fedosgad/TD4/README.md

# TD4
Schematics, PCBs and SystemVerilog simulation for extended version of TD4 CPU.

All circuit-related work done in KiCad.

Verilog file are (will be) under verilog/ folder
