fedosgad/TD4/front_panel/front_panel.kicad_pcb

## KiCad design front_panel/front_panel.kicad_pcb (2019-03-29)

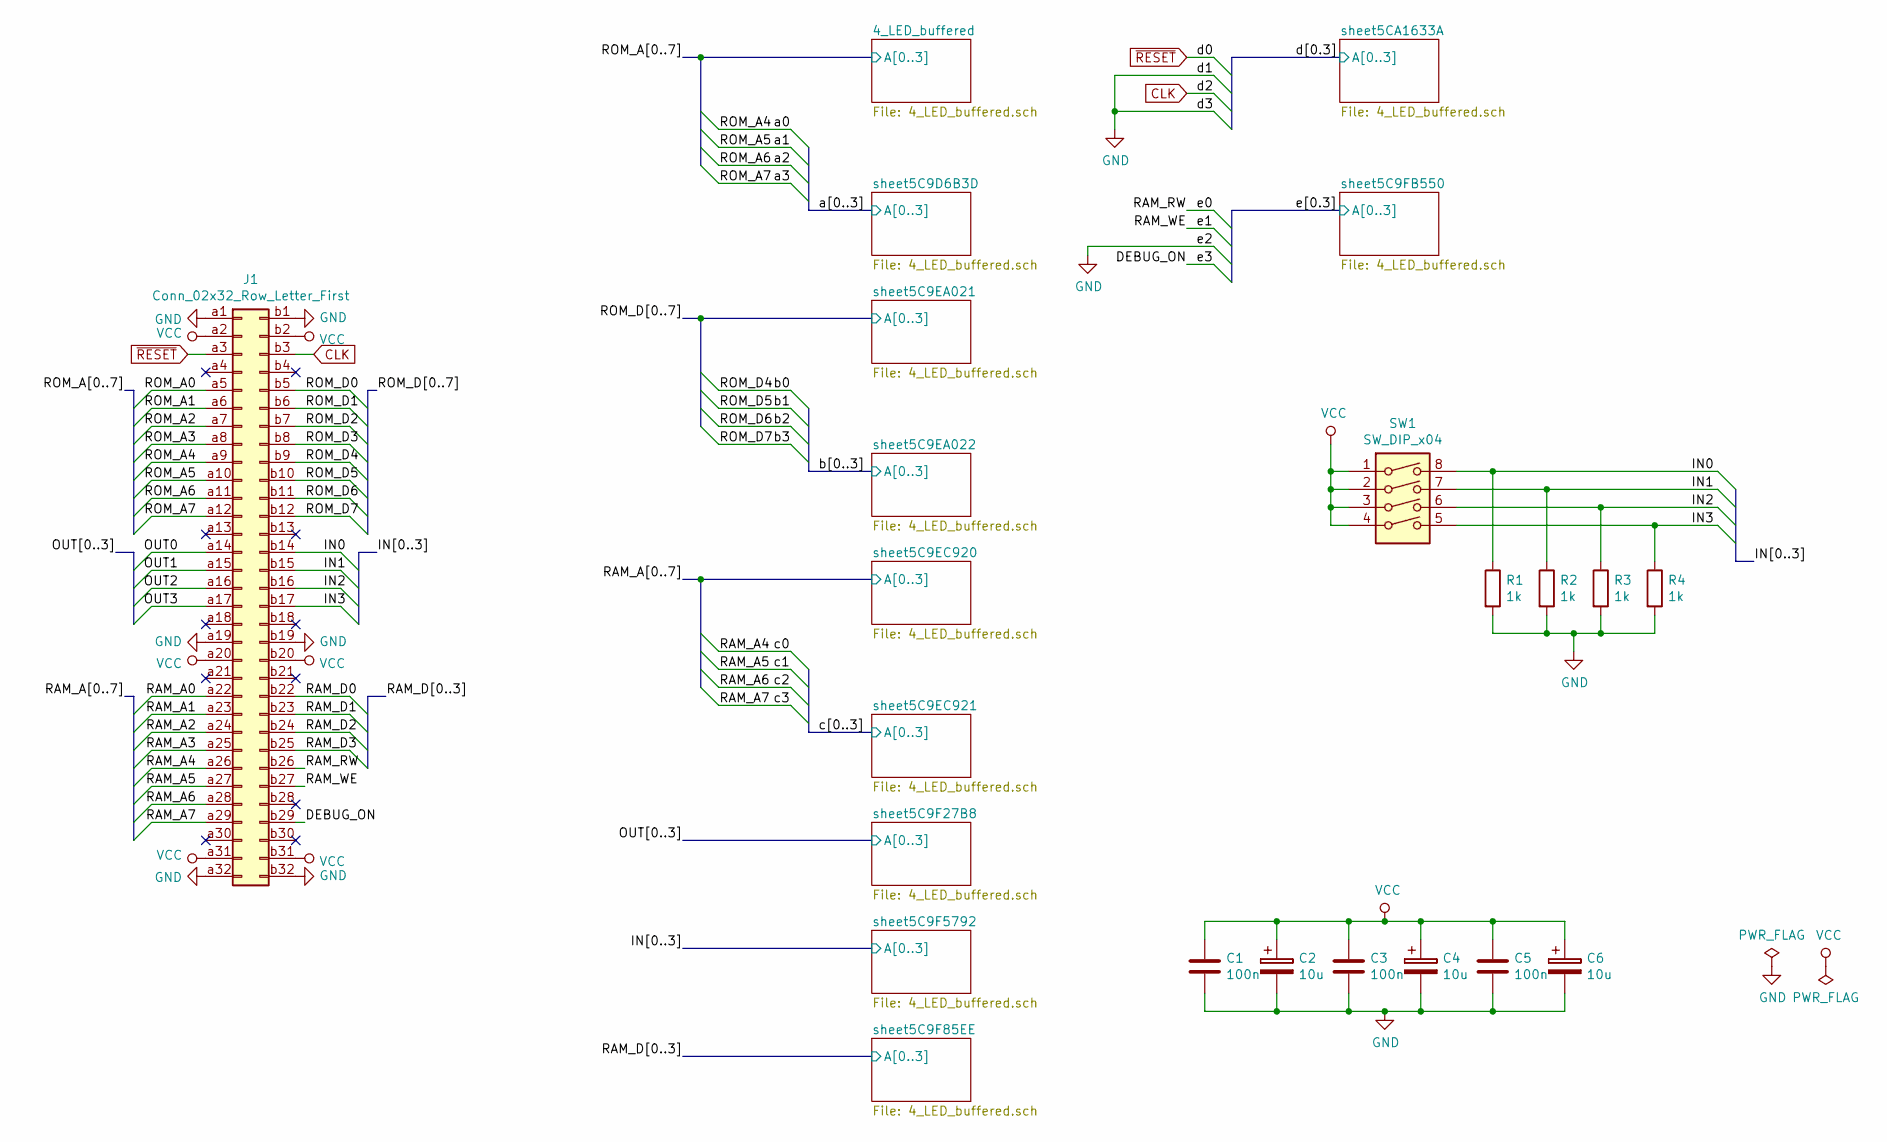
[picture p1: schematic front_panel.sch]

Parts:
C1, C3, C5: 100n; C_0805_2012Metric
C2, C4, C6: 10u; CP_EIA-3216-18_Kemet-A
J1: Conn_02x32_Row_Letter_First; DIN41612_B_2x32_Horizontal
R1, R2, R3, R4: 1k; R_0805_2012Metric
SW1: SW_DIP_x04; SW_DIP_SPSTx04_Slide_9.78x12.34mm_W7.62mm_P2.54mm

Connections:
/DEBUG_ON: J1.b29; also elsewhere on the board
/IN0: J1.b14, R1.1, SW1.8; also elsewhere on the board
/IN1: J1.b15, R2.1, SW1.7; also elsewhere on the board
/IN2: J1.b16, R3.1, SW1.6; also elsewhere on the board
/IN3: J1.b17, R4.1, SW1.5; also elsewhere on the board
/OUT0: J1.a14; also elsewhere on the board
/OUT1: J1.a15; also elsewhere on the board
/OUT2: J1.a16; also elsewhere on the board
/OUT3: J1.a17; also elsewhere on the board
/RAM_A0: J1.a22; also elsewhere on the board
/RAM_A1: J1.a23; also elsewhere on the board
/RAM_A2: J1.a24; also elsewhere on the board
/RAM_A3: J1.a25; also elsewhere on the board
/RAM_A4: J1.a26; also elsewhere on the board
/RAM_A5: J1.a27; also elsewhere on the board
/RAM_A6: J1.a28; also elsewhere on the board
/RAM_A7: J1.a29; also elsewhere on the board
/RAM_D0: J1.b22; also elsewhere on the board
/RAM_D1: J1.b23; also elsewhere on the board
/RAM_D2: J1.b24; also elsewhere on the board
/RAM_D3: J1.b25; also elsewhere on the board
/RAM_RW: J1.b26; also elsewhere on the board
/RAM_WE: J1.b27; also elsewhere on the board
/ROM_A0: J1.a5; also elsewhere on the board
/ROM_A1: J1.a6; also elsewhere on the board
/ROM_A2: J1.a7; also elsewhere on the board
/ROM_A3: J1.a8; also elsewhere on the board
/ROM_A4: J1.a9; also elsewhere on the board
/ROM_A5: J1.a10; also elsewhere on the board
/ROM_A6: J1.a11; also elsewhere on the board
/ROM_A7: J1.a12; also elsewhere on the board
/ROM_D0: J1.b5; also elsewhere on the board
/ROM_D1: J1.b6; also elsewhere on the board
/ROM_D2: J1.b7; also elsewhere on the board
/ROM_D3: J1.b8; also elsewhere on the board
/ROM_D4: J1.b9; also elsewhere on the board
/ROM_D5: J1.b10; also elsewhere on the board
/ROM_D6: J1.b11; also elsewhere on the board
/ROM_D7: J1.b12; also elsewhere on the board
CLK: J1.b3; also elsewhere on the board
GND: C1.2, C2.2, C3.2, C4.2, C5.2, C6.2, J1.a1, J1.a19, J1.a32, J1.b1, J1.b19, J1.b32, R1.2, R2.2, R3.2, R4.2; also elsewhere on the board
VCC: C1.1, C2.1, C3.1, C4.1, C5.1, C6.1, J1.a2, J1.a20, J1.a31, J1.b2, J1.b20, J1.b31, SW1.1, SW1.2, SW1.3, SW1.4; also elsewhere on the board
~RESET: J1.a3; also elsewhere on the board

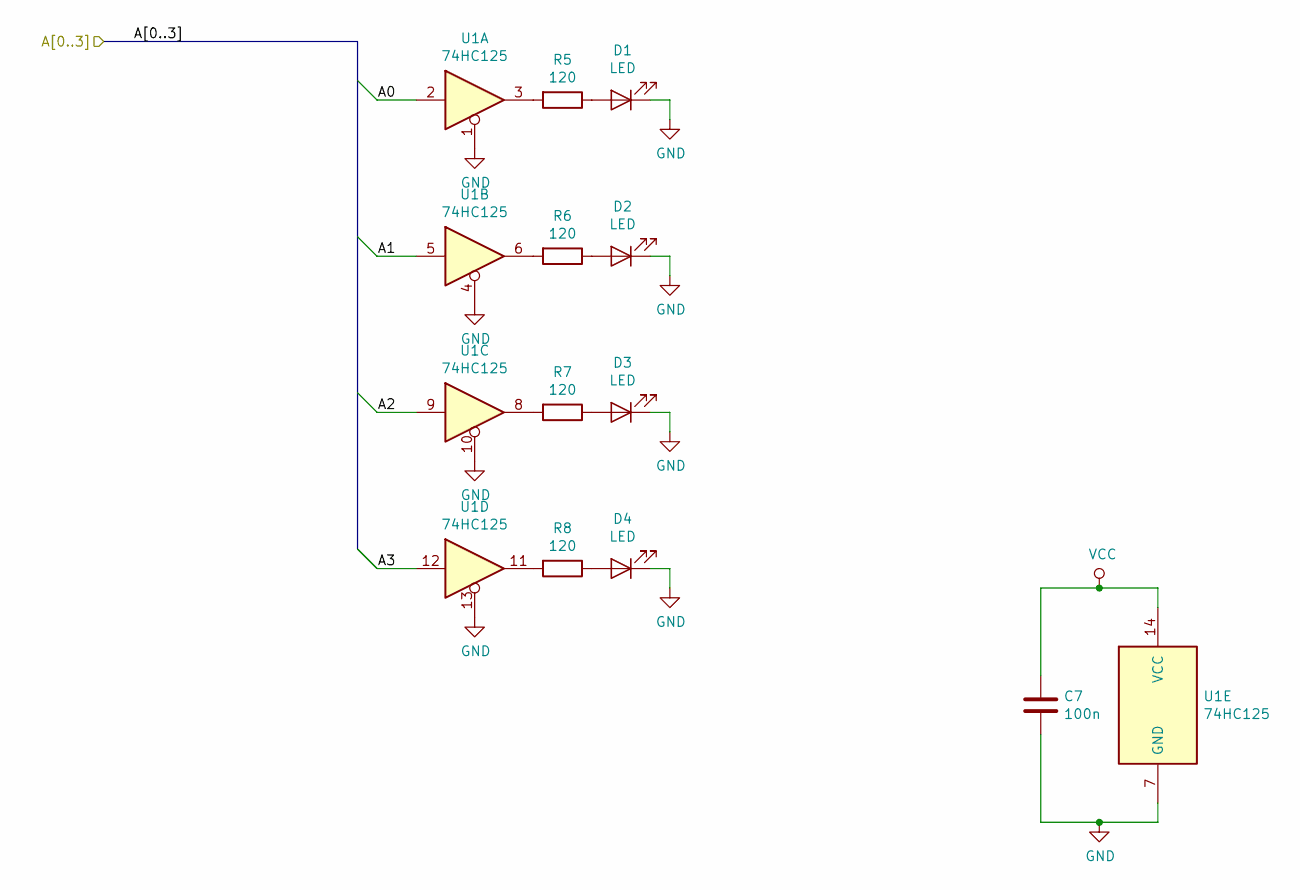
[picture p2: schematic 4_LED_buffered.sch]

Parts:
C7: 100n; C_0805_2012Metric
D1, D2, D3, D4: LED; LED_D5.0mm
R5, R6, R7, R8: 120; R_0805_2012Metric
U1: 74HC125; SOIC-14_3.9x8.7mm_P1.27mm

Connections:
/ROM_A0: U1.2; also elsewhere on the board
/ROM_A1: U1.5; also elsewhere on the board
/ROM_A2: U1.9; also elsewhere on the board
/ROM_A3: U1.12; also elsewhere on the board
GND: C7.2, D1.1 (K), D2.1 (K), D3.1 (K), D4.1 (K), U1.1, U1.4, U1.7 (GND), U1.10, U1.13; also elsewhere on the board
unnamed: D1.2 (A), R5.1
unnamed: D2.2 (A), R6.1
unnamed: D3.2 (A), R7.1
unnamed: D4.2 (A), R8.1
unnamed: R5.2, U1.3
unnamed: R6.2, U1.6
unnamed: R7.2, U1.8
unnamed: R8.2, U1.11
VCC: C7.1, U1.14 (VCC); also elsewhere on the board

Parts of its further copies:
C8, C9, C10, C11, C12, C13, C14, C15, C16, C17: 100n; C_0805_2012Metric
D5, D6, D7, D8, D9, D10, D11, D12, D13, D14, D15, D16, D17, D18, D19, D20, D21, D22, D23, D24, D25, D26, D27, D28, D29, D30, D31, D32, D33, D34, D35, D36, D37, D38, D39, D40, D41, D42, D43, D44: LED; LED_D5.0mm
R9, R10, R11, R12, R13, R14, R15, R16, R17, R18, R19, R20, R21, R22, R23, R24, R25, R26, R27, R28, R29, R30, R31, R32, R33, R34, R35, R36, R37, R38, R39, R40, R41, R42, R43, R44, R45, R46, R47, R48: 120; R_0805_2012Metric
U2, U3, U4, U5, U6, U7, U8, U9, U10, U11: 74HC125; SOIC-14_3.9x8.7mm_P1.27mm

Connections of its further copies:
/DEBUG_ON: U10.12; also elsewhere on the board
/IN0: U8.2; also elsewhere on the board
/IN1: U8.5; also elsewhere on the board
/IN2: U8.9; also elsewhere on the board
/IN3: U8.12; also elsewhere on the board
/OUT0: U7.2; also elsewhere on the board
/OUT1: U7.5; also elsewhere on the board
/OUT2: U7.9; also elsewhere on the board
/OUT3: U7.12; also elsewhere on the board
/RAM_A0: U5.2; also elsewhere on the board
/RAM_A1: U5.5; also elsewhere on the board
/RAM_A2: U5.9; also elsewhere on the board
/RAM_A3: U5.12; also elsewhere on the board
/RAM_A4: U6.2; also elsewhere on the board
/RAM_A5: U6.5; also elsewhere on the board
/RAM_A6: U6.9; also elsewhere on the board
/RAM_A7: U6.12; also elsewhere on the board
/RAM_D0: U9.2; also elsewhere on the board
/RAM_D1: U9.5; also elsewhere on the board
/RAM_D2: U9.9; also elsewhere on the board
/RAM_D3: U9.12; also elsewhere on the board
/RAM_RW: U10.2; also elsewhere on the board
/RAM_WE: U10.5; also elsewhere on the board
/ROM_A4: U2.2; also elsewhere on the board
/ROM_A5: U2.5; also elsewhere on the board
/ROM_A6: U2.9; also elsewhere on the board
/ROM_A7: U2.12; also elsewhere on the board
/ROM_D0: U3.2; also elsewhere on the board
/ROM_D1: U3.5; also elsewhere on the board
/ROM_D2: U3.9; also elsewhere on the board
/ROM_D3: U3.12; also elsewhere on the board
/ROM_D4: U4.2; also elsewhere on the board
/ROM_D5: U4.5; also elsewhere on the board
/ROM_D6: U4.9; also elsewhere on the board
/ROM_D7: U4.12; also elsewhere on the board
CLK: U11.9; also elsewhere on the board
GND: C8.2, C9.2, C10.2, C11.2, C12.2, C13.2, C14.2, C15.2, C16.2, C17.2, D5.1 (K), D6.1 (K), D7.1 (K), D8.1 (K), D9.1 (K), D10.1 (K), D11.1 (K), D12.1 (K), D13.1 (K), D14.1 (K), D15.1 (K), D16.1 (K), D17.1 (K), D18.1 (K), D19.1 (K), D20.1 (K), D21.1 (K), D22.1 (K), D23.1 (K), D24.1 (K), D25.1 (K), D26.1 (K), D27.1 (K), D28.1 (K), D29.1 (K), D30.1 (K), D31.1 (K), D32.1 (K), D33.1 (K), D34.1 (K), D35.1 (K), D36.1 (K), D37.1 (K), D38.1 (K), D39.1 (K), D40.1 (K), D41.1 (K), D42.1 (K), D43.1 (K), D44.1 (K), U2.1, U2.4, U2.7 (GND), U2.10, U2.13, U3.1, U3.4, U3.7 (GND), U3.10, U3.13, U4.1, U4.4, U4.7 (GND), U4.10, U4.13, U5.1, U5.4, U5.7 (GND), U5.10, U5.13, U6.1, U6.4, U6.7 (GND), U6.10, U6.13, U7.1, U7.4, U7.7 (GND), U7.10, U7.13, U8.1, U8.4, U8.7 (GND), U8.10, U8.13, U9.1, U9.4, U9.7 (GND), U9.10, U9.13, U10.1, U10.4, U10.7 (GND), U10.9, U10.10, U10.13, U11.1, U11.4, U11.5, U11.7 (GND), U11.10, U11.12, U11.13; also elsewhere on the board
unnamed: D5.2 (A), R9.1
unnamed: D6.2 (A), R10.1
unnamed: D7.2 (A), R11.1
unnamed: D8.2 (A), R12.1
unnamed: D9.2 (A), R13.1
unnamed: D10.2 (A), R14.1
unnamed: D11.2 (A), R15.1
unnamed: D12.2 (A), R16.1
unnamed: D13.2 (A), R17.1
unnamed: D14.2 (A), R18.1
unnamed: D15.2 (A), R19.1
unnamed: D16.2 (A), R20.1
unnamed: D17.2 (A), R21.1
unnamed: D18.2 (A), R22.1
unnamed: D19.2 (A), R23.1
unnamed: D20.2 (A), R24.1
unnamed: D21.2 (A), R25.1
unnamed: D22.2 (A), R26.1
unnamed: D23.2 (A), R27.1
unnamed: D24.2 (A), R28.1
unnamed: D25.2 (A), R29.1
unnamed: D26.2 (A), R30.1
unnamed: D27.2 (A), R31.1
unnamed: D28.2 (A), R32.1
unnamed: D29.2 (A), R33.1
unnamed: D30.2 (A), R34.1
unnamed: D31.2 (A), R35.1
unnamed: D32.2 (A), R36.1
unnamed: D33.2 (A), R37.1
unnamed: D34.2 (A), R38.1
unnamed: D35.2 (A), R39.1
unnamed: D36.2 (A), R40.1
unnamed: D37.2 (A), R41.1
unnamed: D38.2 (A), R42.1
unnamed: D39.2 (A), R43.1
unnamed: D40.2 (A), R44.1
unnamed: D41.2 (A), R45.1
unnamed: D42.2 (A), R46.1
unnamed: D43.2 (A), R47.1
unnamed: D44.2 (A), R48.1
unnamed: R9.2, U2.3
unnamed: R10.2, U2.6
unnamed: R11.2, U2.8
unnamed: R12.2, U2.11
unnamed: R13.2, U3.3
unnamed: R14.2, U3.6
unnamed: R15.2, U3.8
unnamed: R16.2, U3.11
unnamed: R17.2, U4.3
unnamed: R18.2, U4.6
unnamed: R19.2, U4.8
unnamed: R20.2, U4.11
unnamed: R21.2, U5.3
unnamed: R22.2, U5.6
unnamed: R23.2, U5.8
unnamed: R24.2, U5.11
unnamed: R25.2, U6.3
unnamed: R26.2, U6.6
unnamed: R27.2, U6.8
unnamed: R28.2, U6.11
unnamed: R29.2, U7.3
unnamed: R30.2, U7.6
unnamed: R31.2, U7.8
unnamed: R32.2, U7.11
unnamed: R33.2, U8.3
unnamed: R34.2, U8.6
unnamed: R35.2, U8.8
unnamed: R36.2, U8.11
unnamed: R37.2, U9.3
unnamed: R38.2, U9.6
unnamed: R39.2, U9.8
unnamed: R40.2, U9.11
unnamed: R41.2, U10.3
unnamed: R42.2, U10.6
unnamed: R43.2, U10.8
unnamed: R44.2, U10.11
unnamed: R45.2, U11.3
unnamed: R46.2, U11.6
unnamed: R47.2, U11.8
unnamed: R48.2, U11.11
VCC: C8.1, C9.1, C10.1, C11.1, C12.1, C13.1, C14.1, C15.1, C16.1, C17.1, U2.14 (VCC), U3.14 (VCC), U4.14 (VCC), U5.14 (VCC), U6.14 (VCC), U7.14 (VCC), U8.14 (VCC), U9.14 (VCC), U10.14 (VCC), U11.14 (VCC); also elsewhere on the board
~RESET: U11.2; also elsewhere on the board

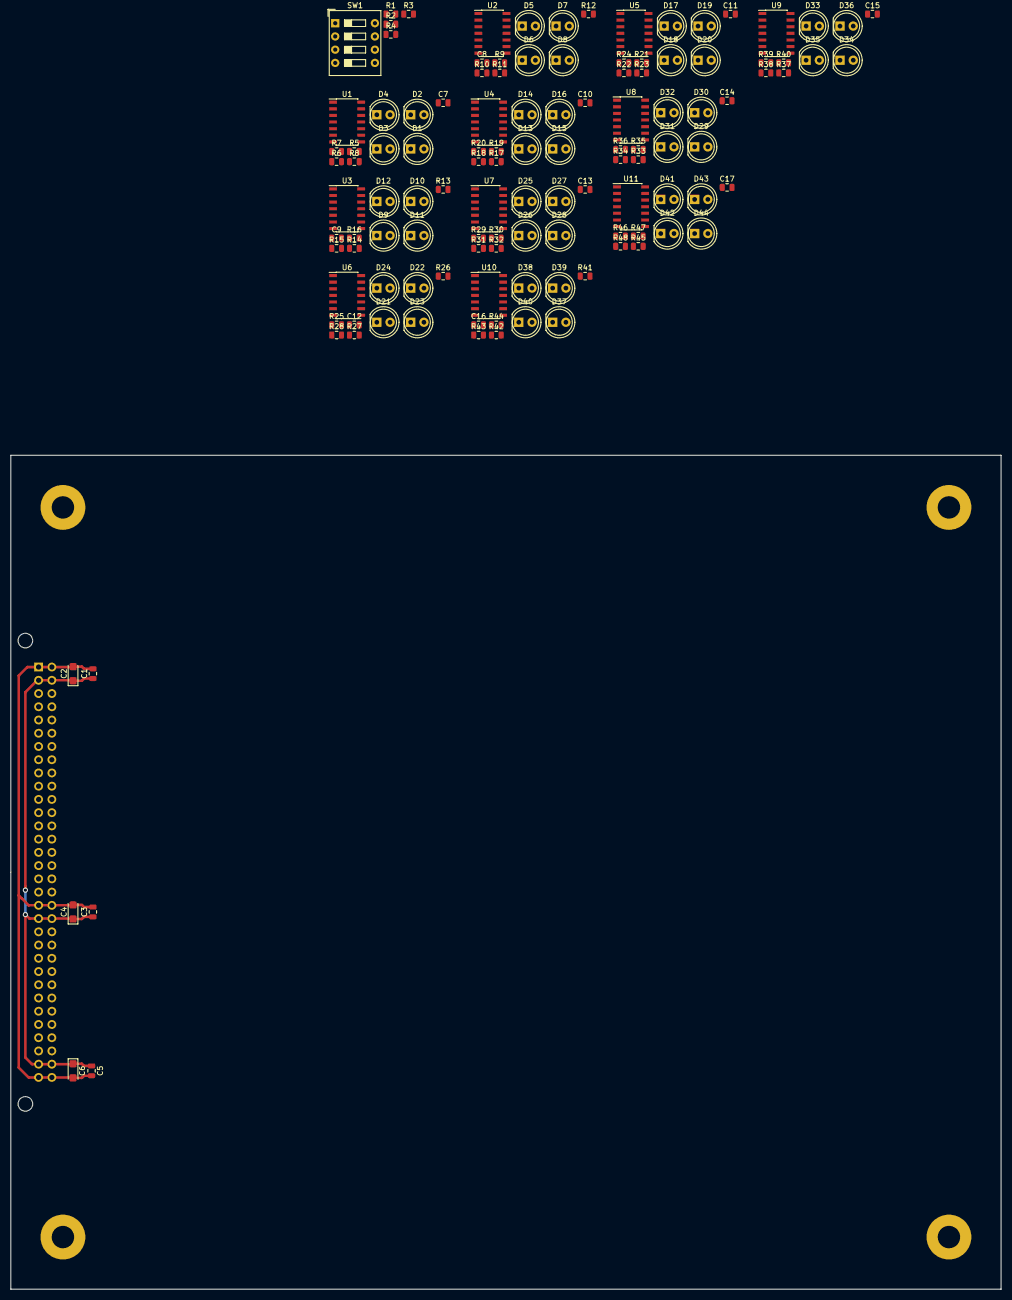
[picture p3: board front_panel.kicad_pcb from above]

Board: 2 copper layers, 190.0 x 160.0 mm, 122 parts (1 on the bottom side), 131 nets.
