fedosgad/TD4/backplane/TD4_backplane/TD4_backplane.kicad_pcb

## KiCad design backplane/TD4_backplane/TD4_backplane.kicad_pcb (2019-03-26)

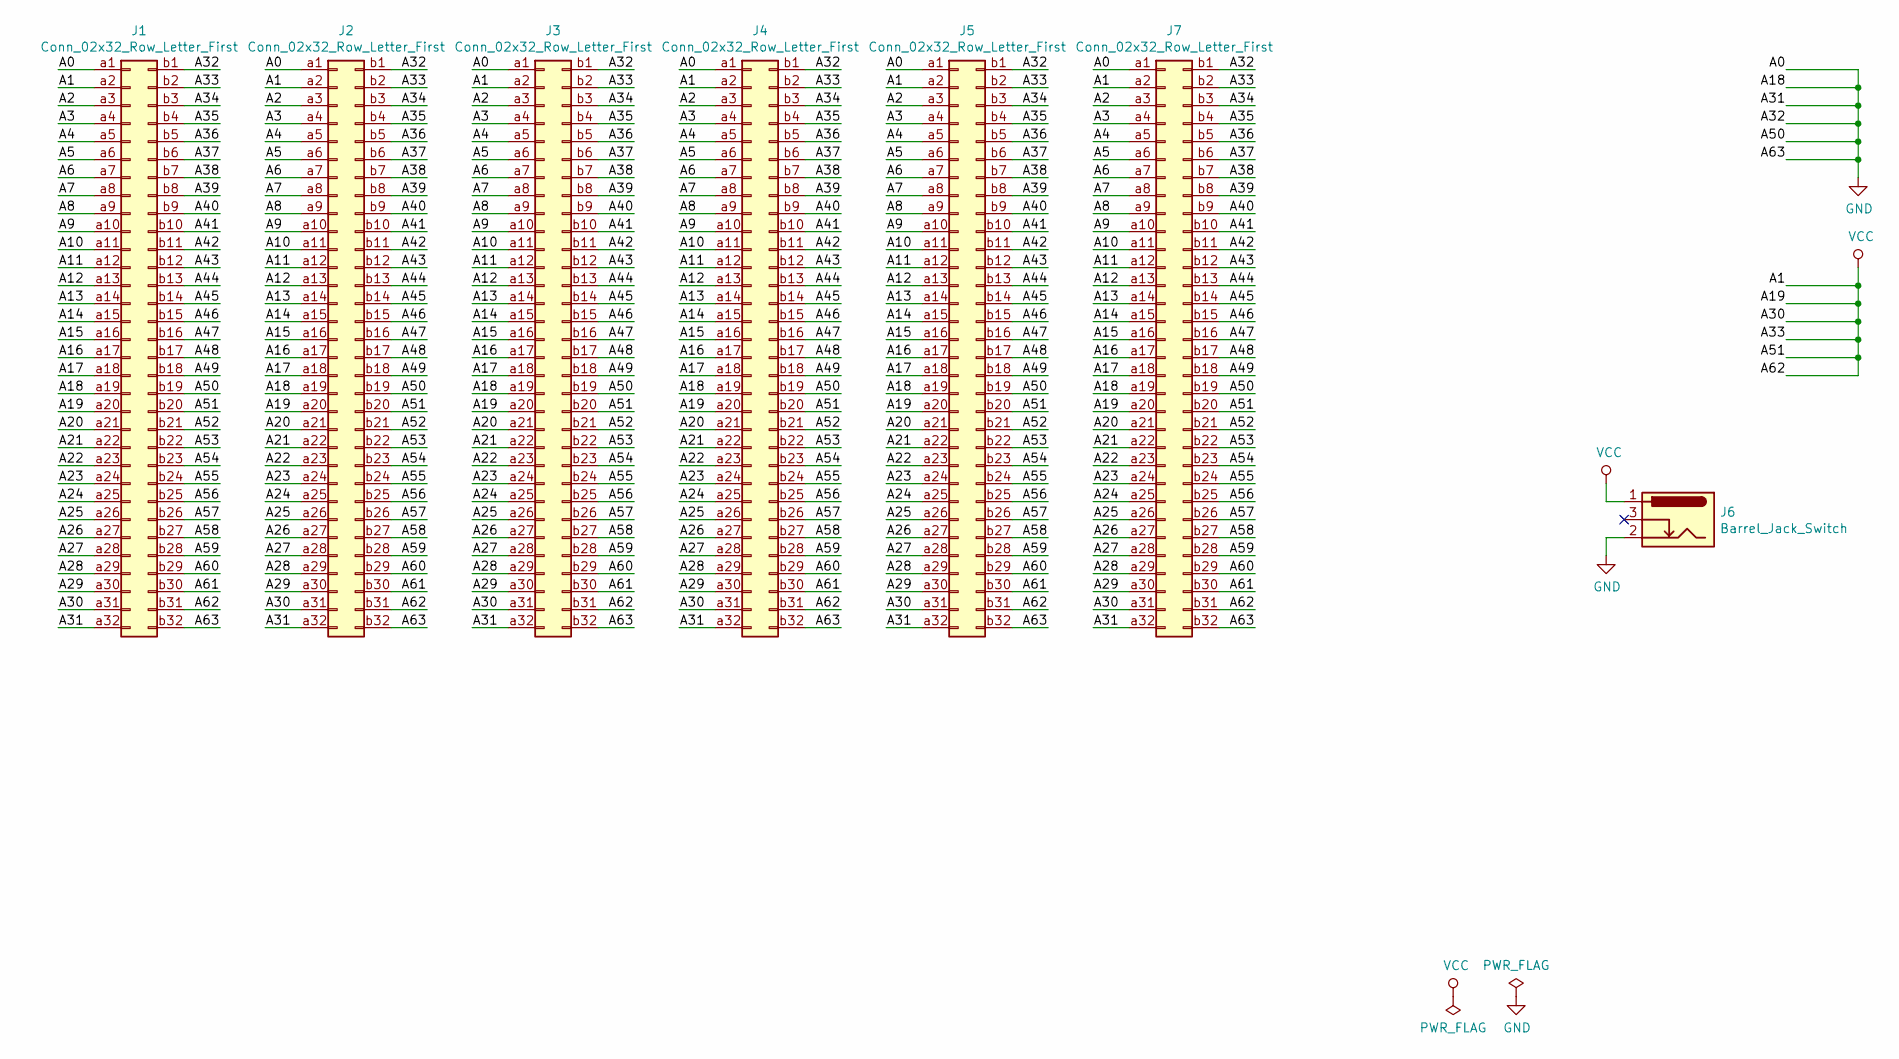
[picture p4: schematic TD4_backplane.sch]

Parts:
J1, J2, J3, J4, J5, J7: Conn_02x32_Row_Letter_First; DIN41612_B_2x32_Vertical
J6: Barrel_Jack_Switch; BarrelJack_Horizontal

Connections:
/A2: J1.a3, J2.a3, J3.a3, J4.a3, J5.a3, J7.a3
/A3: J1.a4, J2.a4, J3.a4, J4.a4, J5.a4, J7.a4
/A4: J1.a5, J2.a5, J3.a5, J4.a5, J5.a5, J7.a5
/A5: J1.a6, J2.a6, J3.a6, J4.a6, J5.a6, J7.a6
/A6: J1.a7, J2.a7, J3.a7, J4.a7, J5.a7, J7.a7
/A7: J1.a8, J2.a8, J3.a8, J4.a8, J5.a8, J7.a8
/A8: J1.a9, J2.a9, J3.a9, J4.a9, J5.a9, J7.a9
/A9: J1.a10, J2.a10, J3.a10, J4.a10, J5.a10, J7.a10
/A10: J1.a11, J2.a11, J3.a11, J4.a11, J5.a11, J7.a11
/A11: J1.a12, J2.a12, J3.a12, J4.a12, J5.a12, J7.a12
/A12: J1.a13, J2.a13, J3.a13, J4.a13, J5.a13, J7.a13
/A13: J1.a14, J2.a14, J3.a14, J4.a14, J5.a14, J7.a14
/A14: J1.a15, J2.a15, J3.a15, J4.a15, J5.a15, J7.a15
/A15: J1.a16, J2.a16, J3.a16, J4.a16, J5.a16, J7.a16
/A16: J1.a17, J2.a17, J3.a17, J4.a17, J5.a17, J7.a17
/A17: J1.a18, J2.a18, J3.a18, J4.a18, J5.a18, J7.a18
/A20: J1.a21, J2.a21, J3.a21, J4.a21, J5.a21, J7.a21
/A21: J1.a22, J2.a22, J3.a22, J4.a22, J5.a22, J7.a22
/A22: J1.a23, J2.a23, J3.a23, J4.a23, J5.a23, J7.a23
/A23: J1.a24, J2.a24, J3.a24, J4.a24, J5.a24, J7.a24
/A24: J1.a25, J2.a25, J3.a25, J4.a25, J5.a25, J7.a25
/A25: J1.a26, J2.a26, J3.a26, J4.a26, J5.a26, J7.a26
/A26: J1.a27, J2.a27, J3.a27, J4.a27, J5.a27, J7.a27
/A27: J1.a28, J2.a28, J3.a28, J4.a28, J5.a28, J7.a28
/A28: J1.a29, J2.a29, J3.a29, J4.a29, J5.a29, J7.a29
/A29: J1.a30, J2.a30, J3.a30, J4.a30, J5.a30, J7.a30
/A34: J1.b3, J2.b3, J3.b3, J4.b3, J5.b3, J7.b3
/A35: J1.b4, J2.b4, J3.b4, J4.b4, J5.b4, J7.b4
/A36: J1.b5, J2.b5, J3.b5, J4.b5, J5.b5, J7.b5
/A37: J1.b6, J2.b6, J3.b6, J4.b6, J5.b6, J7.b6
/A38: J1.b7, J2.b7, J3.b7, J4.b7, J5.b7, J7.b7
/A39: J1.b8, J2.b8, J3.b8, J4.b8, J5.b8, J7.b8
/A40: J1.b9, J2.b9, J3.b9, J4.b9, J5.b9, J7.b9
/A41: J1.b10, J2.b10, J3.b10, J4.b10, J5.b10, J7.b10
/A42: J1.b11, J2.b11, J3.b11, J4.b11, J5.b11, J7.b11
/A43: J1.b12, J2.b12, J3.b12, J4.b12, J5.b12, J7.b12
/A44: J1.b13, J2.b13, J3.b13, J4.b13, J5.b13, J7.b13
/A45: J1.b14, J2.b14, J3.b14, J4.b14, J5.b14, J7.b14
/A46: J1.b15, J2.b15, J3.b15, J4.b15, J5.b15, J7.b15
/A47: J1.b16, J2.b16, J3.b16, J4.b16, J5.b16, J7.b16
/A48: J1.b17, J2.b17, J3.b17, J4.b17, J5.b17, J7.b17
/A49: J1.b18, J2.b18, J3.b18, J4.b18, J5.b18, J7.b18
/A52: J1.b21, J2.b21, J3.b21, J4.b21, J5.b21, J7.b21
/A53: J1.b22, J2.b22, J3.b22, J4.b22, J5.b22, J7.b22
/A54: J1.b23, J2.b23, J3.b23, J4.b23, J5.b23, J7.b23
/A55: J1.b24, J2.b24, J3.b24, J4.b24, J5.b24, J7.b24
/A56: J1.b25, J2.b25, J3.b25, J4.b25, J5.b25, J7.b25
/A57: J1.b26, J2.b26, J3.b26, J4.b26, J5.b26, J7.b26
/A58: J1.b27, J2.b27, J3.b27, J4.b27, J5.b27, J7.b27
/A59: J1.b28, J2.b28, J3.b28, J4.b28, J5.b28, J7.b28
/A60: J1.b29, J2.b29, J3.b29, J4.b29, J5.b29, J7.b29
/A61: J1.b30, J2.b30, J3.b30, J4.b30, J5.b30, J7.b30
GND: J1.a1, J1.a19, J1.a32, J1.b1, J1.b19, J1.b32, J2.a1, J2.a19, J2.a32, J2.b1, J2.b19, J2.b32, J3.a1, J3.a19, J3.a32, J3.b1, J3.b19, J3.b32, J4.a1, J4.a19, J4.a32, J4.b1, J4.b19, J4.b32, J5.a1, J5.a19, J5.a32, J5.b1, J5.b19, J5.b32, J6.2, J7.a1, J7.a19, J7.a32, J7.b1, J7.b19, J7.b32
VCC: J1.a2, J1.a20, J1.a31, J1.b2, J1.b20, J1.b31, J2.a2, J2.a20, J2.a31, J2.b2, J2.b20, J2.b31, J3.a2, J3.a20, J3.a31, J3.b2, J3.b20, J3.b31, J4.a2, J4.a20, J4.a31, J4.b2, J4.b20, J4.b31, J5.a2, J5.a20, J5.a31, J5.b2, J5.b20, J5.b31, J6.1, J7.a2, J7.a20, J7.a31, J7.b2, J7.b20, J7.b31

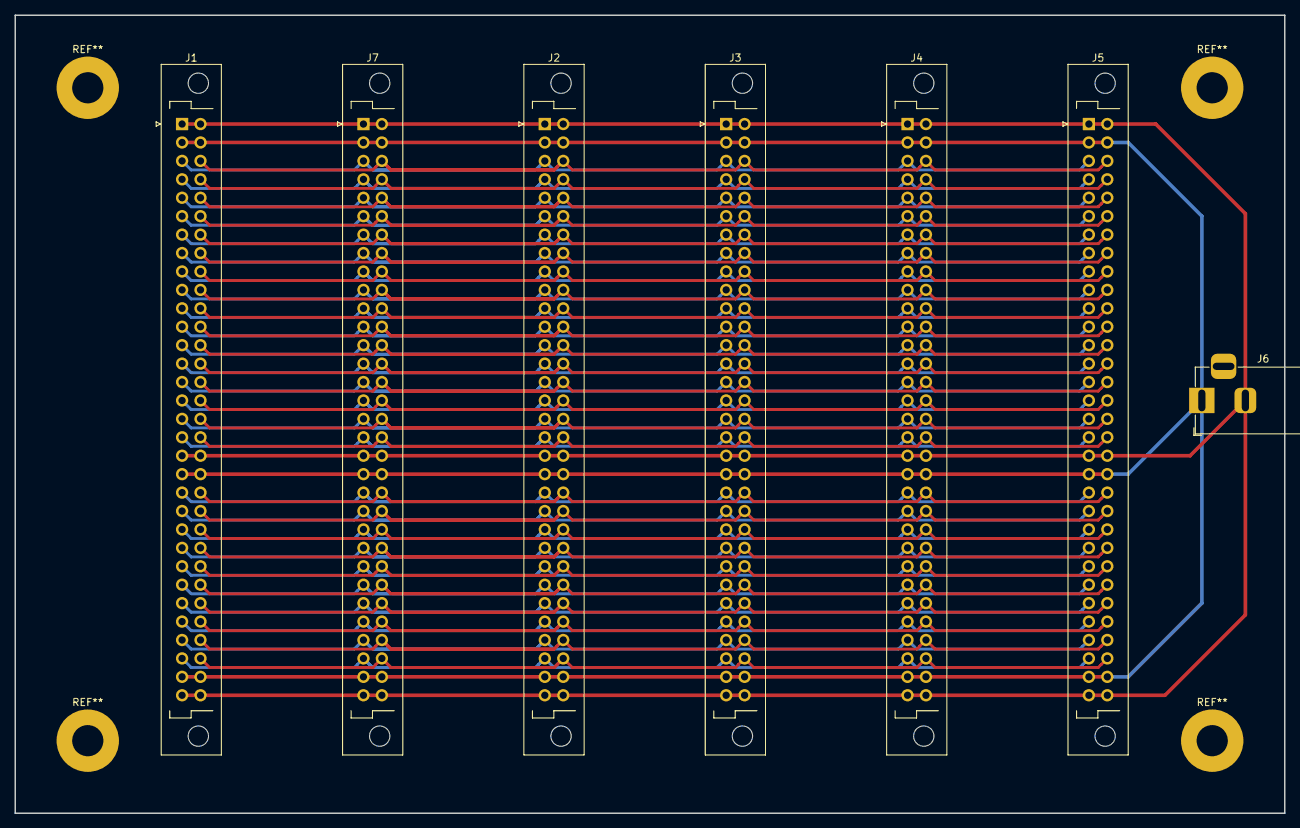
[picture p5: board TD4_backplane.kicad_pcb from above]

Board: 2 copper layers, 175.0 x 110.0 mm, 7 parts (0 on the bottom side), 54 nets.
