fedosgad/TD4/clock_reset/clock_reset.kicad_pcb

## KiCad design clock_reset/clock_reset.kicad_pcb (2019-03-23)

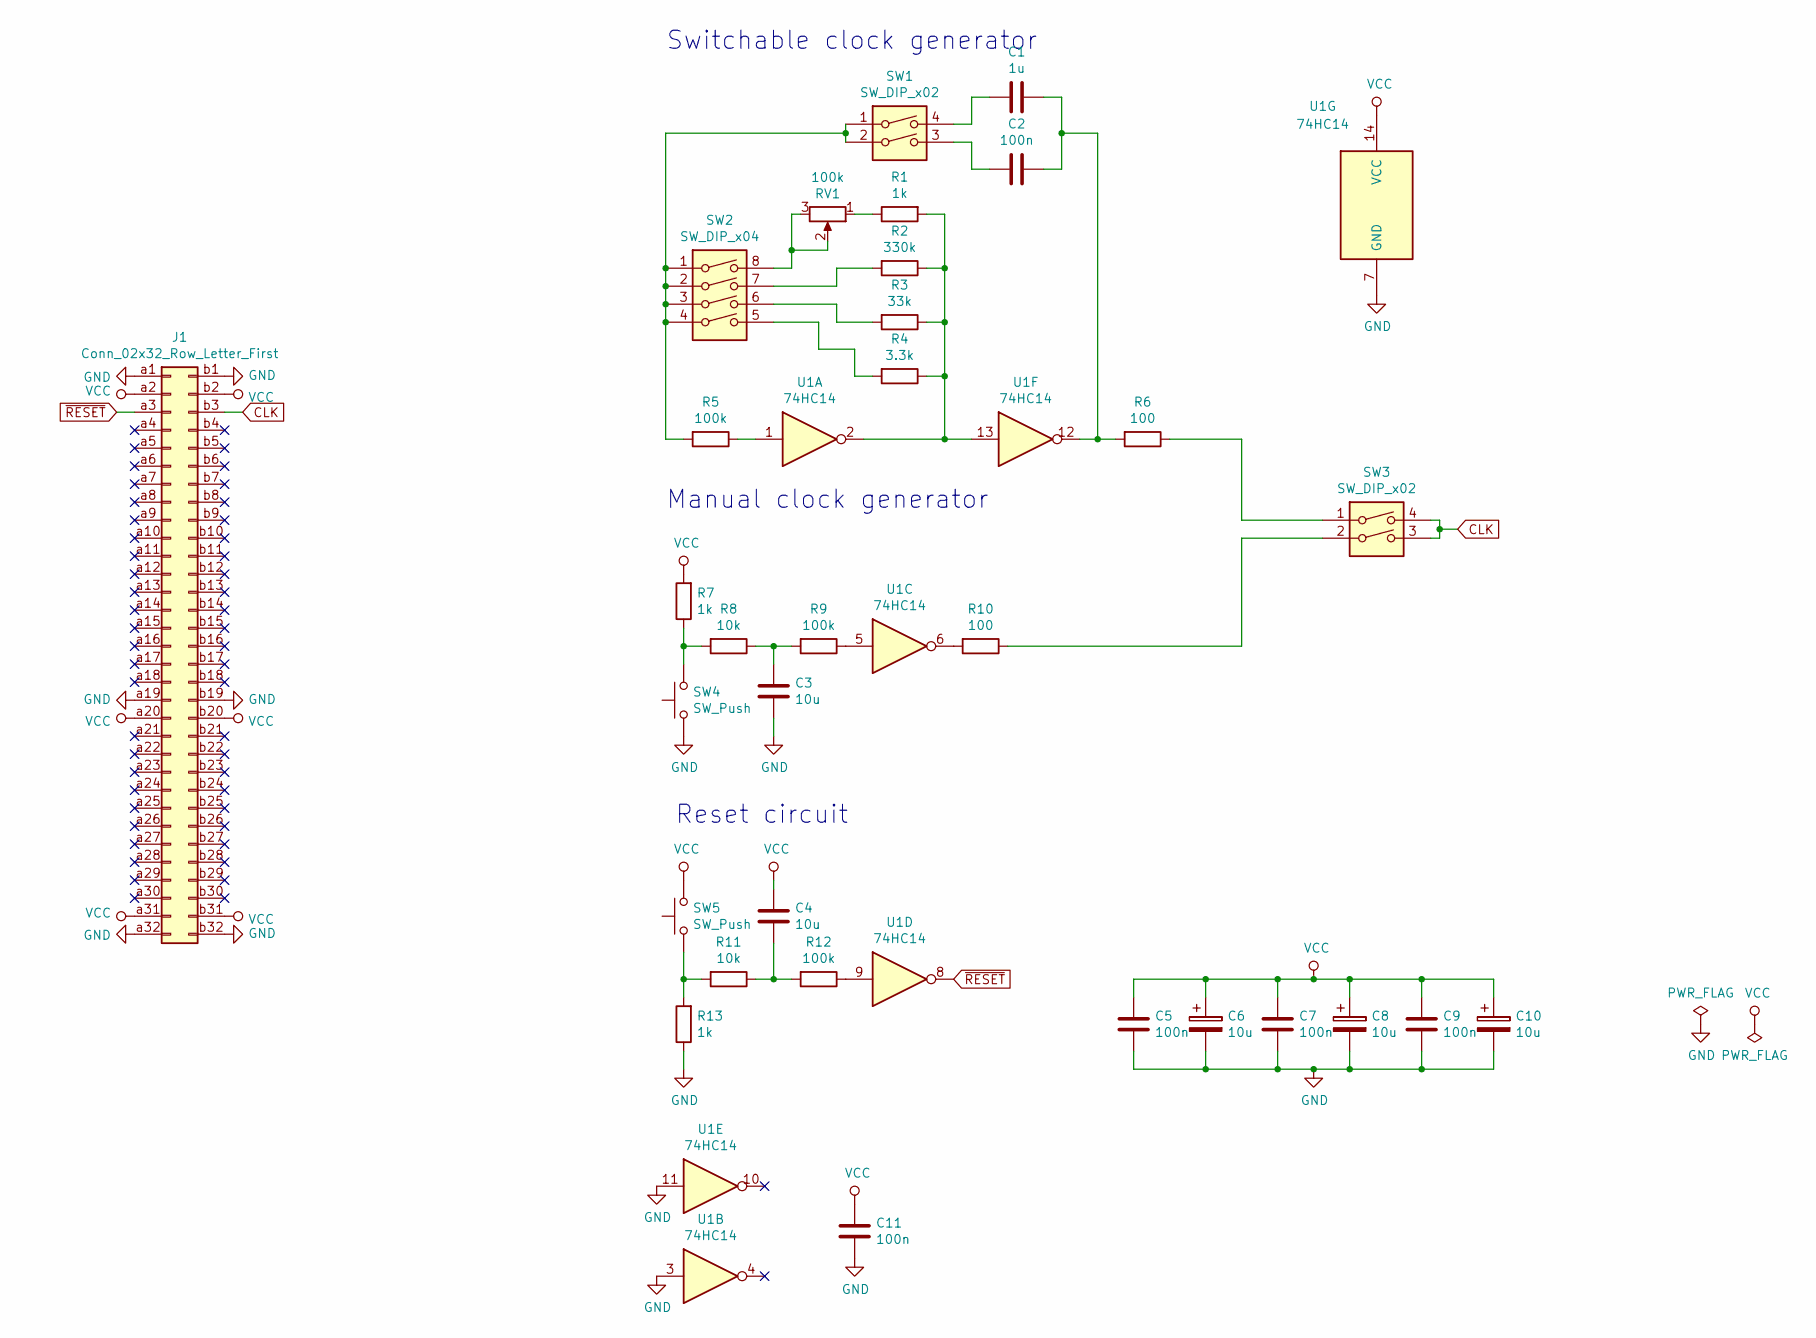
[picture p6: schematic clock_reset.sch]

Parts:
C1: 1u; C_0805_2012Metric
C2, C5, C7, C9, C11: 100n; C_0805_2012Metric
C3, C4, C6, C8, C10: 10u; CP_EIA-3216-18_Kemet-A
J1: Conn_02x32_Row_Letter_First; DIN41612_B_2x32_Horizontal
R1, R7, R13: 1k; R_0805_2012Metric
R2: 330k; R_0805_2012Metric
R3: 33k; R_0805_2012Metric
R4: 3.3k; R_0805_2012Metric
R5, R9, R12: 100k; R_0805_2012Metric
R6, R10: 100; R_0805_2012Metric
R8, R11: 10k; R_0805_2012Metric
RV1: 100k; Potentiometer_Piher_T-16H_Single_Horizontal
SW1, SW3: SW_DIP_x02; SW_DIP_SPSTx02_Slide_9.78x7.26mm_W7.62mm_P2.54mm
SW2: SW_DIP_x04; SW_DIP_SPSTx04_Slide_9.78x12.34mm_W7.62mm_P2.54mm
SW4, SW5: SW_Push; SW_PUSH_6mm
U1: 74HC14; SOIC-14_3.9x8.7mm_P1.27mm

Connections:
CLK: J1.b3, SW3.3, SW3.4
GND: C3.2, C5.2, C6.2, C7.2, C8.2, C9.2, C10.2, C11.2, J1.a1, J1.a19, J1.a32, J1.b1, J1.b19, J1.b32, R13.1, SW4.1, U1.3, U1.7 (GND), U1.11
unnamed: C1.1, C2.1, R6.2, U1.12
unnamed: C1.2, SW1.4
unnamed: C2.2, SW1.3
unnamed: C3.1, R8.1, R9.2
unnamed: C4.2, R11.1, R12.2
unnamed: R1.1, RV1.1
unnamed: R1.2, R2.1, R3.1, R4.1, U1.2, U1.13
unnamed: R2.2, SW2.7
unnamed: R3.2, SW2.6
unnamed: R4.2, SW2.5
unnamed: R5.1, U1.1
unnamed: R5.2, SW1.1, SW1.2, SW2.1, SW2.2, SW2.3, SW2.4
unnamed: R6.1, SW3.1
unnamed: R7.1, R8.2, SW4.2
unnamed: R9.1, U1.5
unnamed: R10.1, SW3.2
unnamed: R10.2, U1.6
unnamed: R11.2, R13.2, SW5.1
unnamed: R12.1, U1.9
unnamed: RV1.2, RV1.3, SW2.8
VCC: C4.1, C5.1, C6.1, C7.1, C8.1, C9.1, C10.1, C11.1, J1.a2, J1.a20, J1.a31, J1.b2, J1.b20, J1.b31, R7.2, SW5.2, U1.14 (VCC)
~RESET: J1.a3, U1.8

Notes on the sheet:
Switchable clock generator
Manual clock generator
Reset circuit

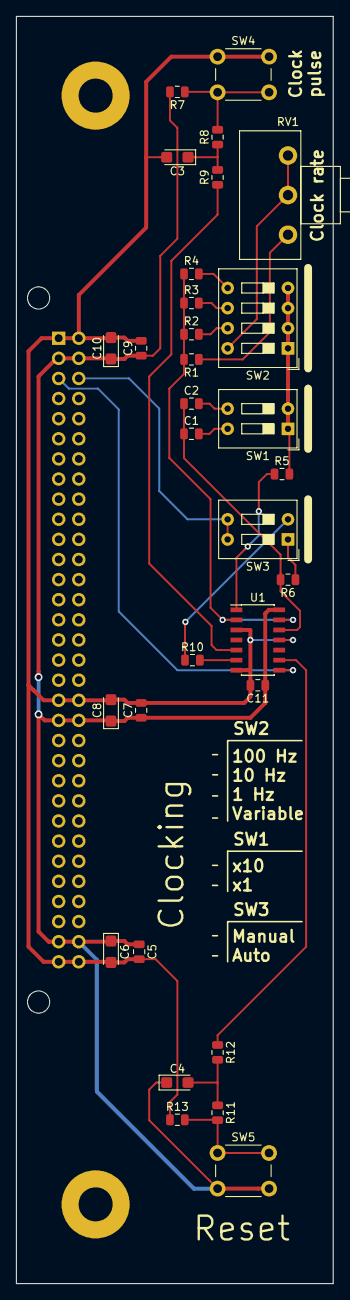
[picture p7: board clock_reset.kicad_pcb from above]

Board: 2 copper layers, 40.0 x 160.0 mm, 32 parts (1 on the bottom side), 24 nets.
