fedosgad/TD4/RAM/TD4_RAM/TD4_RAM.kicad_pcb

## KiCad design RAM/TD4_RAM/TD4_RAM.kicad_pcb (2019-02-27)

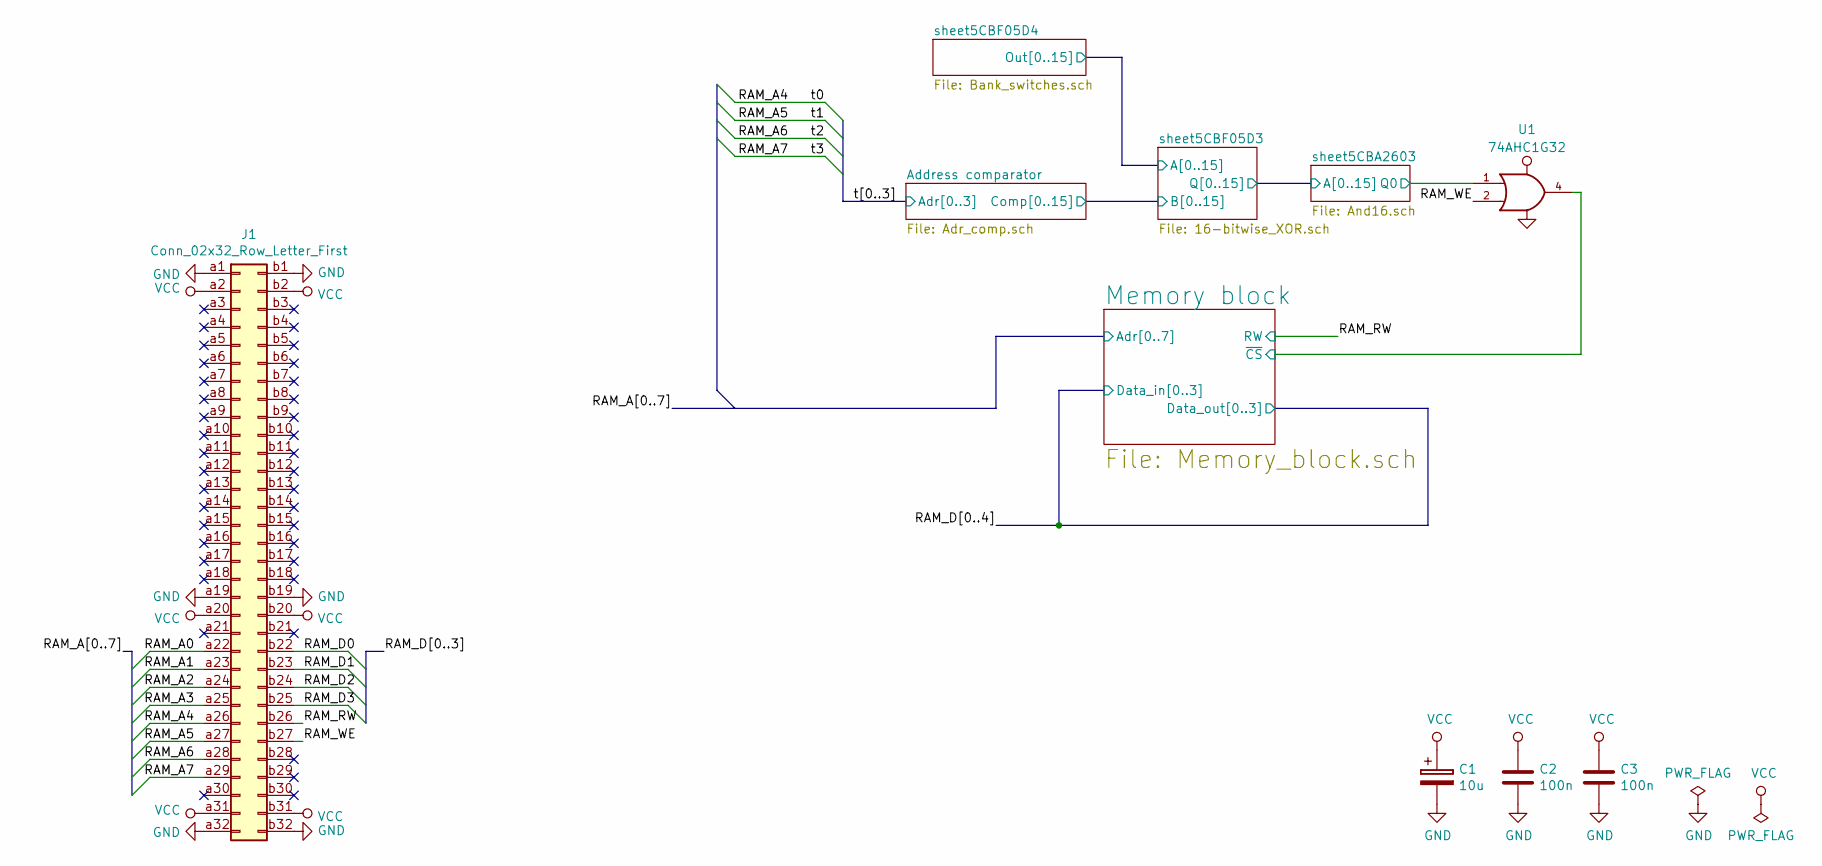
[picture p8: schematic TD4_RAM.sch, TD4 RAM module]

Parts:
C1: 10u; CP_EIA-3216-18_Kemet-A
C2, C3: 100n; C_0805_2012Metric
J1: Conn_02x32_Row_Letter_First; DIN41612_B_2x32_Horizontal
U1: 74AHC1G32; SOT-23-5

Connections:
/Memory block/~CS: U1.4; also elsewhere on the board
/RAM_A0: J1.a22; also elsewhere on the board
/RAM_A1: J1.a23; also elsewhere on the board
/RAM_A2: J1.a24; also elsewhere on the board
/RAM_A3: J1.a25; also elsewhere on the board
/RAM_A4: J1.a26; also elsewhere on the board
/RAM_A5: J1.a27; also elsewhere on the board
/RAM_A6: J1.a28; also elsewhere on the board
/RAM_A7: J1.a29; also elsewhere on the board
/RAM_RW: J1.b26; also elsewhere on the board
/RAM_WE: J1.b27, U1.2
/sheet5CBA2603/Q0: U1.1; also elsewhere on the board
VCC: C1.1, C2.1, C3.1, J1.a2, J1.a20, J1.a31, J1.b2, J1.b20, J1.b31, U1.5 (VCC); also elsewhere on the board
