fedosgad/TD4/RAM/TD4_RAM/TD4_RAM.kicad_pcb

## KiCad design RAM/TD4_RAM/TD4_RAM.kicad_pcb (continued)

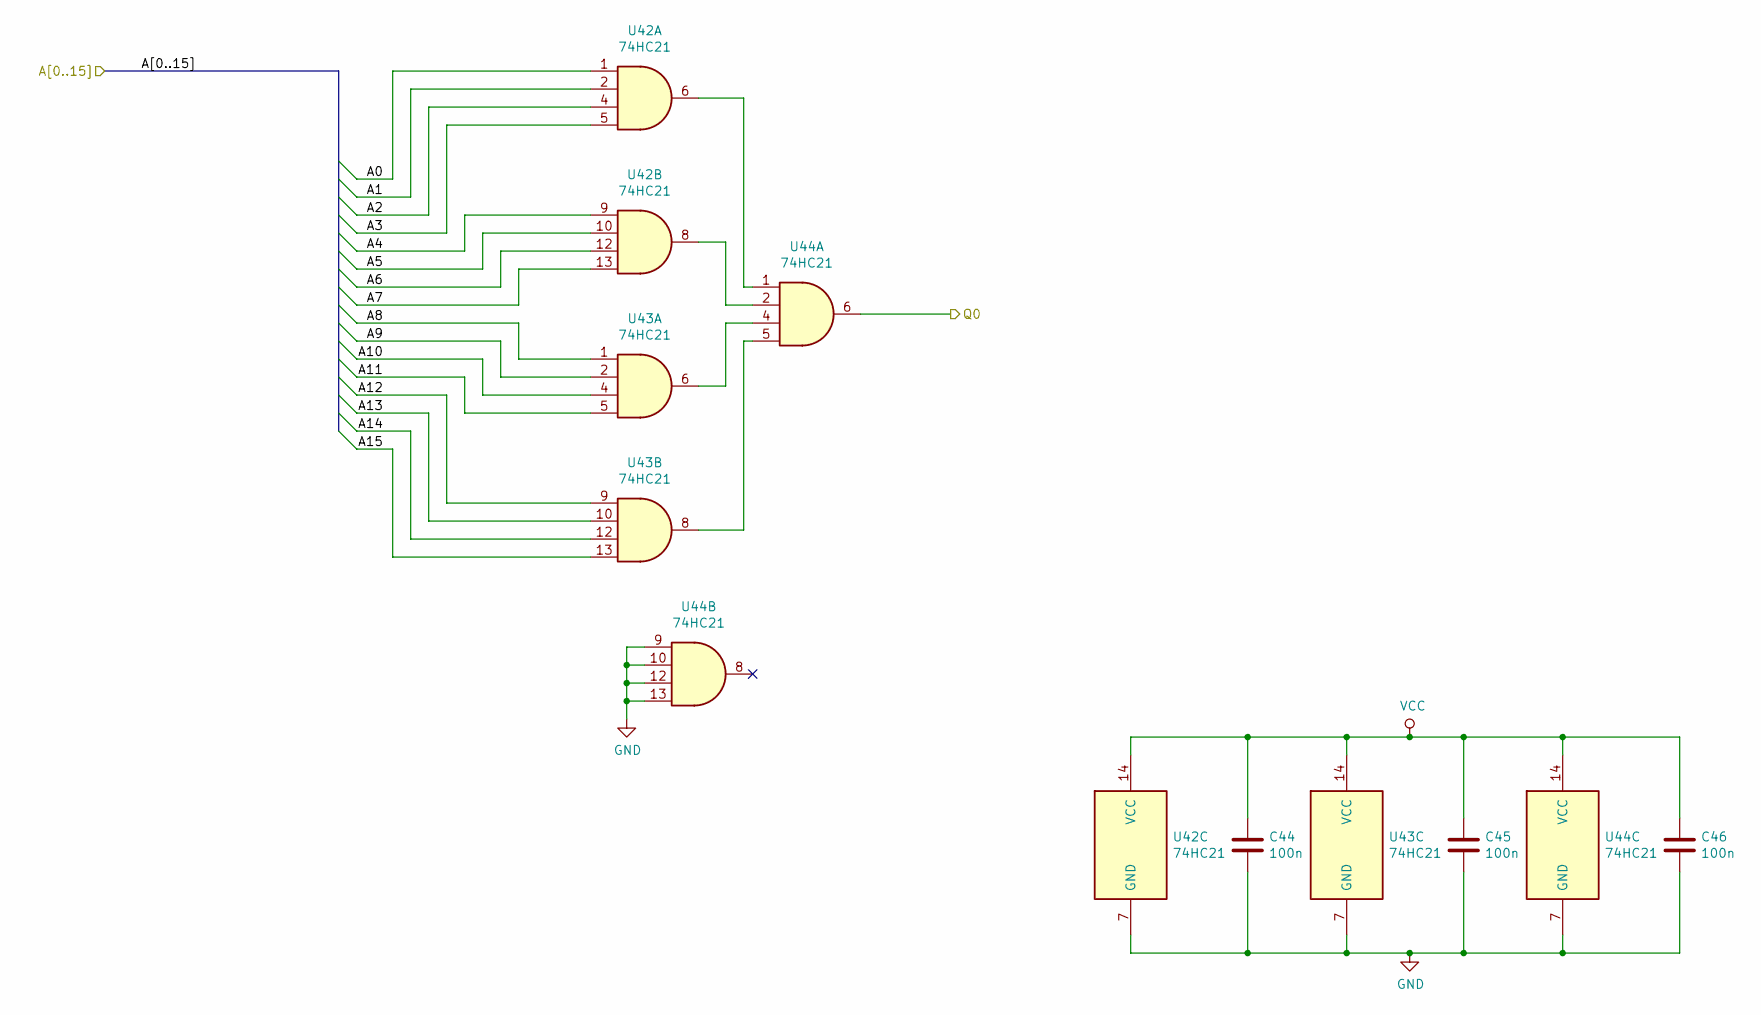
[picture p9: schematic And16.sch]

Parts:
C44, C45, C46: 100n; C_0805_2012Metric
U42, U43, U44: 74HC21; SOIC-14_3.9x8.7mm_P1.27mm

Connections:
/sheet5CBA2603/A0: U42.1; also elsewhere on the board
/sheet5CBA2603/A1: U42.2; also elsewhere on the board
/sheet5CBA2603/A2: U42.4; also elsewhere on the board
/sheet5CBA2603/A3: U42.5; also elsewhere on the board
/sheet5CBA2603/A4: U42.9; also elsewhere on the board
/sheet5CBA2603/A5: U42.10; also elsewhere on the board
/sheet5CBA2603/A6: U42.12; also elsewhere on the board
/sheet5CBA2603/A7: U42.13; also elsewhere on the board
/sheet5CBA2603/A8: U43.1; also elsewhere on the board
/sheet5CBA2603/A9: U43.2; also elsewhere on the board
/sheet5CBA2603/A10: U43.4; also elsewhere on the board
/sheet5CBA2603/A11: U43.5; also elsewhere on the board
/sheet5CBA2603/A12: U43.9; also elsewhere on the board
/sheet5CBA2603/A13: U43.10; also elsewhere on the board
/sheet5CBA2603/A14: U43.12; also elsewhere on the board
/sheet5CBA2603/A15: U43.13; also elsewhere on the board
/sheet5CBA2603/Q0: U44.6; also elsewhere on the board
unnamed: U42.6, U44.1
unnamed: U42.8, U44.2
unnamed: U43.6, U44.4
unnamed: U43.8, U44.5
VCC: C44.1, C45.1, C46.1, U42.14 (VCC), U43.14 (VCC), U44.14 (VCC); also elsewhere on the board

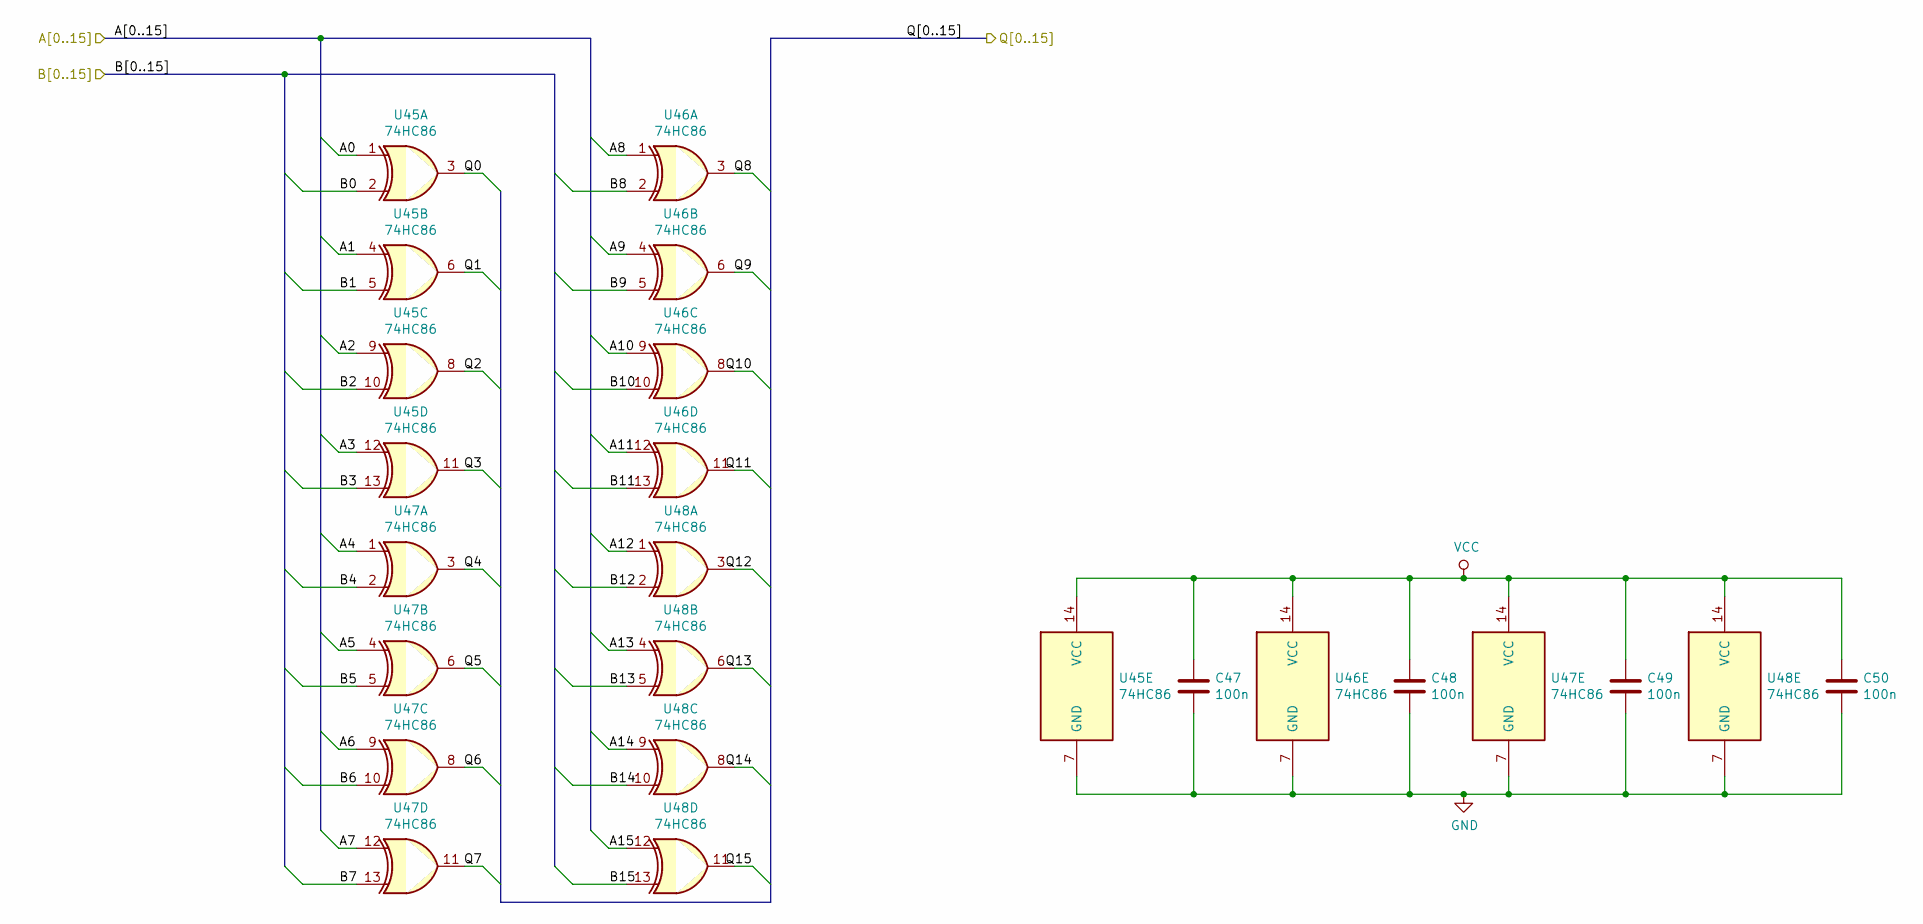
[picture p10: schematic 16-bitwise_XOR.sch]

Parts:
C47, C48, C49, C50: 100n; C_0805_2012Metric
U45, U46, U47, U48: 74HC86; SOIC-14_3.9x8.7mm_P1.27mm

Connections:
/sheet5CBA2603/A0: U45.3; also elsewhere on the board
/sheet5CBA2603/A1: U45.6; also elsewhere on the board
/sheet5CBA2603/A2: U45.8; also elsewhere on the board
/sheet5CBA2603/A3: U45.11; also elsewhere on the board
/sheet5CBA2603/A4: U47.3; also elsewhere on the board
/sheet5CBA2603/A5: U47.6; also elsewhere on the board
/sheet5CBA2603/A6: U47.8; also elsewhere on the board
/sheet5CBA2603/A7: U47.11; also elsewhere on the board
/sheet5CBA2603/A8: U46.3; also elsewhere on the board
/sheet5CBA2603/A9: U46.6; also elsewhere on the board
/sheet5CBA2603/A10: U46.8; also elsewhere on the board
/sheet5CBA2603/A11: U46.11; also elsewhere on the board
/sheet5CBA2603/A12: U48.3; also elsewhere on the board
/sheet5CBA2603/A13: U48.6; also elsewhere on the board
/sheet5CBA2603/A14: U48.8; also elsewhere on the board
/sheet5CBA2603/A15: U48.11; also elsewhere on the board
/sheet5CBF05D3/A0: U45.1; also elsewhere on the board
/sheet5CBF05D3/A1: U45.4; also elsewhere on the board
/sheet5CBF05D3/A2: U45.9; also elsewhere on the board
/sheet5CBF05D3/A3: U45.12; also elsewhere on the board
/sheet5CBF05D3/A4: U47.1; also elsewhere on the board
/sheet5CBF05D3/A5: U47.4; also elsewhere on the board
/sheet5CBF05D3/A6: U47.9; also elsewhere on the board
/sheet5CBF05D3/A7: U47.12; also elsewhere on the board
/sheet5CBF05D3/A8: U46.1; also elsewhere on the board
/sheet5CBF05D3/A9: U46.4; also elsewhere on the board
/sheet5CBF05D3/A10: U46.9; also elsewhere on the board
/sheet5CBF05D3/A11: U46.12; also elsewhere on the board
/sheet5CBF05D3/A12: U48.1; also elsewhere on the board
/sheet5CBF05D3/A13: U48.4; also elsewhere on the board
/sheet5CBF05D3/A14: U48.9; also elsewhere on the board
/sheet5CBF05D3/A15: U48.12; also elsewhere on the board
/sheet5CBF05D3/B0: U45.2; also elsewhere on the board
/sheet5CBF05D3/B1: U45.5; also elsewhere on the board
/sheet5CBF05D3/B2: U45.10; also elsewhere on the board
/sheet5CBF05D3/B3: U45.13; also elsewhere on the board
/sheet5CBF05D3/B4: U47.2; also elsewhere on the board
/sheet5CBF05D3/B5: U47.5; also elsewhere on the board
/sheet5CBF05D3/B6: U47.10; also elsewhere on the board
/sheet5CBF05D3/B7: U47.13; also elsewhere on the board
/sheet5CBF05D3/B8: U46.2; also elsewhere on the board
/sheet5CBF05D3/B9: U46.5; also elsewhere on the board
/sheet5CBF05D3/B10: U46.10; also elsewhere on the board
/sheet5CBF05D3/B11: U46.13; also elsewhere on the board
/sheet5CBF05D3/B12: U48.2; also elsewhere on the board
/sheet5CBF05D3/B13: U48.5; also elsewhere on the board
/sheet5CBF05D3/B14: U48.10; also elsewhere on the board
/sheet5CBF05D3/B15: U48.13; also elsewhere on the board
VCC: C47.1, C48.1, C49.1, C50.1, U45.14 (VCC), U46.14 (VCC), U47.14 (VCC), U48.14 (VCC); also elsewhere on the board

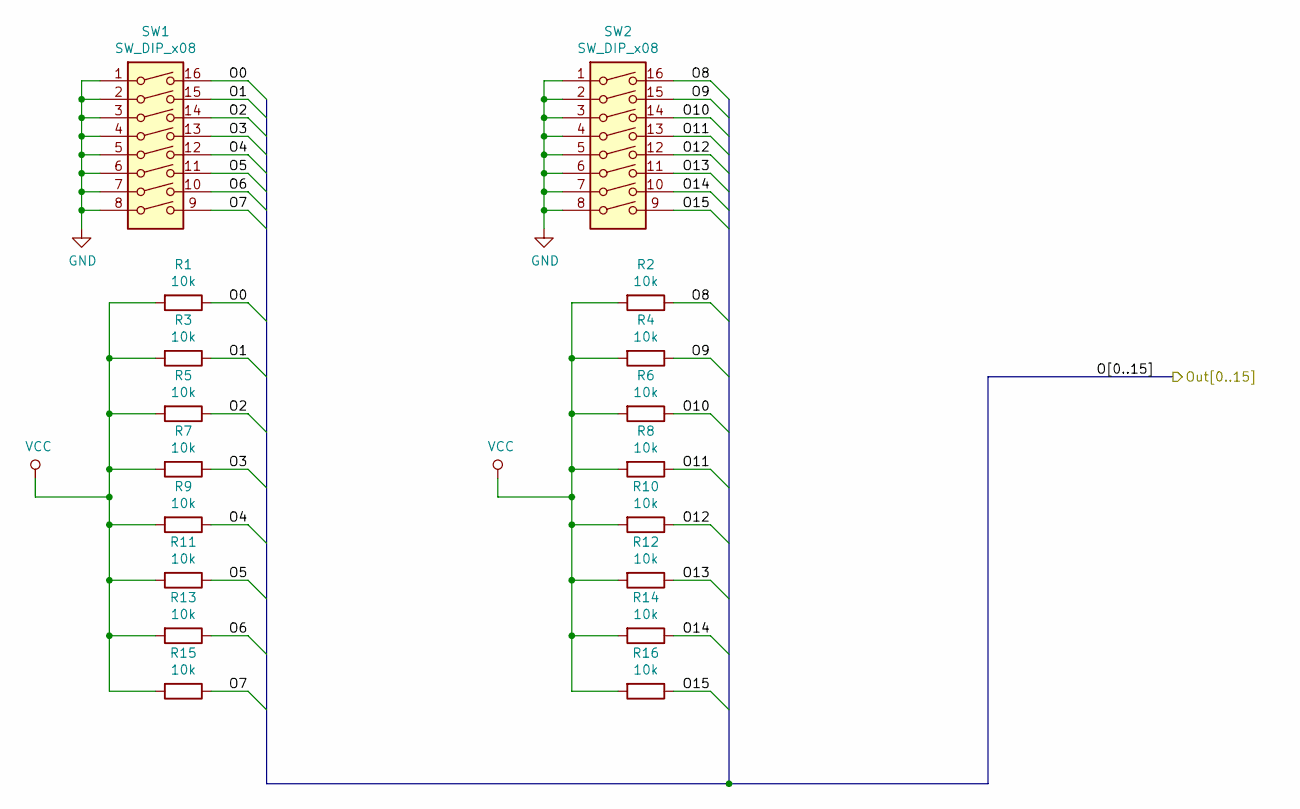
[picture p11: schematic Bank_switches.sch]

Parts:
R1, R2, R3, R4, R5, R6, R7, R8, R9, R10, R11, R12, R13, R14, R15, R16: 10k; C_0805_2012Metric
SW1, SW2: SW_DIP_x08; SW_DIP_SPSTx08_Slide_9.78x22.5mm_W7.62mm_P2.54mm

Connections:
/sheet5CBF05D3/A0: R1.1, SW1.16; also elsewhere on the board
/sheet5CBF05D3/A1: R3.1, SW1.15; also elsewhere on the board
/sheet5CBF05D3/A2: R5.1, SW1.14; also elsewhere on the board
/sheet5CBF05D3/A3: R7.1, SW1.13; also elsewhere on the board
/sheet5CBF05D3/A4: R9.1, SW1.12; also elsewhere on the board
/sheet5CBF05D3/A5: R11.1, SW1.11; also elsewhere on the board
/sheet5CBF05D3/A6: R13.1, SW1.10; also elsewhere on the board
/sheet5CBF05D3/A7: R15.1, SW1.9; also elsewhere on the board
/sheet5CBF05D3/A8: R2.1, SW2.16; also elsewhere on the board
/sheet5CBF05D3/A9: R4.1, SW2.15; also elsewhere on the board
/sheet5CBF05D3/A10: R6.1, SW2.14; also elsewhere on the board
/sheet5CBF05D3/A11: R8.1, SW2.13; also elsewhere on the board
/sheet5CBF05D3/A12: R10.1, SW2.12; also elsewhere on the board
/sheet5CBF05D3/A13: R12.1, SW2.11; also elsewhere on the board
/sheet5CBF05D3/A14: R14.1, SW2.10; also elsewhere on the board
/sheet5CBF05D3/A15: R16.1, SW2.9; also elsewhere on the board
VCC: R1.2, R2.2, R3.2, R4.2, R5.2, R6.2, R7.2, R8.2, R9.2, R10.2, R11.2, R12.2, R13.2, R14.2, R15.2, R16.2; also elsewhere on the board

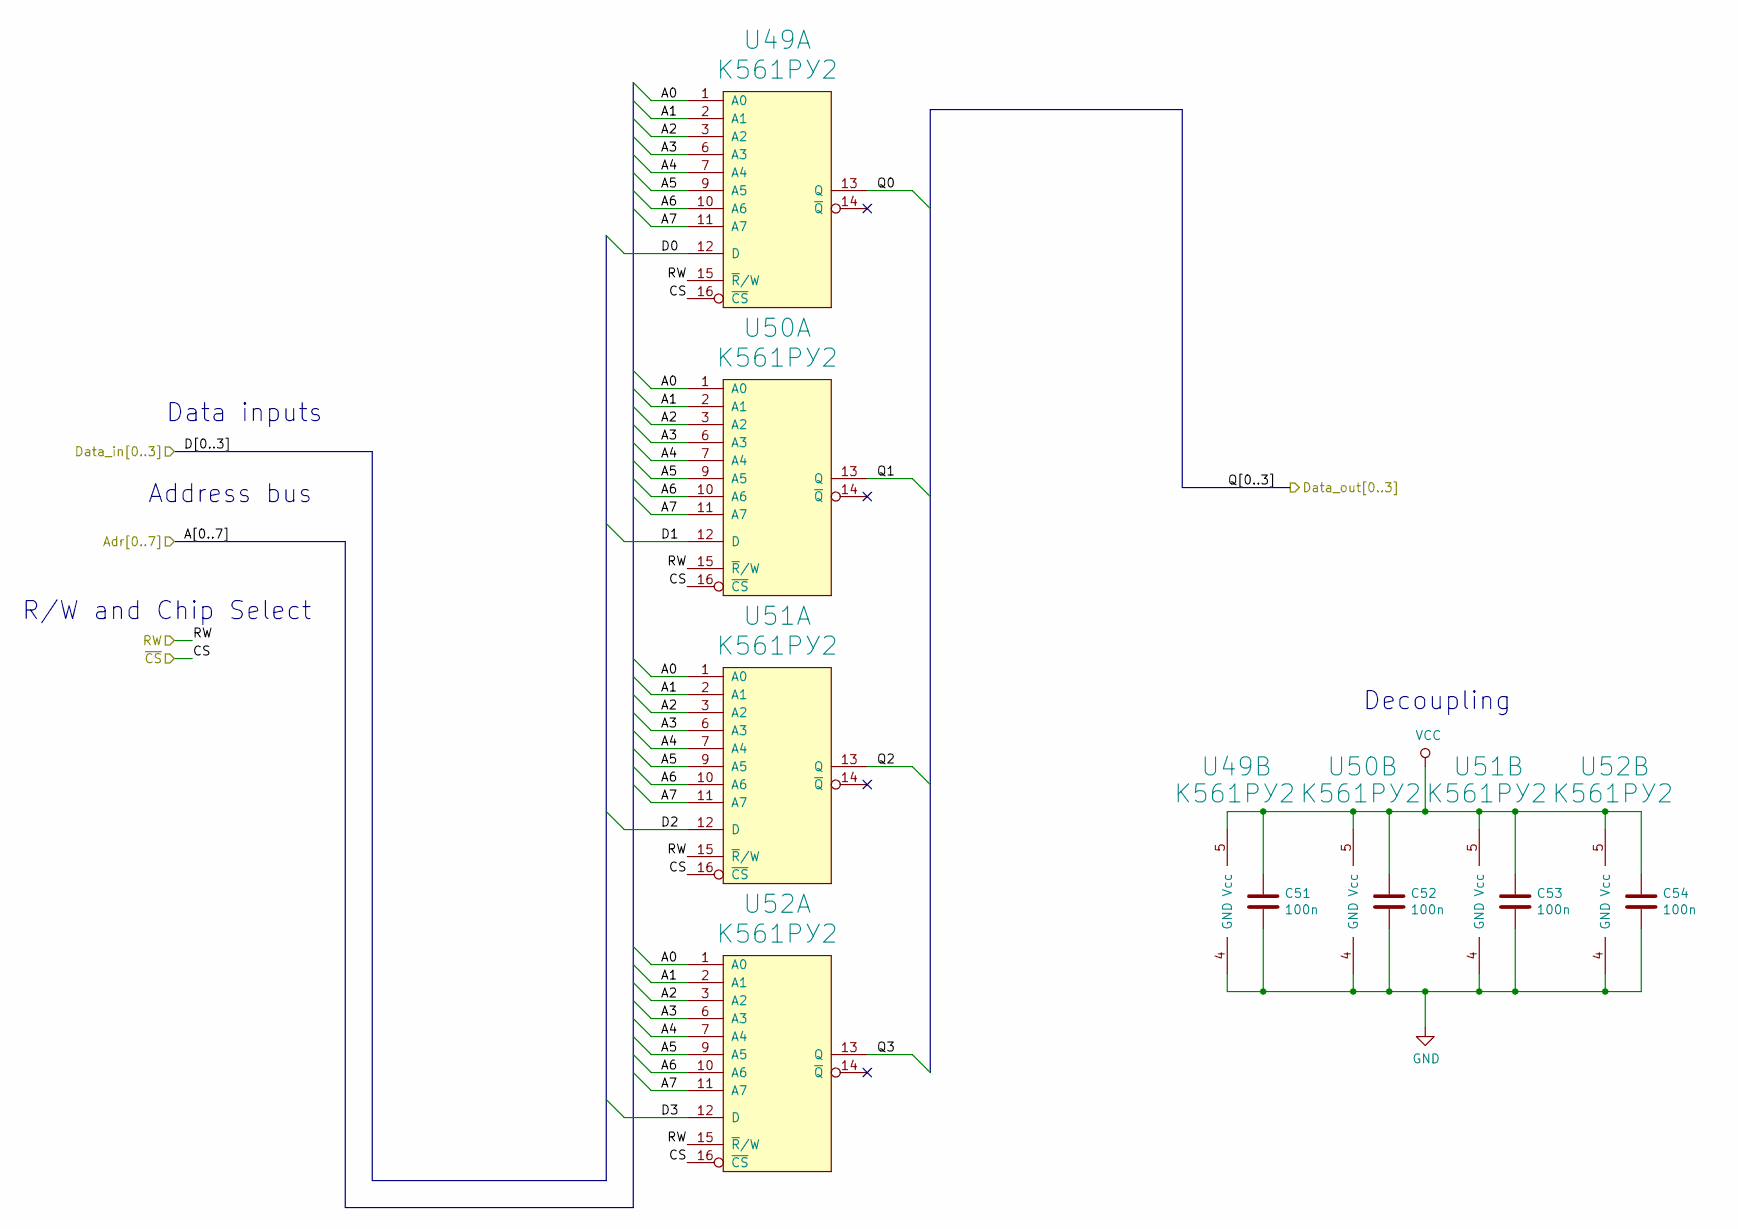
[picture p12: schematic Memory_block.sch, TD4 RAM module]

Parts:
C51, C52, C53, C54: 100n; C_0805_2012Metric
U49, U50, U51, U52: К561РУ2; DIP-16_W7.62mm_Socket_LongPads

Connections:
/Memory block/~CS: U49.16 (~CS), U50.16 (~CS), U51.16 (~CS), U52.16 (~CS); also elsewhere on the board
/RAM_A0: U49.1 (A0), U50.1 (A0), U51.1 (A0), U52.1 (A0); also elsewhere on the board
/RAM_A1: U49.2 (A1), U50.2 (A1), U51.2 (A1), U52.2 (A1); also elsewhere on the board
/RAM_A2: U49.3 (A2), U50.3 (A2), U51.3 (A2), U52.3 (A2); also elsewhere on the board
/RAM_A3: U49.6 (A3), U50.6 (A3), U51.6 (A3), U52.6 (A3); also elsewhere on the board
/RAM_A4: U49.7 (A4), U50.7 (A4), U51.7 (A4), U52.7 (A4); also elsewhere on the board
/RAM_A5: U49.9 (A5), U50.9 (A5), U51.9 (A5), U52.9 (A5); also elsewhere on the board
/RAM_A6: U49.10 (A6), U50.10 (A6), U51.10 (A6), U52.10 (A6); also elsewhere on the board
/RAM_A7: U49.11 (A7), U50.11 (A7), U51.11 (A7), U52.11 (A7); also elsewhere on the board
/RAM_RW: U49.15 (~R~/W), U50.15 (~R~/W), U51.15 (~R~/W), U52.15 (~R~/W); also elsewhere on the board
VCC: C51.1, C52.1, C53.1, C54.1, U49.5 (Vcc), U50.5 (Vcc), U51.5 (Vcc), U52.5 (Vcc); also elsewhere on the board

Notes on the sheet:
Address bus
Data inputs
R/W and Chip Select
Decoupling

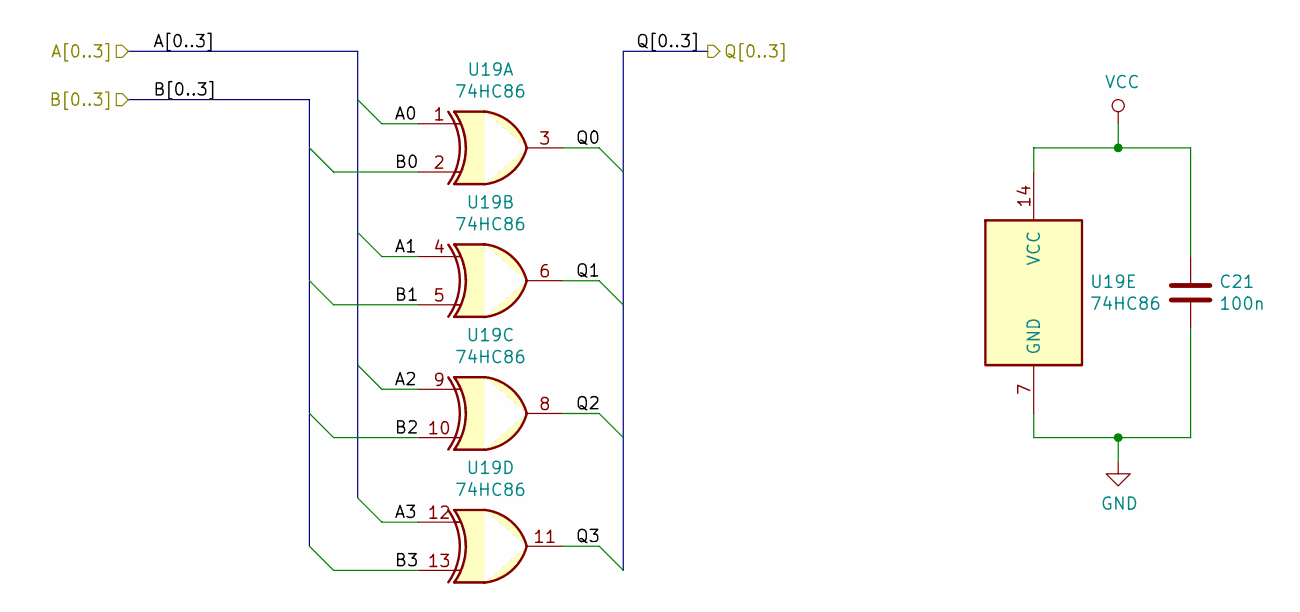
[picture p13: schematic Quad_XOR.sch, TD4 RAM module]

Parts:
C4: 100n; C_0805_2012Metric
U2: 74HC86; SOIC-14_3.9x8.7mm_P1.27mm

Connections:
/Address comparator/4-bitwise NOT/A0: U2.3; also elsewhere on the board
/Address comparator/4-bitwise NOT/A1: U2.6; also elsewhere on the board
/Address comparator/4-bitwise NOT/A2: U2.8; also elsewhere on the board
/Address comparator/4-bitwise NOT/A3: U2.11; also elsewhere on the board
/RAM_A4: U2.2; also elsewhere on the board
/RAM_A5: U2.5; also elsewhere on the board
/RAM_A6: U2.10; also elsewhere on the board
/RAM_A7: U2.13; also elsewhere on the board
VCC: C4.1, U2.14 (VCC); also elsewhere on the board

Parts of its further copies:
C7, C8, C9, C10, C11, C12, C13, C14, C15, C16, C17, C18, C19, C20, C21: 100n; C_0805_2012Metric
U5, U6, U7, U8, U9, U10, U11, U12, U13, U14, U15, U16, U17, U18, U19: 74HC86; SOIC-14_3.9x8.7mm_P1.27mm

Connections of its further copies:
/Address comparator/sheet5CCFCFC3/A0: U6.3; also elsewhere on the board
/Address comparator/sheet5CCFCFC3/A1: U6.6; also elsewhere on the board
/Address comparator/sheet5CCFCFC3/A2: U6.8; also elsewhere on the board
/Address comparator/sheet5CCFCFC3/A3: U6.11; also elsewhere on the board
/Address comparator/sheet5CD0A991/A0: U7.3; also elsewhere on the board
/Address comparator/sheet5CD0A991/A1: U7.6; also elsewhere on the board
/Address comparator/sheet5CD0A991/A2: U7.8; also elsewhere on the board
/Address comparator/sheet5CD0A991/A3: U7.11; also elsewhere on the board
/Address comparator/sheet5CD1F070/A0: U16.3; also elsewhere on the board
/Address comparator/sheet5CD1F070/A1: U16.6; also elsewhere on the board
/Address comparator/sheet5CD1F070/A2: U16.8; also elsewhere on the board
/Address comparator/sheet5CD1F070/A3: U16.11; also elsewhere on the board
/Address comparator/sheet5CD1F071/A0: U17.3; also elsewhere on the board
/Address comparator/sheet5CD1F071/A1: U17.6; also elsewhere on the board
/Address comparator/sheet5CD1F071/A2: U17.8; also elsewhere on the board
/Address comparator/sheet5CD1F071/A3: U17.11; also elsewhere on the board
/Address comparator/sheet5CD1F072/A0: U19.3; also elsewhere on the board
/Address comparator/sheet5CD1F072/A1: U19.6; also elsewhere on the board
/Address comparator/sheet5CD1F072/A2: U19.8; also elsewhere on the board
/Address comparator/sheet5CD1F072/A3: U19.11; also elsewhere on the board
/Address comparator/sheet5CD1F073/A0: U18.3; also elsewhere on the board
/Address comparator/sheet5CD1F073/A1: U18.6; also elsewhere on the board
/Address comparator/sheet5CD1F073/A2: U18.8; also elsewhere on the board
/Address comparator/sheet5CD1F073/A3: U18.11; also elsewhere on the board
/Address comparator/sheet5CD03CAA/A0: U5.3; also elsewhere on the board
/Address comparator/sheet5CD03CAA/A1: U5.6; also elsewhere on the board
/Address comparator/sheet5CD03CAA/A2: U5.8; also elsewhere on the board
/Address comparator/sheet5CD03CAA/A3: U5.11; also elsewhere on the board
/Address comparator/sheet5CD1837A/A0: U11.3; also elsewhere on the board
/Address comparator/sheet5CD1837A/A1: U11.6; also elsewhere on the board
/Address comparator/sheet5CD1837A/A2: U11.8; also elsewhere on the board
/Address comparator/sheet5CD1837A/A3: U11.11; also elsewhere on the board
/Address comparator/sheet5CD1837B/A0: U13.3; also elsewhere on the board
/Address comparator/sheet5CD1837B/A1: U13.6; also elsewhere on the board
/Address comparator/sheet5CD1837B/A2: U13.8; also elsewhere on the board
/Address comparator/sheet5CD1837B/A3: U13.11; also elsewhere on the board
/Address comparator/sheet5CD1837C/A0: U15.3; also elsewhere on the board
/Address comparator/sheet5CD1837C/A1: U15.6; also elsewhere on the board
/Address comparator/sheet5CD1837C/A2: U15.8; also elsewhere on the board
/Address comparator/sheet5CD1837C/A3: U15.11; also elsewhere on the board
/Address comparator/sheet5CD1837D/A0: U14.3; also elsewhere on the board
/Address comparator/sheet5CD1837D/A1: U14.6; also elsewhere on the board
/Address comparator/sheet5CD1837D/A2: U14.8; also elsewhere on the board
/Address comparator/sheet5CD1837D/A3: U14.11; also elsewhere on the board
/Address comparator/sheet5CD11684/A0: U9.3; also elsewhere on the board
/Address comparator/sheet5CD11684/A1: U9.6; also elsewhere on the board
/Address comparator/sheet5CD11684/A2: U9.8; also elsewhere on the board
/Address comparator/sheet5CD11684/A3: U9.11; also elsewhere on the board
/Address comparator/sheet5CD11685/A0: U8.3; also elsewhere on the board
/Address comparator/sheet5CD11685/A1: U8.6; also elsewhere on the board
/Address comparator/sheet5CD11685/A2: U8.8; also elsewhere on the board
/Address comparator/sheet5CD11685/A3: U8.11; also elsewhere on the board
/Address comparator/sheet5CD11686/A0: U10.3; also elsewhere on the board
/Address comparator/sheet5CD11686/A1: U10.6; also elsewhere on the board
/Address comparator/sheet5CD11686/A2: U10.8; also elsewhere on the board
/Address comparator/sheet5CD11686/A3: U10.11; also elsewhere on the board
/Address comparator/sheet5CD11687/A0: U12.3; also elsewhere on the board
/Address comparator/sheet5CD11687/A1: U12.6; also elsewhere on the board
/Address comparator/sheet5CD11687/A2: U12.8; also elsewhere on the board
/Address comparator/sheet5CD11687/A3: U12.11; also elsewhere on the board
/RAM_A4: U5.2, U6.2, U7.2, U8.2, U9.2, U10.2, U11.2, U12.2, U13.2, U14.2, U15.2, U16.2, U17.2, U18.2, U19.2; also elsewhere on the board
/RAM_A5: U5.5, U6.5, U7.5, U8.5, U9.5, U10.5, U11.5, U12.5, U13.5, U14.5, U15.5, U16.5, U17.5, U18.5, U19.5; also elsewhere on the board
/RAM_A6: U5.10, U6.10, U7.10, U8.10, U9.10, U10.10, U11.10, U12.10, U13.10, U14.10, U15.10, U16.10, U17.10, U18.10, U19.10; also elsewhere on the board
/RAM_A7: U5.13, U6.13, U7.13, U8.13, U9.13, U10.13, U11.13, U12.13, U13.13, U14.13, U15.13, U16.13, U17.13, U18.13, U19.13; also elsewhere on the board
VCC: C7.1, C8.1, C9.1, C10.1, C11.1, C12.1, C13.1, C14.1, C15.1, C16.1, C17.1, C18.1, C19.1, C20.1, C21.1, U5.4, U5.14 (VCC), U6.1, U6.14 (VCC), U7.1, U7.4, U7.14 (VCC), U8.1, U8.9, U8.14 (VCC), U9.9, U9.14 (VCC), U10.4, U10.9, U10.14 (VCC), U11.12, U11.14 (VCC), U12.1, U12.4, U12.9, U12.14 (VCC), U13.1, U13.12, U13.14 (VCC), U14.1, U14.4, U14.12, U14.14 (VCC), U15.4, U15.12, U15.14 (VCC), U16.9, U16.12, U16.14 (VCC), U17.1, U17.9, U17.12, U17.14 (VCC), U18.1, U18.4, U18.9, U18.12, U18.14 (VCC), U19.4, U19.9, U19.12, U19.14 (VCC); also elsewhere on the board
