fedosgad/TD4/RAM/TD4_RAM/TD4_RAM.kicad_pcb

## KiCad design RAM/TD4_RAM/TD4_RAM.kicad_pcb (continued)

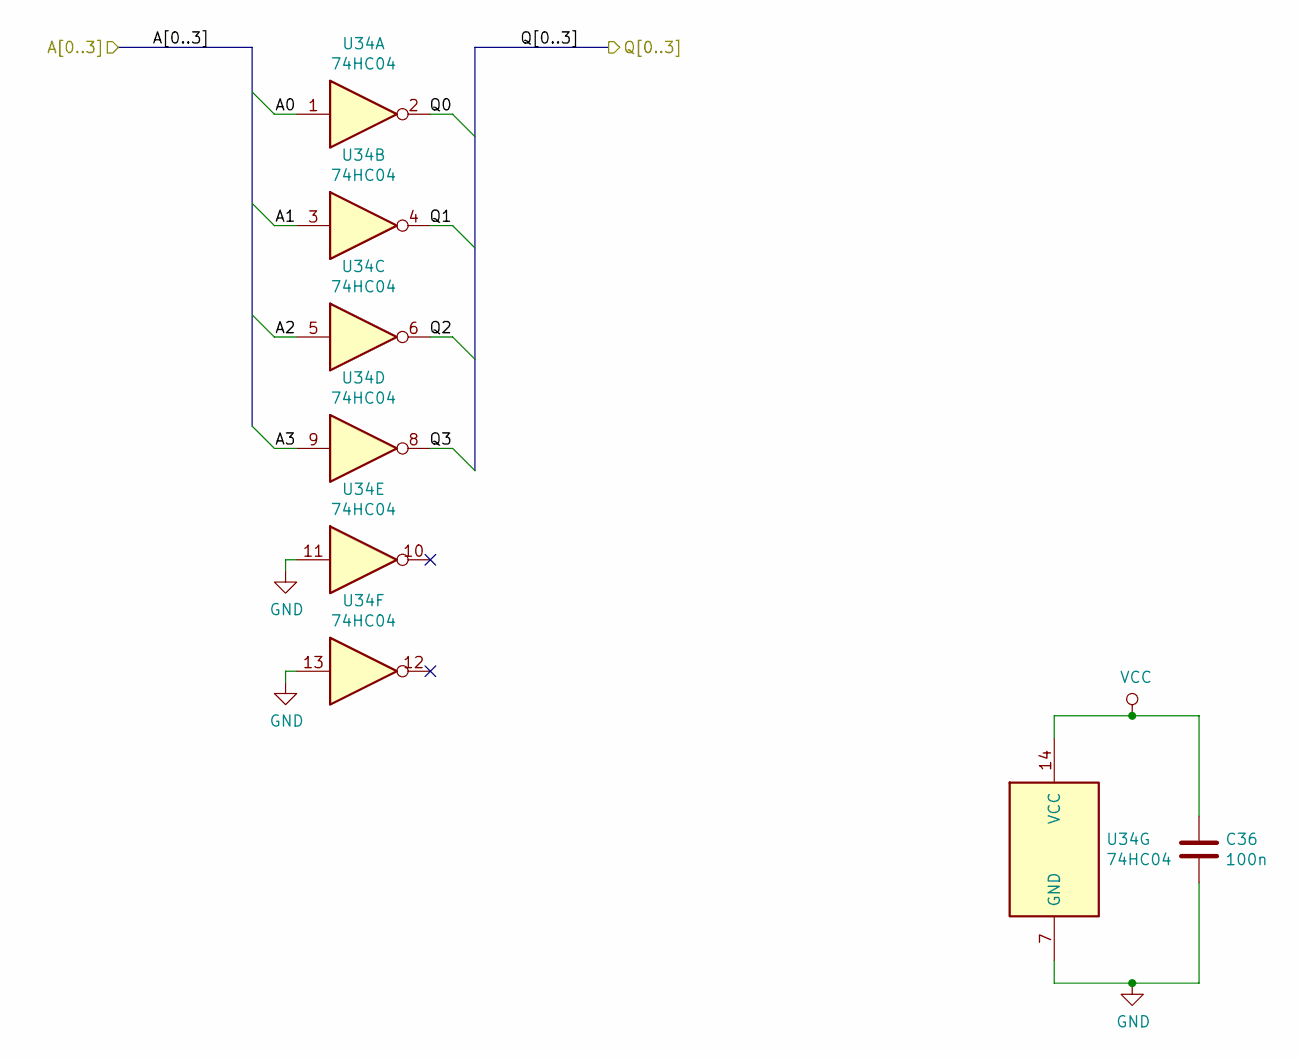
[picture p14: schematic 4-bitwise_NOT.sch]

Parts:
C5: 100n; C_0805_2012Metric
U3: 74HC04; SOIC-14_3.9x8.7mm_P1.27mm

Connections:
/Address comparator/2x Quad AND/A0: U3.2; also elsewhere on the board
/Address comparator/2x Quad AND/A1: U3.4; also elsewhere on the board
/Address comparator/2x Quad AND/A2: U3.6; also elsewhere on the board
/Address comparator/2x Quad AND/A3: U3.8; also elsewhere on the board
/Address comparator/4-bitwise NOT/A0: U3.1; also elsewhere on the board
/Address comparator/4-bitwise NOT/A1: U3.3; also elsewhere on the board
/Address comparator/4-bitwise NOT/A2: U3.5; also elsewhere on the board
/Address comparator/4-bitwise NOT/A3: U3.9; also elsewhere on the board
VCC: C5.1, U3.14 (VCC); also elsewhere on the board

Parts of its further copies:
C22, C23, C24, C25, C26, C27, C28, C29, C30, C31, C32, C33, C34, C35, C36: 100n; C_0805_2012Metric
U20, U21, U22, U23, U24, U25, U26, U27, U28, U29, U30, U31, U32, U33, U34: 74HC04; SOIC-14_3.9x8.7mm_P1.27mm

Connections of its further copies:
/Address comparator/2x Quad AND/B0: U20.2; also elsewhere on the board
/Address comparator/2x Quad AND/B1: U20.4; also elsewhere on the board
/Address comparator/2x Quad AND/B2: U20.6; also elsewhere on the board
/Address comparator/2x Quad AND/B3: U20.8; also elsewhere on the board
/Address comparator/sheet5CCFCFC3/A0: U20.1; also elsewhere on the board
/Address comparator/sheet5CCFCFC3/A1: U20.3; also elsewhere on the board
/Address comparator/sheet5CCFCFC3/A2: U20.5; also elsewhere on the board
/Address comparator/sheet5CCFCFC3/A3: U20.9; also elsewhere on the board
/Address comparator/sheet5CD0A991/A0: U22.1; also elsewhere on the board
/Address comparator/sheet5CD0A991/A1: U22.3; also elsewhere on the board
/Address comparator/sheet5CD0A991/A2: U22.5; also elsewhere on the board
/Address comparator/sheet5CD0A991/A3: U22.9; also elsewhere on the board
/Address comparator/sheet5CD1F070/A0: U31.1; also elsewhere on the board
/Address comparator/sheet5CD1F070/A1: U31.3; also elsewhere on the board
/Address comparator/sheet5CD1F070/A2: U31.5; also elsewhere on the board
/Address comparator/sheet5CD1F070/A3: U31.9; also elsewhere on the board
/Address comparator/sheet5CD1F071/A0: U32.1; also elsewhere on the board
/Address comparator/sheet5CD1F071/A1: U32.3; also elsewhere on the board
/Address comparator/sheet5CD1F071/A2: U32.5; also elsewhere on the board
/Address comparator/sheet5CD1F071/A3: U32.9; also elsewhere on the board
/Address comparator/sheet5CD1F072/A0: U33.1; also elsewhere on the board
/Address comparator/sheet5CD1F072/A1: U33.3; also elsewhere on the board
/Address comparator/sheet5CD1F072/A2: U33.5; also elsewhere on the board
/Address comparator/sheet5CD1F072/A3: U33.9; also elsewhere on the board
/Address comparator/sheet5CD1F073/A0: U34.1; also elsewhere on the board
/Address comparator/sheet5CD1F073/A1: U34.3; also elsewhere on the board
/Address comparator/sheet5CD1F073/A2: U34.5; also elsewhere on the board
/Address comparator/sheet5CD1F073/A3: U34.9; also elsewhere on the board
/Address comparator/sheet5CD2F160/A0: U23.2; also elsewhere on the board
/Address comparator/sheet5CD2F160/A1: U23.4; also elsewhere on the board
/Address comparator/sheet5CD2F160/A2: U23.6; also elsewhere on the board
/Address comparator/sheet5CD2F160/A3: U23.8; also elsewhere on the board
/Address comparator/sheet5CD2F160/B0: U24.2; also elsewhere on the board
/Address comparator/sheet5CD2F160/B1: U24.4; also elsewhere on the board
/Address comparator/sheet5CD2F160/B2: U24.6; also elsewhere on the board
/Address comparator/sheet5CD2F160/B3: U24.8; also elsewhere on the board
/Address comparator/sheet5CD03CAA/A0: U21.1; also elsewhere on the board
/Address comparator/sheet5CD03CAA/A1: U21.3; also elsewhere on the board
/Address comparator/sheet5CD03CAA/A2: U21.5; also elsewhere on the board
/Address comparator/sheet5CD03CAA/A3: U21.9; also elsewhere on the board
/Address comparator/sheet5CD3CB46/A0: U27.2; also elsewhere on the board
/Address comparator/sheet5CD3CB46/A1: U27.4; also elsewhere on the board
/Address comparator/sheet5CD3CB46/A2: U27.6; also elsewhere on the board
/Address comparator/sheet5CD3CB46/A3: U27.8; also elsewhere on the board
/Address comparator/sheet5CD3CB46/B0: U28.2; also elsewhere on the board
/Address comparator/sheet5CD3CB46/B1: U28.4; also elsewhere on the board
/Address comparator/sheet5CD3CB46/B2: U28.6; also elsewhere on the board
/Address comparator/sheet5CD3CB46/B3: U28.8; also elsewhere on the board
/Address comparator/sheet5CD3CB47/A0: U29.2; also elsewhere on the board
/Address comparator/sheet5CD3CB47/A1: U29.4; also elsewhere on the board
/Address comparator/sheet5CD3CB47/A2: U29.6; also elsewhere on the board
/Address comparator/sheet5CD3CB47/A3: U29.8; also elsewhere on the board
/Address comparator/sheet5CD3CB47/B0: U30.2; also elsewhere on the board
/Address comparator/sheet5CD3CB47/B1: U30.4; also elsewhere on the board
/Address comparator/sheet5CD3CB47/B2: U30.6; also elsewhere on the board
/Address comparator/sheet5CD3CB47/B3: U30.8; also elsewhere on the board
/Address comparator/sheet5CD3CB48/A0: U31.2; also elsewhere on the board
/Address comparator/sheet5CD3CB48/A1: U31.4; also elsewhere on the board
/Address comparator/sheet5CD3CB48/A2: U31.6; also elsewhere on the board
/Address comparator/sheet5CD3CB48/A3: U31.8; also elsewhere on the board
/Address comparator/sheet5CD3CB48/B0: U32.2; also elsewhere on the board
/Address comparator/sheet5CD3CB48/B1: U32.4; also elsewhere on the board
/Address comparator/sheet5CD3CB48/B2: U32.6; also elsewhere on the board
/Address comparator/sheet5CD3CB48/B3: U32.8; also elsewhere on the board
/Address comparator/sheet5CD3CB49/A0: U33.2; also elsewhere on the board
/Address comparator/sheet5CD3CB49/A1: U33.4; also elsewhere on the board
/Address comparator/sheet5CD3CB49/A2: U33.6; also elsewhere on the board
/Address comparator/sheet5CD3CB49/A3: U33.8; also elsewhere on the board
/Address comparator/sheet5CD3CB49/B0: U34.2; also elsewhere on the board
/Address comparator/sheet5CD3CB49/B1: U34.4; also elsewhere on the board
/Address comparator/sheet5CD3CB49/B2: U34.6; also elsewhere on the board
/Address comparator/sheet5CD3CB49/B3: U34.8; also elsewhere on the board
/Address comparator/sheet5CD35E49/A0: U25.2; also elsewhere on the board
/Address comparator/sheet5CD35E49/A1: U25.4; also elsewhere on the board
/Address comparator/sheet5CD35E49/A2: U25.6; also elsewhere on the board
/Address comparator/sheet5CD35E49/A3: U25.8; also elsewhere on the board
/Address comparator/sheet5CD35E49/B0: U26.2; also elsewhere on the board
/Address comparator/sheet5CD35E49/B1: U26.4; also elsewhere on the board
/Address comparator/sheet5CD35E49/B2: U26.6; also elsewhere on the board
/Address comparator/sheet5CD35E49/B3: U26.8; also elsewhere on the board
/Address comparator/sheet5CD1837A/A0: U27.1; also elsewhere on the board
/Address comparator/sheet5CD1837A/A1: U27.3; also elsewhere on the board
/Address comparator/sheet5CD1837A/A2: U27.5; also elsewhere on the board
/Address comparator/sheet5CD1837A/A3: U27.9; also elsewhere on the board
/Address comparator/sheet5CD1837B/A0: U28.1; also elsewhere on the board
/Address comparator/sheet5CD1837B/A1: U28.3; also elsewhere on the board
/Address comparator/sheet5CD1837B/A2: U28.5; also elsewhere on the board
/Address comparator/sheet5CD1837B/A3: U28.9; also elsewhere on the board
/Address comparator/sheet5CD1837C/A0: U29.1; also elsewhere on the board
/Address comparator/sheet5CD1837C/A1: U29.3; also elsewhere on the board
/Address comparator/sheet5CD1837C/A2: U29.5; also elsewhere on the board
/Address comparator/sheet5CD1837C/A3: U29.9; also elsewhere on the board
/Address comparator/sheet5CD1837D/A0: U30.1; also elsewhere on the board
/Address comparator/sheet5CD1837D/A1: U30.3; also elsewhere on the board
/Address comparator/sheet5CD1837D/A2: U30.5; also elsewhere on the board
/Address comparator/sheet5CD1837D/A3: U30.9; also elsewhere on the board
/Address comparator/sheet5CD11684/A0: U23.1; also elsewhere on the board
/Address comparator/sheet5CD11684/A1: U23.3; also elsewhere on the board
/Address comparator/sheet5CD11684/A2: U23.5; also elsewhere on the board
/Address comparator/sheet5CD11684/A3: U23.9; also elsewhere on the board
/Address comparator/sheet5CD11685/A0: U24.1; also elsewhere on the board
/Address comparator/sheet5CD11685/A1: U24.3; also elsewhere on the board
/Address comparator/sheet5CD11685/A2: U24.5; also elsewhere on the board
/Address comparator/sheet5CD11685/A3: U24.9; also elsewhere on the board
/Address comparator/sheet5CD11686/A0: U25.1; also elsewhere on the board
/Address comparator/sheet5CD11686/A1: U25.3; also elsewhere on the board
/Address comparator/sheet5CD11686/A2: U25.5; also elsewhere on the board
/Address comparator/sheet5CD11686/A3: U25.9; also elsewhere on the board
/Address comparator/sheet5CD11687/A0: U26.1; also elsewhere on the board
/Address comparator/sheet5CD11687/A1: U26.3; also elsewhere on the board
/Address comparator/sheet5CD11687/A2: U26.5; also elsewhere on the board
/Address comparator/sheet5CD11687/A3: U26.9; also elsewhere on the board
/Address comparator/sheet5CD28477/A0: U21.2; also elsewhere on the board
/Address comparator/sheet5CD28477/A1: U21.4; also elsewhere on the board
/Address comparator/sheet5CD28477/A2: U21.6; also elsewhere on the board
/Address comparator/sheet5CD28477/A3: U21.8; also elsewhere on the board
/Address comparator/sheet5CD28477/B0: U22.2; also elsewhere on the board
/Address comparator/sheet5CD28477/B1: U22.4; also elsewhere on the board
/Address comparator/sheet5CD28477/B2: U22.6; also elsewhere on the board
/Address comparator/sheet5CD28477/B3: U22.8; also elsewhere on the board
VCC: C22.1, C23.1, C24.1, C25.1, C26.1, C27.1, C28.1, C29.1, C30.1, C31.1, C32.1, C33.1, C34.1, C35.1, C36.1, U20.14 (VCC), U21.14 (VCC), U22.14 (VCC), U23.14 (VCC), U24.14 (VCC), U25.14 (VCC), U26.14 (VCC), U27.14 (VCC), U28.14 (VCC), U29.14 (VCC), U30.14 (VCC), U31.14 (VCC), U32.14 (VCC), U33.14 (VCC), U34.14 (VCC); also elsewhere on the board

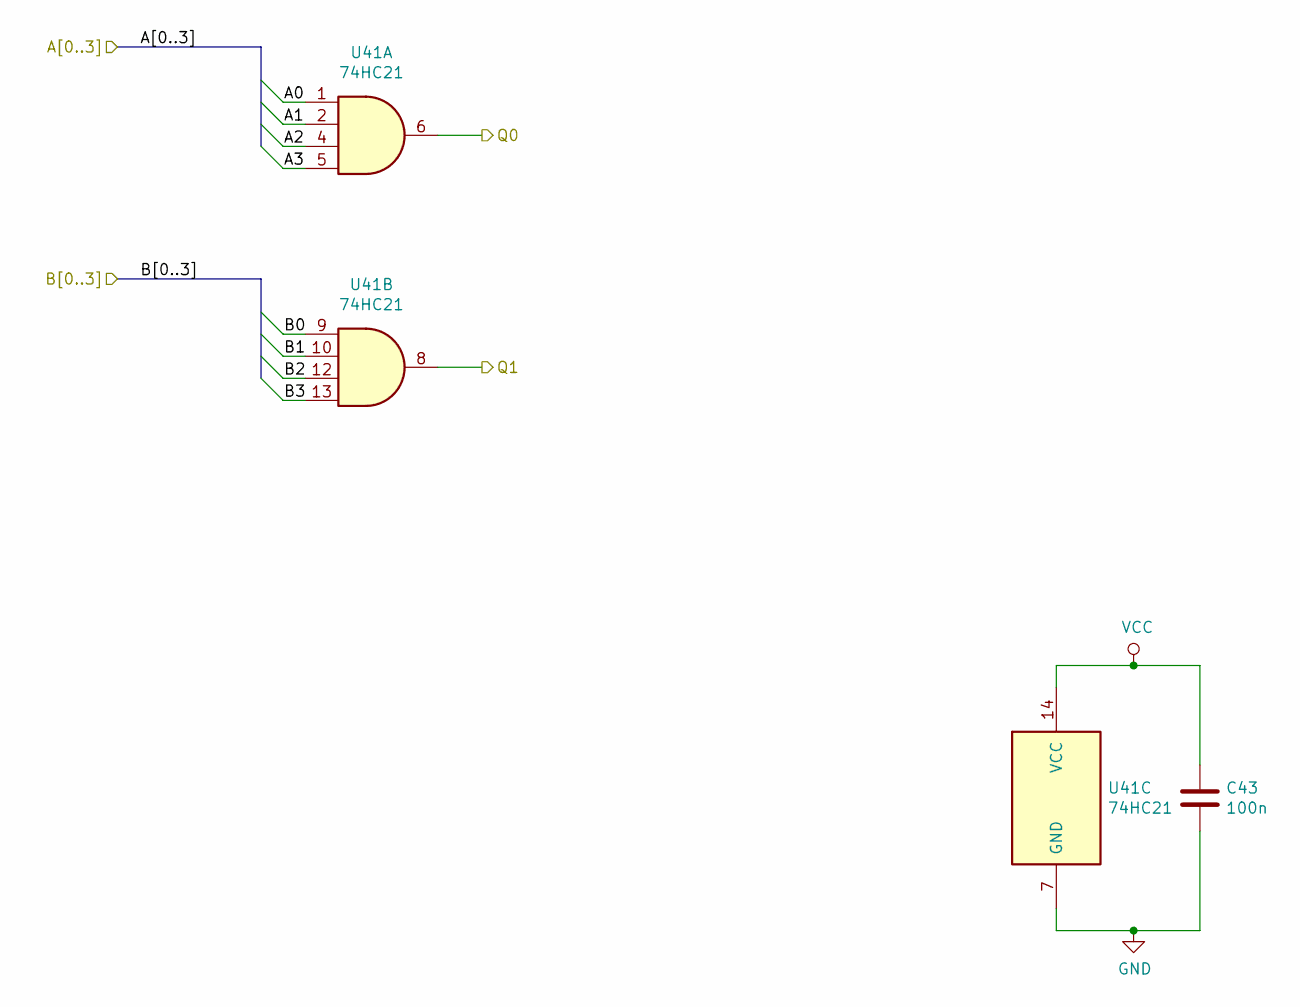
[picture p15: schematic 2xQuad_AND.sch]

Parts:
C6: 100n; C_0805_2012Metric
U4: 74HC21; SOIC-14_3.9x8.7mm_P1.27mm

Connections:
/Address comparator/2x Quad AND/A0: U4.1; also elsewhere on the board
/Address comparator/2x Quad AND/A1: U4.2; also elsewhere on the board
/Address comparator/2x Quad AND/A2: U4.4; also elsewhere on the board
/Address comparator/2x Quad AND/A3: U4.5; also elsewhere on the board
/Address comparator/2x Quad AND/B0: U4.9; also elsewhere on the board
/Address comparator/2x Quad AND/B1: U4.10; also elsewhere on the board
/Address comparator/2x Quad AND/B2: U4.12; also elsewhere on the board
/Address comparator/2x Quad AND/B3: U4.13; also elsewhere on the board
/sheet5CBF05D3/B0: U4.6; also elsewhere on the board
/sheet5CBF05D3/B1: U4.8; also elsewhere on the board
VCC: C6.1, U4.14 (VCC); also elsewhere on the board

Parts of its further copies:
C37, C38, C39, C40, C41, C42, C43: 100n; C_0805_2012Metric
U35, U36, U37, U38, U39, U40, U41: 74HC21; SOIC-14_3.9x8.7mm_P1.27mm

Connections of its further copies:
/Address comparator/sheet5CD2F160/A0: U36.1; also elsewhere on the board
/Address comparator/sheet5CD2F160/A1: U36.2; also elsewhere on the board
/Address comparator/sheet5CD2F160/A2: U36.4; also elsewhere on the board
/Address comparator/sheet5CD2F160/A3: U36.5; also elsewhere on the board
/Address comparator/sheet5CD2F160/B0: U36.9; also elsewhere on the board
/Address comparator/sheet5CD2F160/B1: U36.10; also elsewhere on the board
/Address comparator/sheet5CD2F160/B2: U36.12; also elsewhere on the board
/Address comparator/sheet5CD2F160/B3: U36.13; also elsewhere on the board
/Address comparator/sheet5CD3CB46/A0: U38.1; also elsewhere on the board
/Address comparator/sheet5CD3CB46/A1: U38.2; also elsewhere on the board
/Address comparator/sheet5CD3CB46/A2: U38.4; also elsewhere on the board
/Address comparator/sheet5CD3CB46/A3: U38.5; also elsewhere on the board
/Address comparator/sheet5CD3CB46/B0: U38.9; also elsewhere on the board
/Address comparator/sheet5CD3CB46/B1: U38.10; also elsewhere on the board
/Address comparator/sheet5CD3CB46/B2: U38.12; also elsewhere on the board
/Address comparator/sheet5CD3CB46/B3: U38.13; also elsewhere on the board
/Address comparator/sheet5CD3CB47/A0: U39.1; also elsewhere on the board
/Address comparator/sheet5CD3CB47/A1: U39.2; also elsewhere on the board
/Address comparator/sheet5CD3CB47/A2: U39.4; also elsewhere on the board
/Address comparator/sheet5CD3CB47/A3: U39.5; also elsewhere on the board
/Address comparator/sheet5CD3CB47/B0: U39.9; also elsewhere on the board
/Address comparator/sheet5CD3CB47/B1: U39.10; also elsewhere on the board
/Address comparator/sheet5CD3CB47/B2: U39.12; also elsewhere on the board
/Address comparator/sheet5CD3CB47/B3: U39.13; also elsewhere on the board
/Address comparator/sheet5CD3CB48/A0: U40.1; also elsewhere on the board
/Address comparator/sheet5CD3CB48/A1: U40.2; also elsewhere on the board
/Address comparator/sheet5CD3CB48/A2: U40.4; also elsewhere on the board
/Address comparator/sheet5CD3CB48/A3: U40.5; also elsewhere on the board
/Address comparator/sheet5CD3CB48/B0: U40.9; also elsewhere on the board
/Address comparator/sheet5CD3CB48/B1: U40.10; also elsewhere on the board
/Address comparator/sheet5CD3CB48/B2: U40.12; also elsewhere on the board
/Address comparator/sheet5CD3CB48/B3: U40.13; also elsewhere on the board
/Address comparator/sheet5CD3CB49/A0: U41.1; also elsewhere on the board
/Address comparator/sheet5CD3CB49/A1: U41.2; also elsewhere on the board
/Address comparator/sheet5CD3CB49/A2: U41.4; also elsewhere on the board
/Address comparator/sheet5CD3CB49/A3: U41.5; also elsewhere on the board
/Address comparator/sheet5CD3CB49/B0: U41.9; also elsewhere on the board
/Address comparator/sheet5CD3CB49/B1: U41.10; also elsewhere on the board
/Address comparator/sheet5CD3CB49/B2: U41.12; also elsewhere on the board
/Address comparator/sheet5CD3CB49/B3: U41.13; also elsewhere on the board
/Address comparator/sheet5CD35E49/A0: U37.1; also elsewhere on the board
/Address comparator/sheet5CD35E49/A1: U37.2; also elsewhere on the board
/Address comparator/sheet5CD35E49/A2: U37.4; also elsewhere on the board
/Address comparator/sheet5CD35E49/A3: U37.5; also elsewhere on the board
/Address comparator/sheet5CD35E49/B0: U37.9; also elsewhere on the board
/Address comparator/sheet5CD35E49/B1: U37.10; also elsewhere on the board
/Address comparator/sheet5CD35E49/B2: U37.12; also elsewhere on the board
/Address comparator/sheet5CD35E49/B3: U37.13; also elsewhere on the board
/Address comparator/sheet5CD28477/A0: U35.1; also elsewhere on the board
/Address comparator/sheet5CD28477/A1: U35.2; also elsewhere on the board
/Address comparator/sheet5CD28477/A2: U35.4; also elsewhere on the board
/Address comparator/sheet5CD28477/A3: U35.5; also elsewhere on the board
/Address comparator/sheet5CD28477/B0: U35.9; also elsewhere on the board
/Address comparator/sheet5CD28477/B1: U35.10; also elsewhere on the board
/Address comparator/sheet5CD28477/B2: U35.12; also elsewhere on the board
/Address comparator/sheet5CD28477/B3: U35.13; also elsewhere on the board
/sheet5CBF05D3/B2: U35.6; also elsewhere on the board
/sheet5CBF05D3/B3: U35.8; also elsewhere on the board
/sheet5CBF05D3/B4: U36.6; also elsewhere on the board
/sheet5CBF05D3/B5: U36.8; also elsewhere on the board
/sheet5CBF05D3/B6: U37.6; also elsewhere on the board
/sheet5CBF05D3/B7: U37.8; also elsewhere on the board
/sheet5CBF05D3/B8: U38.6; also elsewhere on the board
/sheet5CBF05D3/B9: U38.8; also elsewhere on the board
/sheet5CBF05D3/B10: U39.6; also elsewhere on the board
/sheet5CBF05D3/B11: U39.8; also elsewhere on the board
/sheet5CBF05D3/B12: U40.6; also elsewhere on the board
/sheet5CBF05D3/B13: U40.8; also elsewhere on the board
/sheet5CBF05D3/B14: U41.6; also elsewhere on the board
/sheet5CBF05D3/B15: U41.8; also elsewhere on the board
VCC: C37.1, C38.1, C39.1, C40.1, C41.1, C42.1, C43.1, U35.14 (VCC), U36.14 (VCC), U37.14 (VCC), U38.14 (VCC), U39.14 (VCC), U40.14 (VCC), U41.14 (VCC); also elsewhere on the board

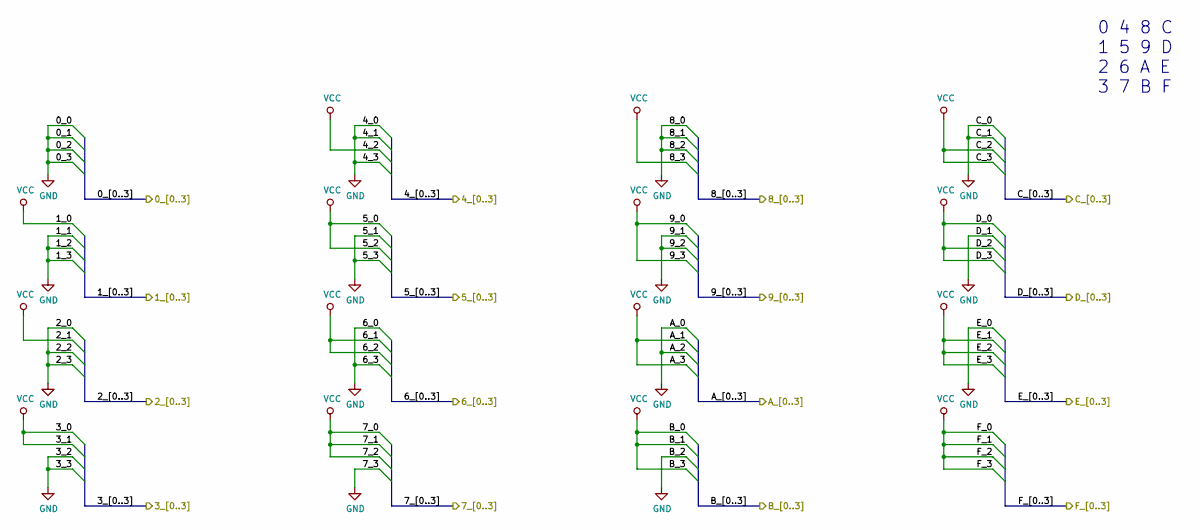
[picture p16: schematic Numbers.sch]

Notes on the sheet:
0 4 8 C 1 5 9 D 2 6 A E 3 7 B F

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
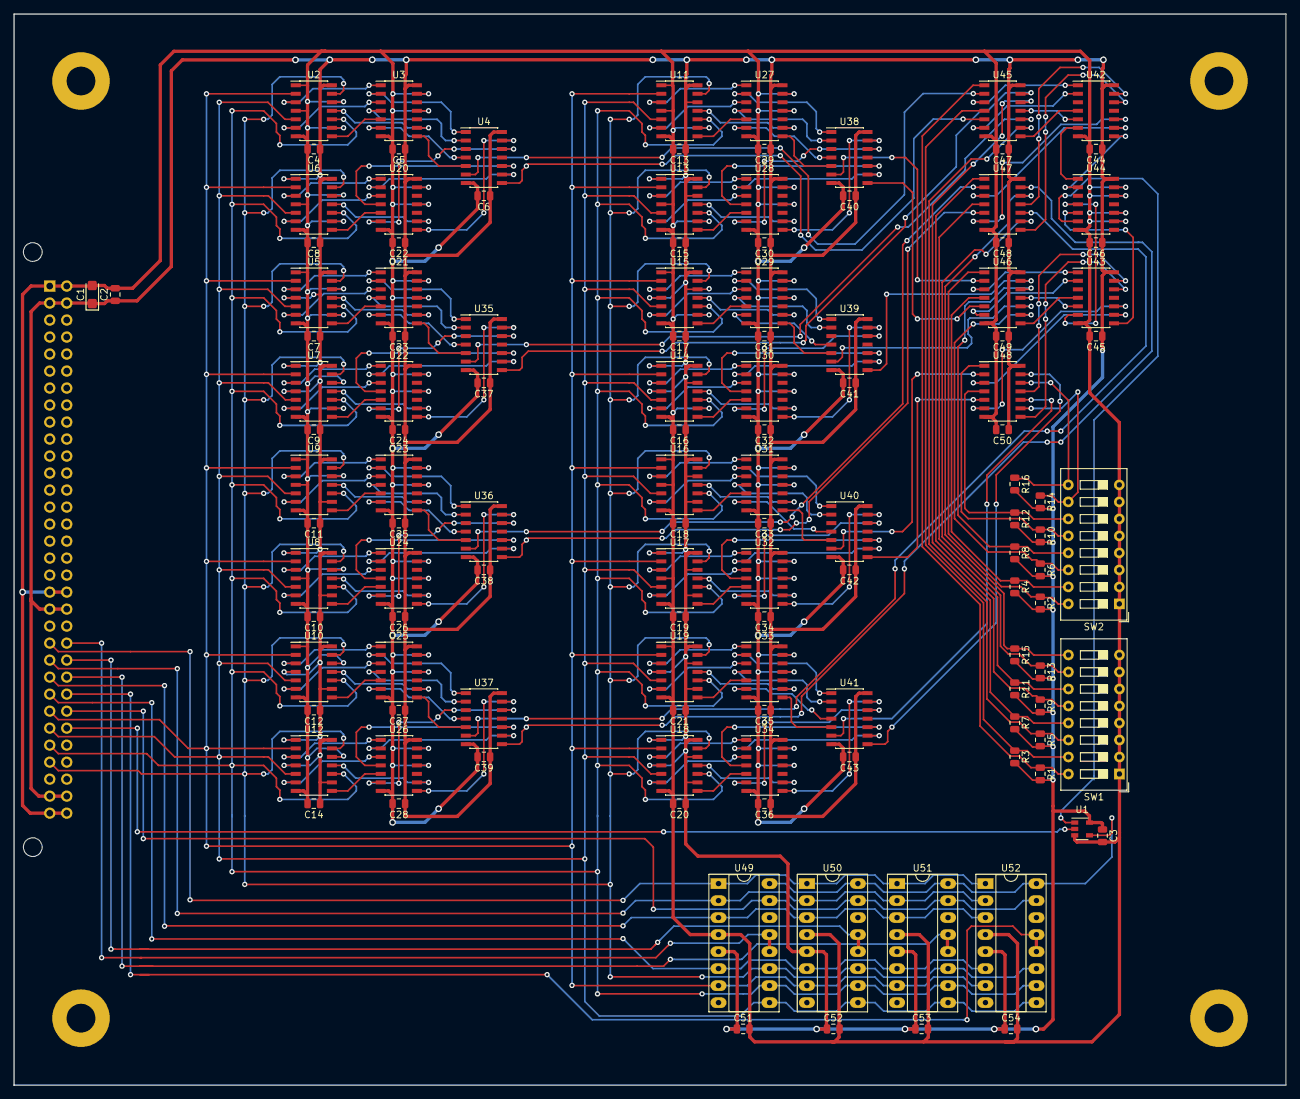
[picture p17: board TD4_RAM.kicad_pcb from above]

Board: 2 copper layers, 190.0 x 160.0 mm, 125 parts (1 on the bottom side), 198 nets.
