fedosgad/TD4/core/TD4_core/TD4_core.kicad_pcb

## KiCad design core/TD4_core/TD4_core.kicad_pcb (2019-02-21)

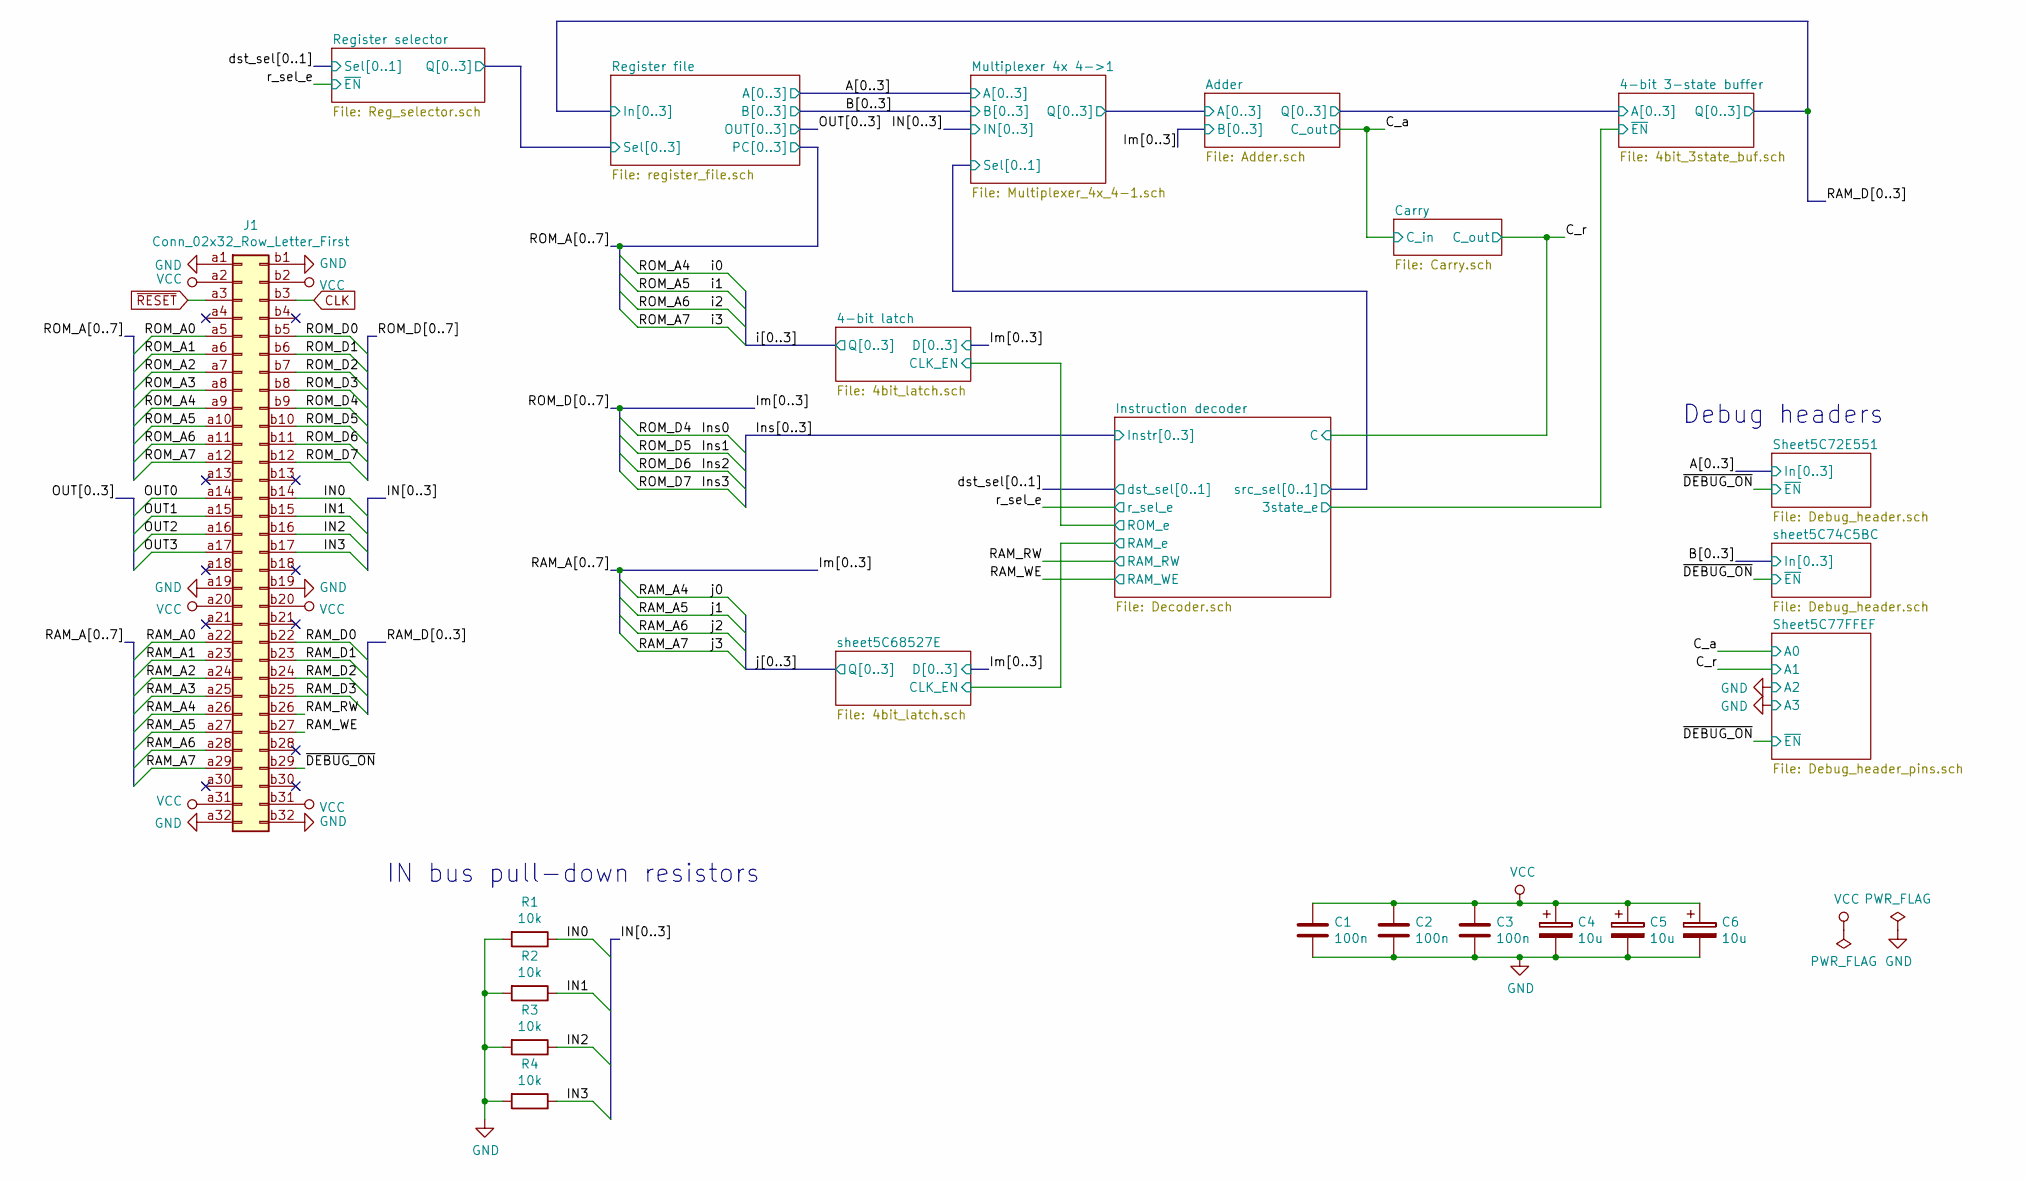
[picture p18: schematic TD4_core.sch, TD4 core module]

Parts:
C1, C2, C3: 100n; C_0805_2012Metric
C4, C5, C6: 10u; CP_EIA-3216-18_Kemet-A
J1: Conn_02x32_Row_Letter_First; DIN41612_B_2x32_Horizontal
R1, R2, R3, R4: 10k; R_0805_2012Metric

Connections:
/IN0: J1.b14, R1.1; also elsewhere on the board
/IN1: J1.b15, R2.1; also elsewhere on the board
/IN2: J1.b16, R3.1; also elsewhere on the board
/IN3: J1.b17, R4.1; also elsewhere on the board
/Ins0: J1.b9; also elsewhere on the board
/Ins1: J1.b10; also elsewhere on the board
/Ins2: J1.b11; also elsewhere on the board
/Ins3: J1.b12; also elsewhere on the board
/OUT0: J1.a14; also elsewhere on the board
/OUT1: J1.a15; also elsewhere on the board
/OUT2: J1.a16; also elsewhere on the board
/OUT3: J1.a17; also elsewhere on the board
/RAM_A4: J1.a26; also elsewhere on the board
/RAM_A5: J1.a27; also elsewhere on the board
/RAM_A6: J1.a28; also elsewhere on the board
/RAM_A7: J1.a29; also elsewhere on the board
/RAM_D0: J1.b22; also elsewhere on the board
/RAM_D1: J1.b23; also elsewhere on the board
/RAM_D2: J1.b24; also elsewhere on the board
/RAM_D3: J1.b25; also elsewhere on the board
/RAM_RW: J1.b26; also elsewhere on the board
/RAM_WE: J1.b27; also elsewhere on the board
/ROM_A0: J1.a5; also elsewhere on the board
/ROM_A1: J1.a6; also elsewhere on the board
/ROM_A2: J1.a7; also elsewhere on the board
/ROM_A3: J1.a8; also elsewhere on the board
/ROM_A4: J1.a9; also elsewhere on the board
/ROM_A5: J1.a10; also elsewhere on the board
/ROM_A6: J1.a11; also elsewhere on the board
/ROM_A7: J1.a12; also elsewhere on the board
/~DEBUG_ON~: J1.b29; also elsewhere on the board
CLK: J1.b3; also elsewhere on the board
~RESET: J1.a3; also elsewhere on the board

Notes on the sheet:
Debug headers
IN bus pull-down resistors

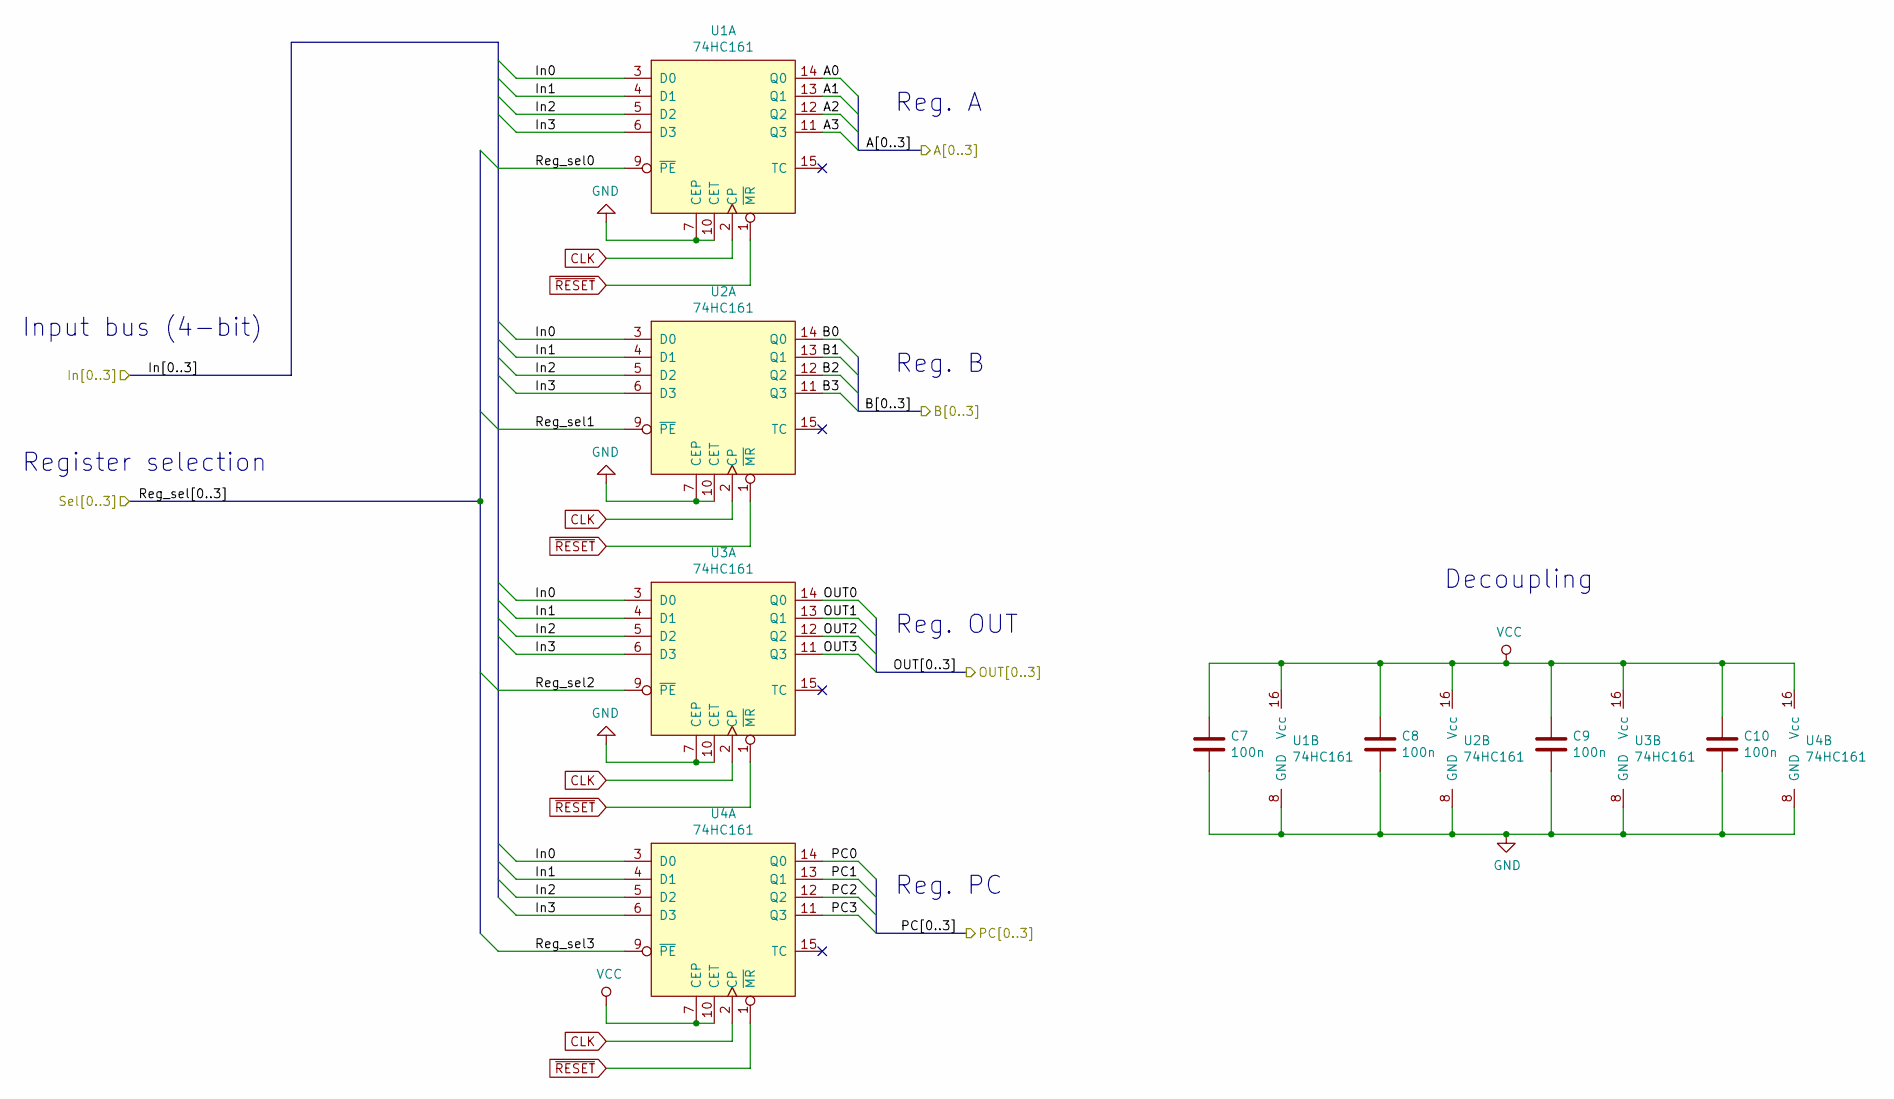
[picture p19: schematic register_file.sch, TD4 core module]

Parts:
C7, C8, C9, C10: 100n; C_0805_2012Metric
U1, U2, U3, U4: 74HC161; SOIC-16_3.9x9.9mm_P1.27mm

Connections:
/Multiplexer 4x 4->1/A0: U1.14 (Q0); also elsewhere on the board
/Multiplexer 4x 4->1/A1: U1.13 (Q1); also elsewhere on the board
/Multiplexer 4x 4->1/A2: U1.12 (Q2); also elsewhere on the board
/Multiplexer 4x 4->1/A3: U1.11 (Q3); also elsewhere on the board
/Multiplexer 4x 4->1/B0: U2.14 (Q0); also elsewhere on the board
/Multiplexer 4x 4->1/B1: U2.13 (Q1); also elsewhere on the board
/Multiplexer 4x 4->1/B2: U2.12 (Q2); also elsewhere on the board
/Multiplexer 4x 4->1/B3: U2.11 (Q3); also elsewhere on the board
/OUT0: U3.14 (Q0); also elsewhere on the board
/OUT1: U3.13 (Q1); also elsewhere on the board
/OUT2: U3.12 (Q2); also elsewhere on the board
/OUT3: U3.11 (Q3); also elsewhere on the board
/RAM_D0: U1.3 (D0), U2.3 (D0), U3.3 (D0), U4.3 (D0); also elsewhere on the board
/RAM_D1: U1.4 (D1), U2.4 (D1), U3.4 (D1), U4.4 (D1); also elsewhere on the board
/RAM_D2: U1.5 (D2), U2.5 (D2), U3.5 (D2), U4.5 (D2); also elsewhere on the board
/RAM_D3: U1.6 (D3), U2.6 (D3), U3.6 (D3), U4.6 (D3); also elsewhere on the board
/ROM_A0: U4.14 (Q0); also elsewhere on the board
/ROM_A1: U4.13 (Q1); also elsewhere on the board
/ROM_A2: U4.12 (Q2); also elsewhere on the board
/ROM_A3: U4.11 (Q3); also elsewhere on the board
/Register selector/Q0: U1.9 (~PE); also elsewhere on the board
/Register selector/Q1: U2.9 (~PE); also elsewhere on the board
/Register selector/Q2: U3.9 (~PE); also elsewhere on the board
/Register selector/Q3: U4.9 (~PE); also elsewhere on the board
CLK: U1.2 (CP), U2.2 (CP), U3.2 (CP), U4.2 (CP); also elsewhere on the board
~RESET: U1.1 (~MR), U2.1 (~MR), U3.1 (~MR), U4.1 (~MR); also elsewhere on the board

Notes on the sheet:
Input bus (4-bit)
Reg. A
Reg. B
Reg. OUT
Reg. PC
Register selection
Decoupling
