fedosgad/TD4/core/TD4_core/TD4_core.kicad_pcb

## KiCad design core/TD4_core/TD4_core.kicad_pcb (continued)

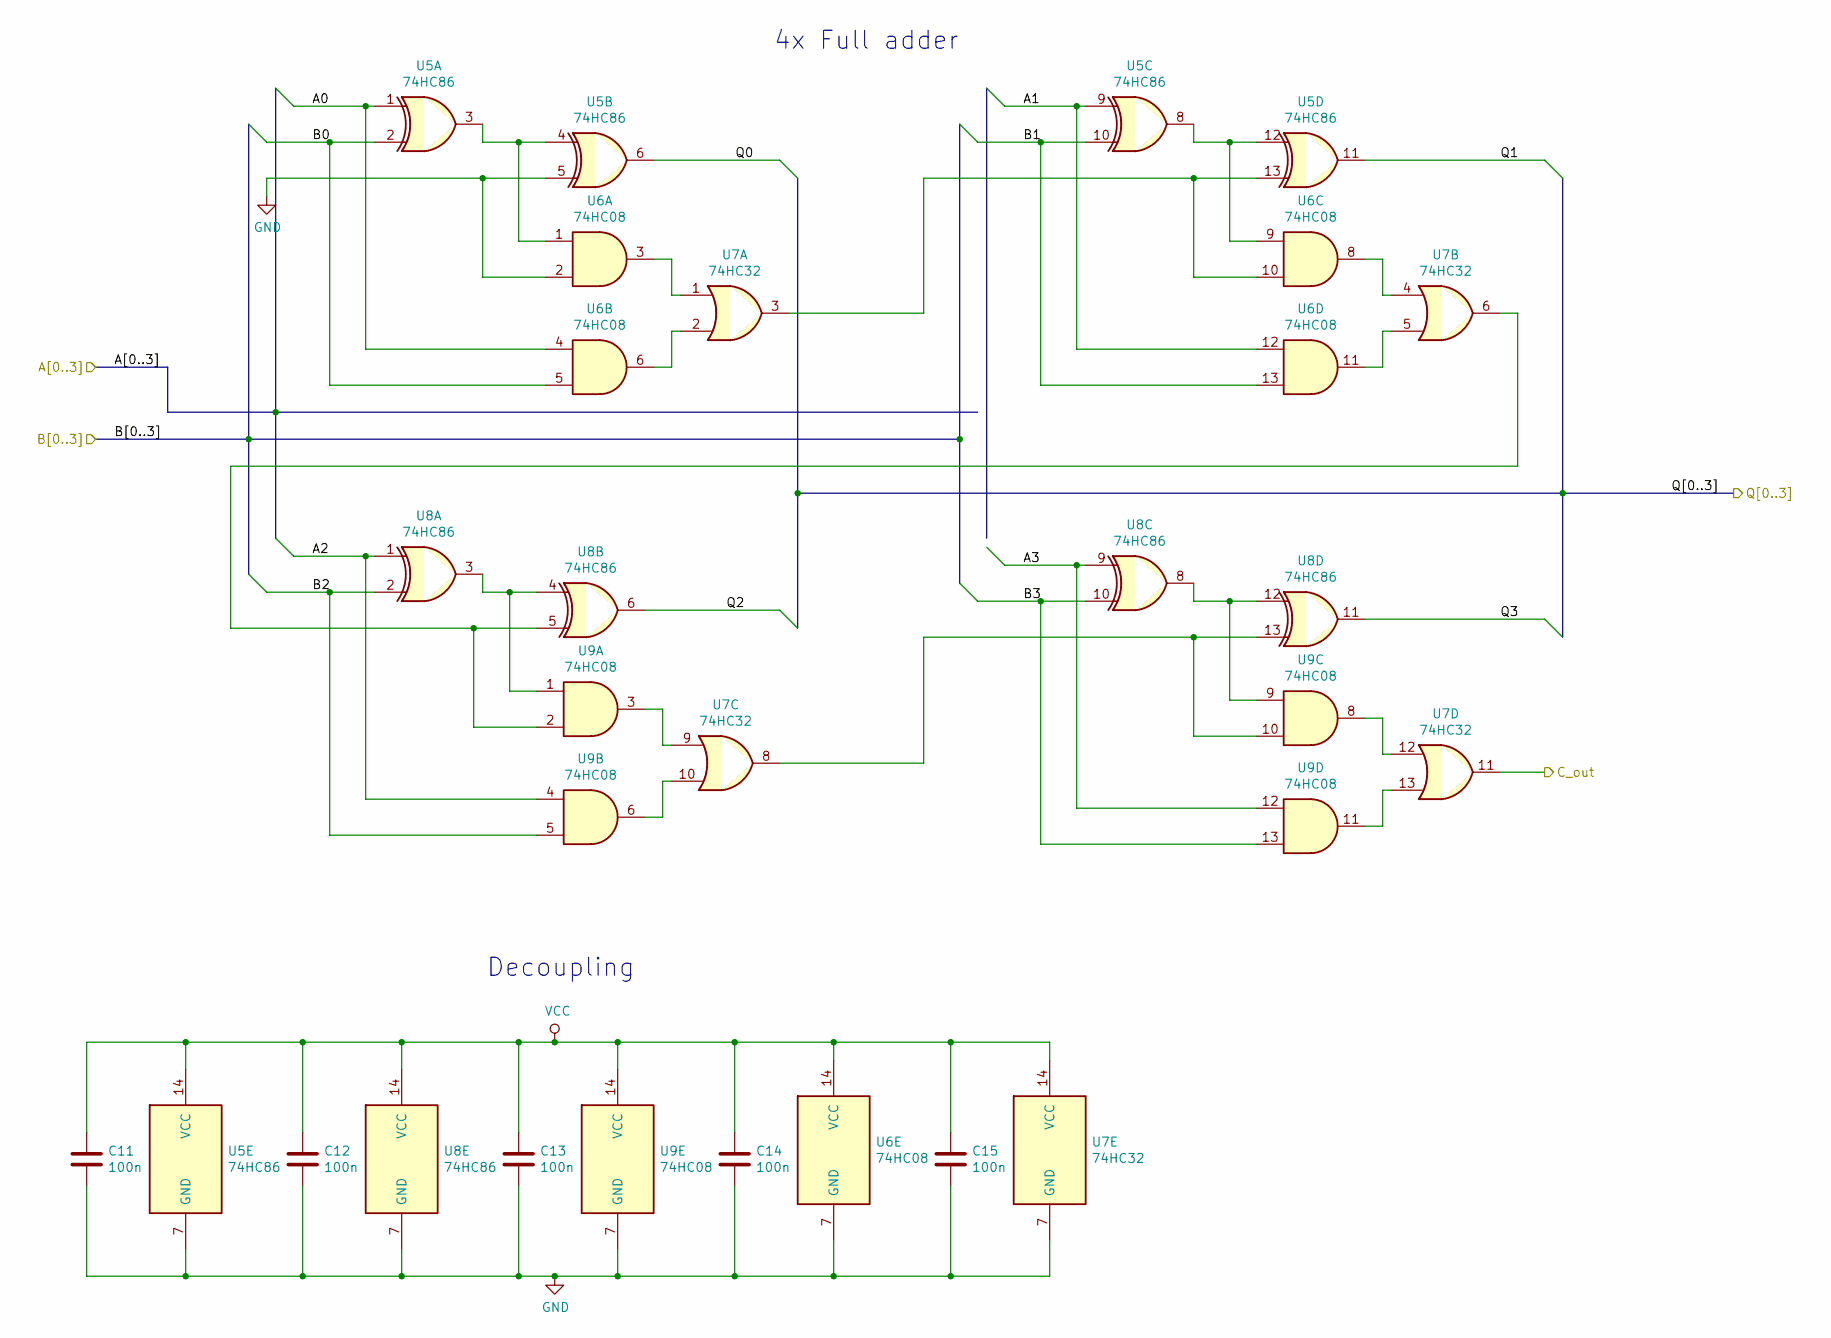
[picture p20: schematic Adder.sch, TD4 core module]

Parts:
C11, C12, C13, C14, C15: 100n; C_0805_2012Metric
U5, U8: 74HC86; SOIC-14_3.9x8.7mm_P1.27mm
U6, U9: 74HC08; SOIC-14_3.9x8.7mm_P1.27mm
U7: 74HC32; SOIC-14_3.9x8.7mm_P1.27mm

Connections:
/4-bit 3-state buffer/A0: U5.6; also elsewhere on the board
/4-bit 3-state buffer/A1: U5.11; also elsewhere on the board
/4-bit 3-state buffer/A2: U8.6; also elsewhere on the board
/4-bit 3-state buffer/A3: U8.11; also elsewhere on the board
/Adder/A0: U5.1, U6.4; also elsewhere on the board
/Adder/A1: U5.9, U6.12; also elsewhere on the board
/Adder/A2: U8.1, U9.4; also elsewhere on the board
/Adder/A3: U8.9, U9.12; also elsewhere on the board
/C_a: U7.11; also elsewhere on the board
unnamed: U5.3, U5.4, U6.1
unnamed: U5.8, U5.12, U6.9
unnamed: U5.13, U6.10, U7.3
unnamed: U6.3, U7.1
unnamed: U6.6, U7.2
unnamed: U6.8, U7.4
unnamed: U6.11, U7.5
unnamed: U7.6, U8.5, U9.2
unnamed: U7.8, U8.13, U9.10
unnamed: U7.9, U9.3
unnamed: U7.10, U9.6
unnamed: U7.12, U9.8
unnamed: U7.13, U9.11
unnamed: U8.3, U8.4, U9.1
unnamed: U8.8, U8.12, U9.9

Notes on the sheet:
Decoupling
4x Full adder

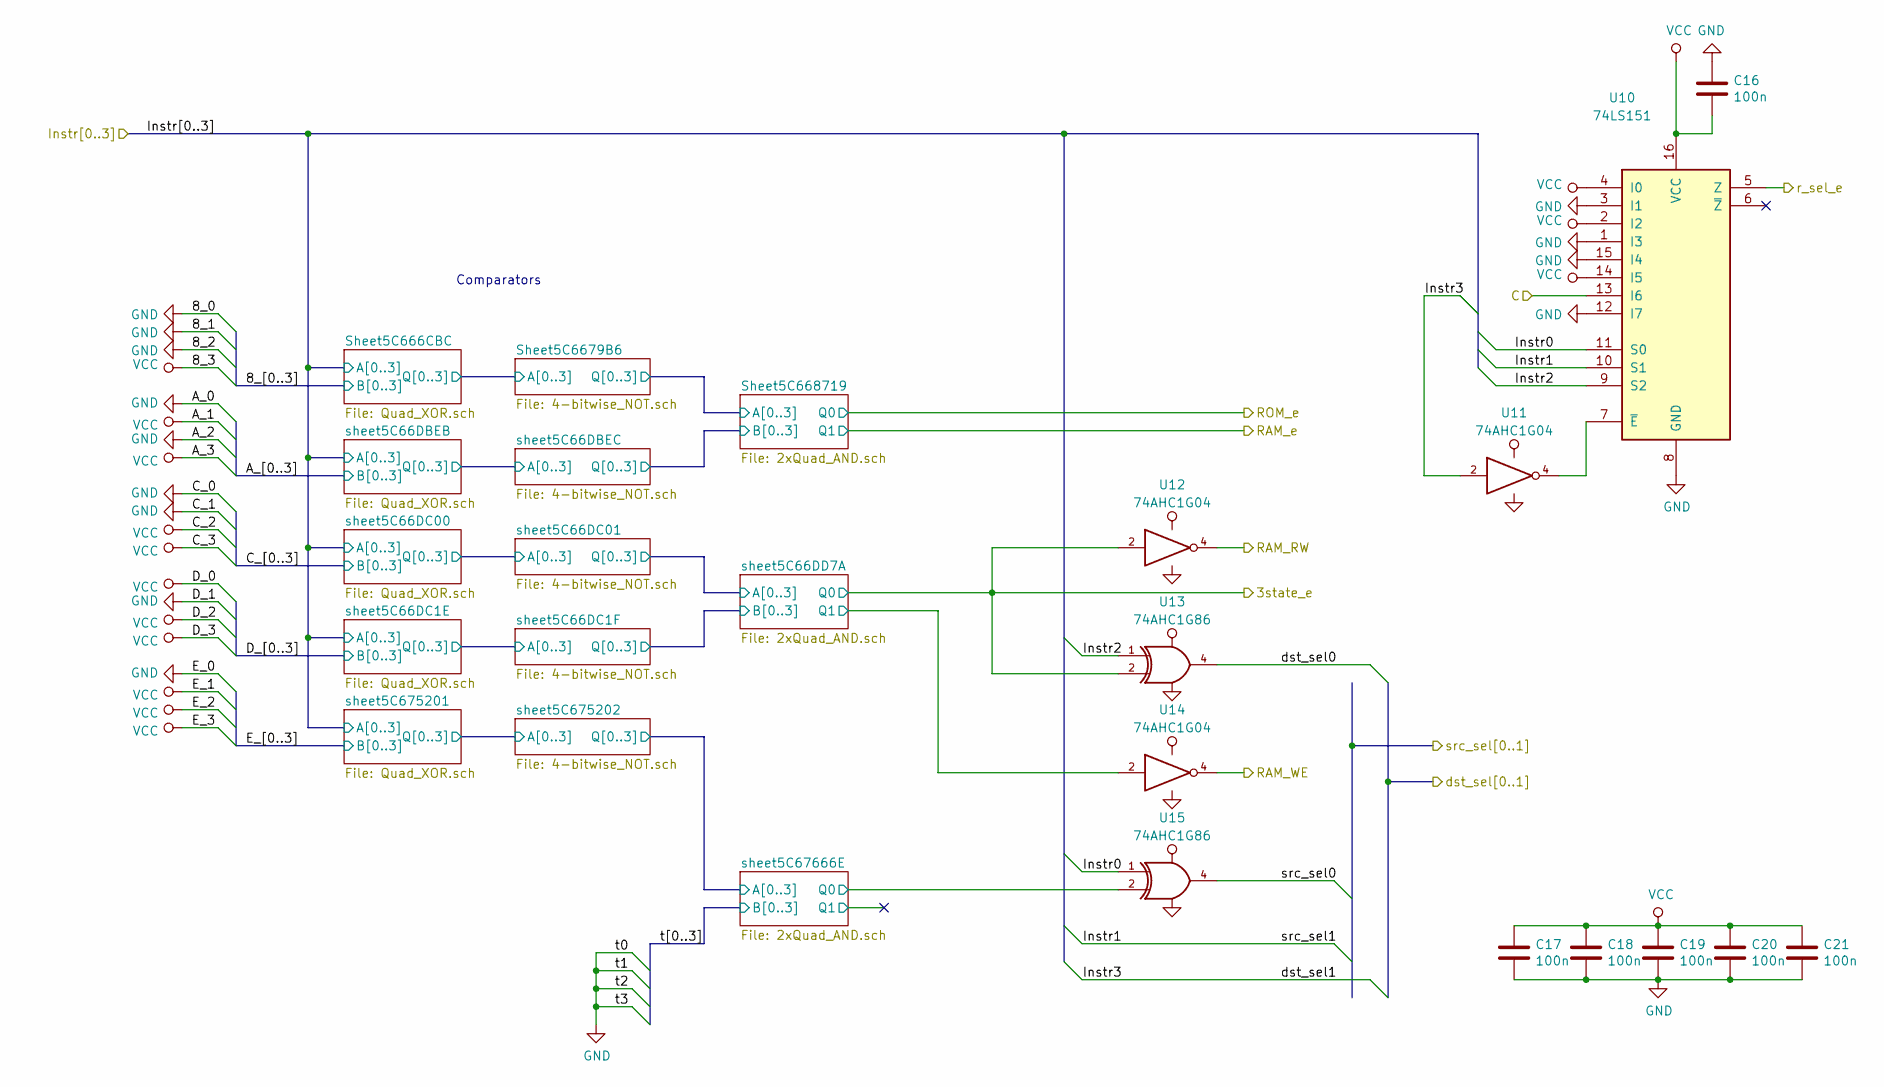
[picture p21: schematic Decoder.sch, TD4 core module]

Parts:
C16, C17, C18, C19, C20, C21: 100n; C_0805_2012Metric
U10: 74LS151; SOIC-16_3.9x9.9mm_P1.27mm
U11, U12, U14: 74AHC1G04; SOT-23-5
U13, U15: 74AHC1G86; SOT-23-5

Connections:
/C_r: U10.13 (I6); also elsewhere on the board
/Ins0: U10.11 (S0), U15.1; also elsewhere on the board
/Ins1: U10.10 (S1); also elsewhere on the board
/Ins2: U10.9 (S2), U13.1; also elsewhere on the board
/Ins3: U11.2; also elsewhere on the board
/Instruction decoder/3state_e: U12.2, U13.2; also elsewhere on the board
/Instruction decoder/sheet5C66DD7A/Q1: U14.2; also elsewhere on the board
/Instruction decoder/sheet5C67666E/Q0: U15.2; also elsewhere on the board
/Multiplexer 4x 4->1/Sel0: U15.4; also elsewhere on the board
/RAM_RW: U12.4; also elsewhere on the board
/RAM_WE: U14.4; also elsewhere on the board
/Register selector/Sel0: U13.4; also elsewhere on the board
/r_sel_e: U10.5 (Z); also elsewhere on the board
unnamed: U10.7 (~E), U11.4

Notes on the sheet:
Comparators

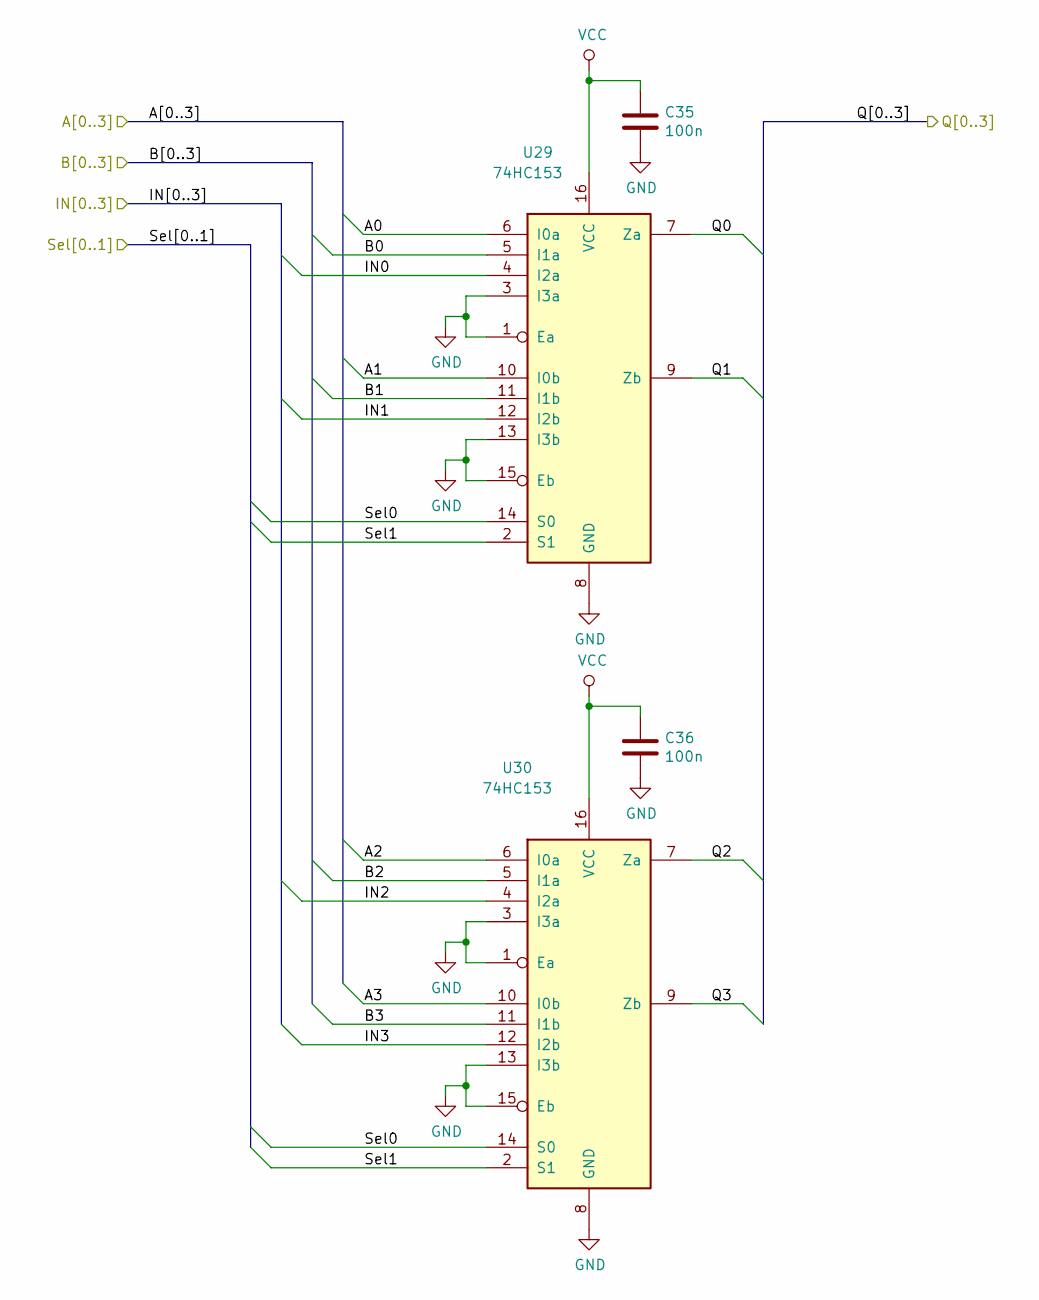
[picture p22: schematic Multiplexer_4x_4-1.sch, TD4 core module]

Parts:
C35, C36: 100n; C_0805_2012Metric
U29, U30: 74HC153; SOIC-16_3.9x9.9mm_P1.27mm

Connections:
/Adder/A0: U29.7 (Za); also elsewhere on the board
/Adder/A1: U29.9 (Zb); also elsewhere on the board
/Adder/A2: U30.7 (Za); also elsewhere on the board
/Adder/A3: U30.9 (Zb); also elsewhere on the board
/IN0: U29.4 (I2a); also elsewhere on the board
/IN1: U29.12 (I2b); also elsewhere on the board
/IN2: U30.4 (I2a); also elsewhere on the board
/IN3: U30.12 (I2b); also elsewhere on the board
/Ins1: U29.2 (S1), U30.2 (S1); also elsewhere on the board
/Multiplexer 4x 4->1/A0: U29.6 (I0a); also elsewhere on the board
/Multiplexer 4x 4->1/A1: U29.10 (I0b); also elsewhere on the board
/Multiplexer 4x 4->1/A2: U30.6 (I0a); also elsewhere on the board
/Multiplexer 4x 4->1/A3: U30.10 (I0b); also elsewhere on the board
/Multiplexer 4x 4->1/B0: U29.5 (I1a); also elsewhere on the board
/Multiplexer 4x 4->1/B1: U29.11 (I1b); also elsewhere on the board
/Multiplexer 4x 4->1/B2: U30.5 (I1a); also elsewhere on the board
/Multiplexer 4x 4->1/B3: U30.11 (I1b); also elsewhere on the board
/Multiplexer 4x 4->1/Sel0: U29.14 (S0), U30.14 (S0); also elsewhere on the board

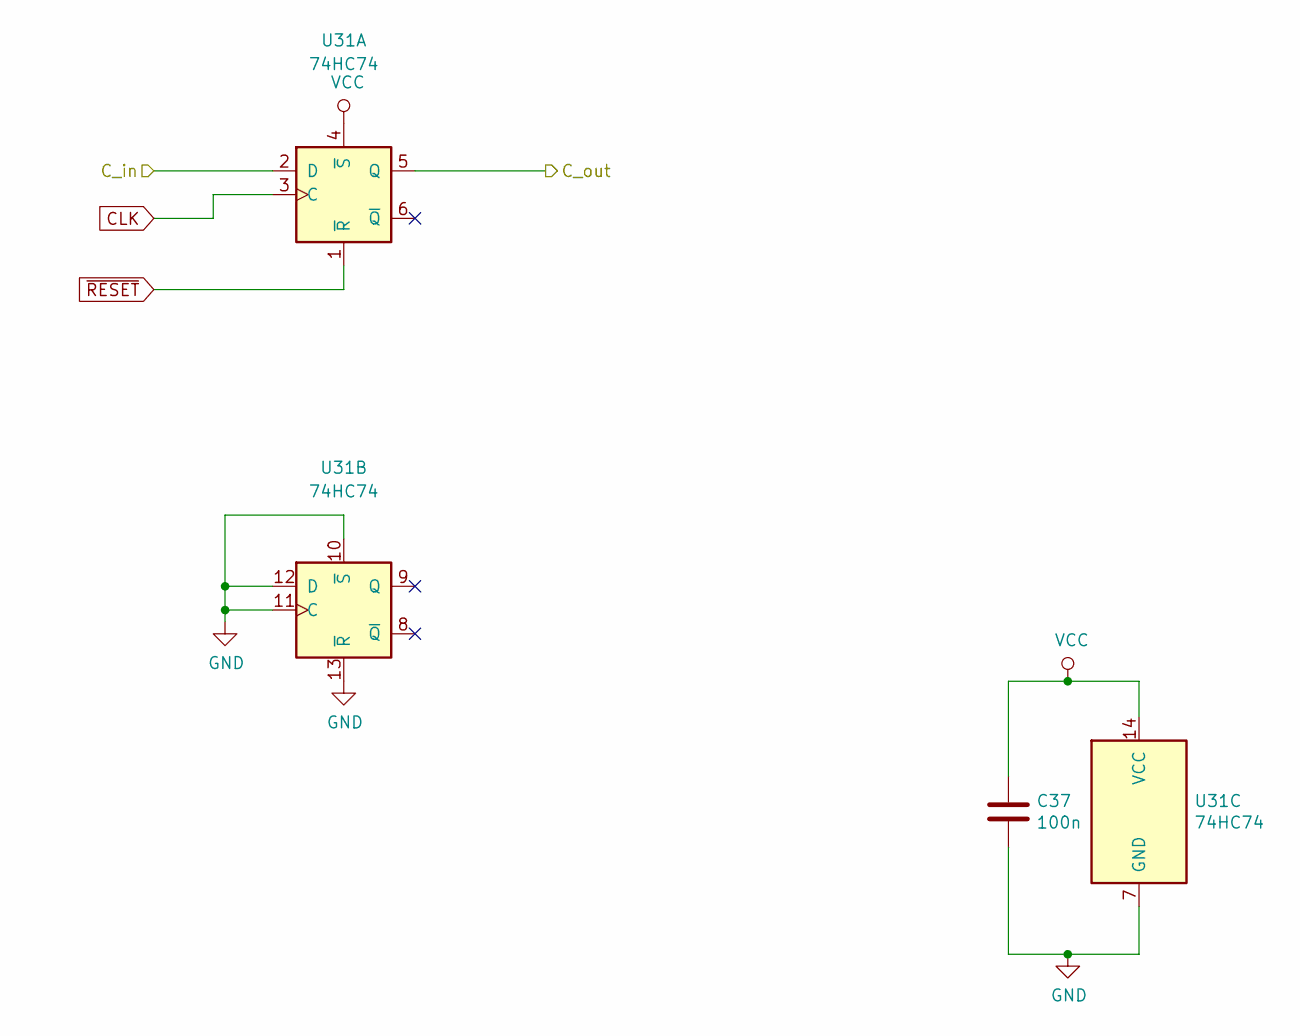
[picture p23: schematic Carry.sch, TD4 core module]

Parts:
C37: 100n; C_0805_2012Metric
U31: 74HC74; SOIC-14_3.9x8.7mm_P1.27mm

Connections:
/C_a: U31.2 (D); also elsewhere on the board
/C_r: U31.5 (Q); also elsewhere on the board
CLK: U31.3 (C); also elsewhere on the board
~RESET: U31.1 (~R); also elsewhere on the board

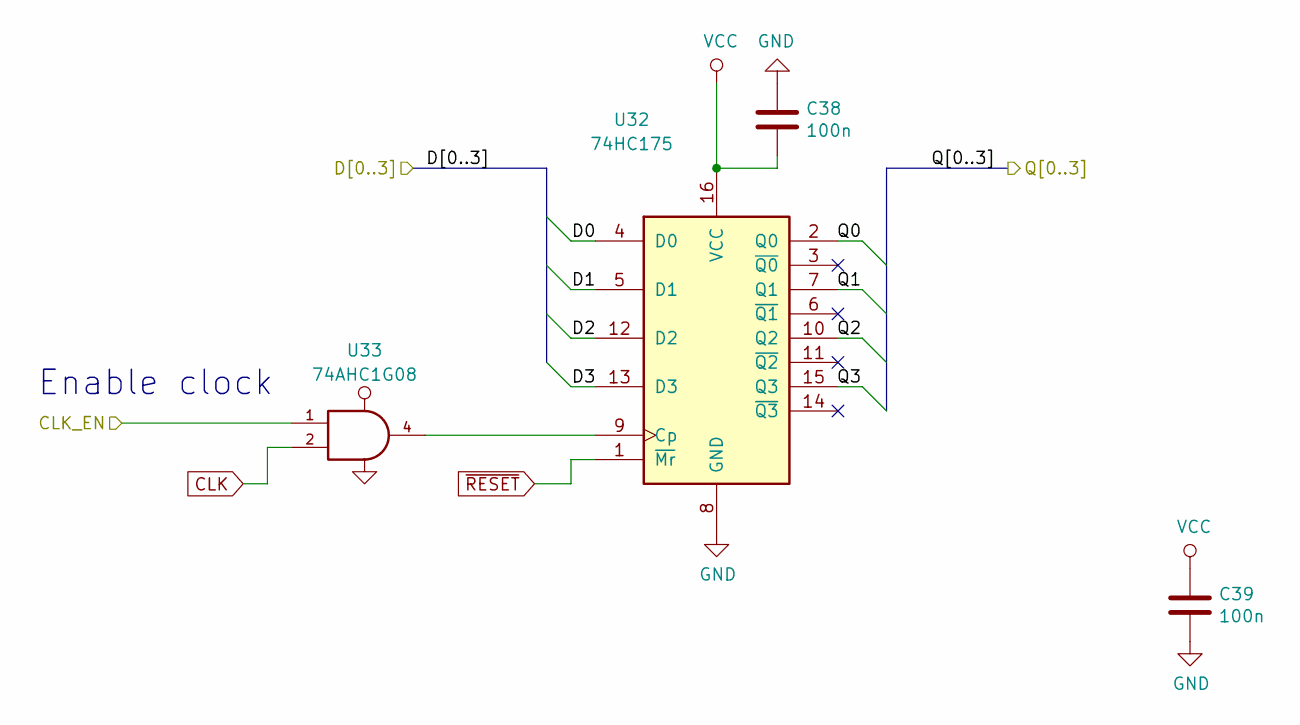
[picture p24: schematic 4bit_latch.sch, TD4 core module]

Parts:
C38, C39: 100n; C_0805_2012Metric
U32: 74HC175; SOIC-16_3.9x9.9mm_P1.27mm
U33: 74AHC1G08; SOT-23-5

Connections:
/4-bit latch/CLK_EN: U33.1; also elsewhere on the board
/ROM_A4: U32.2 (Q0); also elsewhere on the board
/ROM_A5: U32.7 (Q1); also elsewhere on the board
/ROM_A6: U32.10 (Q2); also elsewhere on the board
/ROM_A7: U32.15 (Q3); also elsewhere on the board
CLK: U33.2; also elsewhere on the board
unnamed: U32.9 (Cp), U33.4
~RESET: U32.1 (~Mr); also elsewhere on the board

Parts of its further copies:
C41, C42: 100n; C_0805_2012Metric
U35: 74HC175; SOIC-16_3.9x9.9mm_P1.27mm
U36: 74AHC1G08; SOT-23-5

Connections of its further copies:
/RAM_A4: U35.2 (Q0); also elsewhere on the board
/RAM_A5: U35.7 (Q1); also elsewhere on the board
/RAM_A6: U35.10 (Q2); also elsewhere on the board
/RAM_A7: U35.15 (Q3); also elsewhere on the board
/sheet5C68527E/CLK_EN: U36.1; also elsewhere on the board
CLK: U36.2; also elsewhere on the board
unnamed: U35.9 (Cp), U36.4
~RESET: U35.1 (~Mr); also elsewhere on the board

Notes on the sheet:
Enable clock

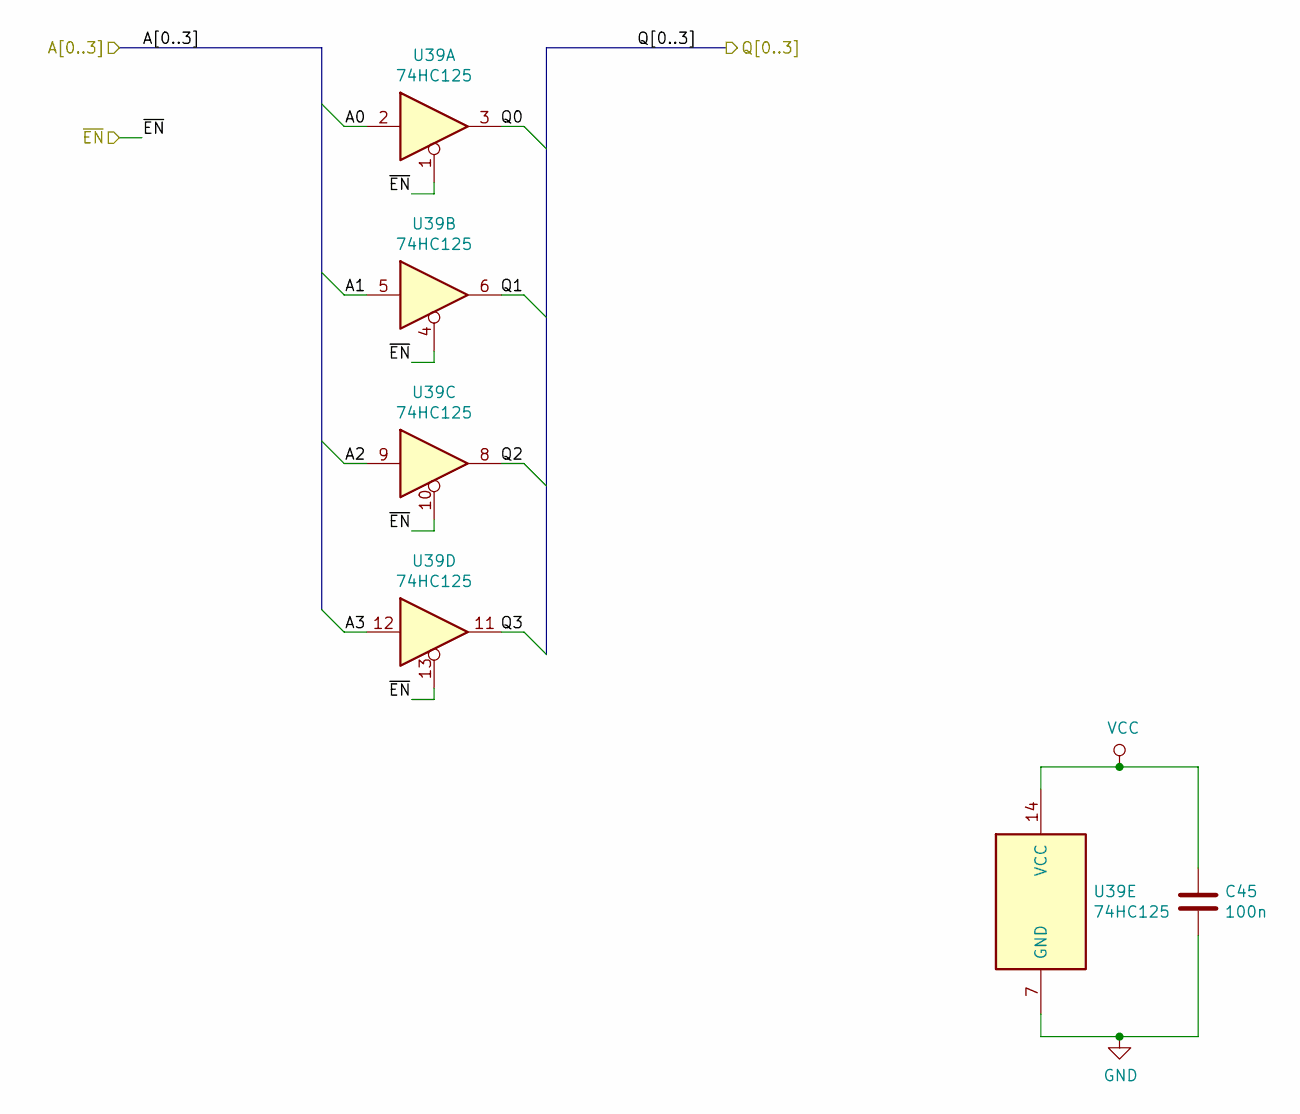
[picture p25: schematic 4bit_3state_buf.sch, TD4 core module]

Parts:
C40: 100n; C_0805_2012Metric
U34: 74HC125; SOIC-14_3.9x8.7mm_P1.27mm

Connections:
/4-bit 3-state buffer/A0: U34.2; also elsewhere on the board
/4-bit 3-state buffer/A1: U34.5; also elsewhere on the board
/4-bit 3-state buffer/A2: U34.9; also elsewhere on the board
/4-bit 3-state buffer/A3: U34.12; also elsewhere on the board
/Instruction decoder/3state_e: U34.1, U34.4, U34.10, U34.13; also elsewhere on the board
/RAM_D0: U34.3; also elsewhere on the board
/RAM_D1: U34.6; also elsewhere on the board
/RAM_D2: U34.8; also elsewhere on the board
/RAM_D3: U34.11; also elsewhere on the board

Parts of its further copies:
C44, C45, C46: 100n; C_0805_2012Metric
U38, U39, U40: 74HC125; SOIC-14_3.9x8.7mm_P1.27mm

Connections of its further copies:
/C_a: U40.2; also elsewhere on the board
/C_r: U40.5; also elsewhere on the board
/Multiplexer 4x 4->1/A0: U38.2; also elsewhere on the board
/Multiplexer 4x 4->1/A1: U38.5; also elsewhere on the board
/Multiplexer 4x 4->1/A2: U38.9; also elsewhere on the board
/Multiplexer 4x 4->1/A3: U38.12; also elsewhere on the board
/Multiplexer 4x 4->1/B0: U39.2; also elsewhere on the board
/Multiplexer 4x 4->1/B1: U39.5; also elsewhere on the board
/Multiplexer 4x 4->1/B2: U39.9; also elsewhere on the board
/Multiplexer 4x 4->1/B3: U39.12; also elsewhere on the board
/Sheet5C72E551/Out0: U38.3; also elsewhere on the board
/Sheet5C72E551/Out1: U38.6; also elsewhere on the board
/Sheet5C72E551/Out2: U38.8; also elsewhere on the board
/Sheet5C72E551/Out3: U38.11; also elsewhere on the board
/Sheet5C77FFEF/sheet5C78000E/Out0: U40.3; also elsewhere on the board
/Sheet5C77FFEF/sheet5C78000E/Out1: U40.6; also elsewhere on the board
/Sheet5C77FFEF/sheet5C78000E/Out2: U40.8; also elsewhere on the board
/Sheet5C77FFEF/sheet5C78000E/Out3: U40.11; also elsewhere on the board
/sheet5C74C5BC/Out0: U39.3; also elsewhere on the board
/sheet5C74C5BC/Out1: U39.6; also elsewhere on the board
/sheet5C74C5BC/Out2: U39.8; also elsewhere on the board
/sheet5C74C5BC/Out3: U39.11; also elsewhere on the board
/~DEBUG_ON~: U38.1, U38.4, U38.10, U38.13, U39.1, U39.4, U39.10, U39.13, U40.1, U40.4, U40.10, U40.13; also elsewhere on the board

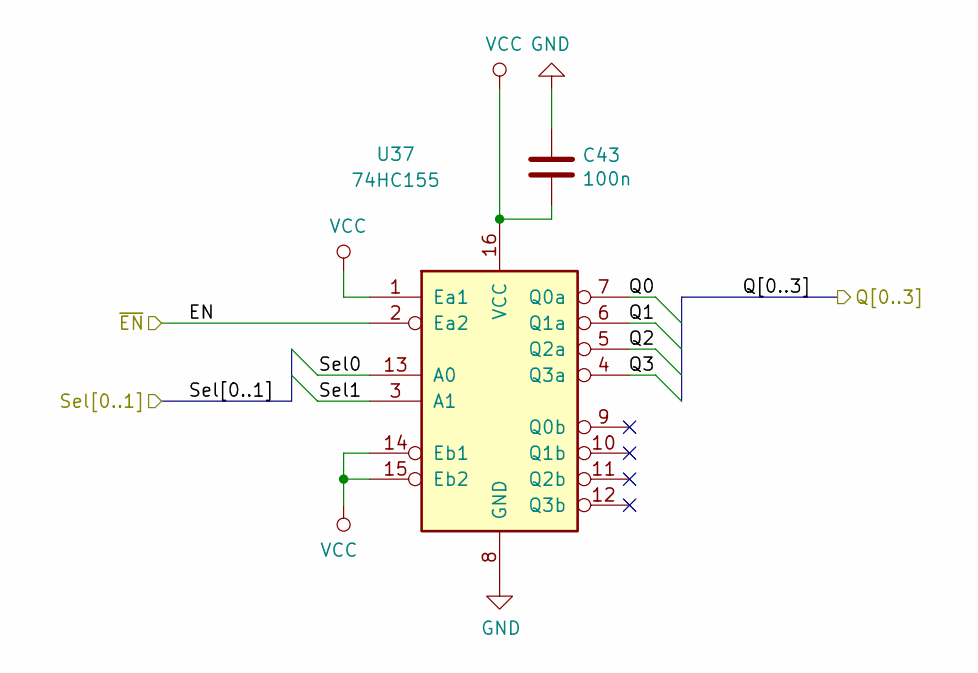
[picture p26: schematic Reg_selector.sch, TD4 core module]

Parts:
C43: 100n; C_0805_2012Metric
U37: 74HC155; SOIC-16_3.9x9.9mm_P1.27mm

Connections:
/Ins3: U37.3 (A1); also elsewhere on the board
/Register selector/Q0: U37.7 (Q0a); also elsewhere on the board
/Register selector/Q1: U37.6 (Q1a); also elsewhere on the board
/Register selector/Q2: U37.5 (Q2a); also elsewhere on the board
/Register selector/Q3: U37.4 (Q3a); also elsewhere on the board
/Register selector/Sel0: U37.13 (A0); also elsewhere on the board
/r_sel_e: U37.2 (Ea2); also elsewhere on the board

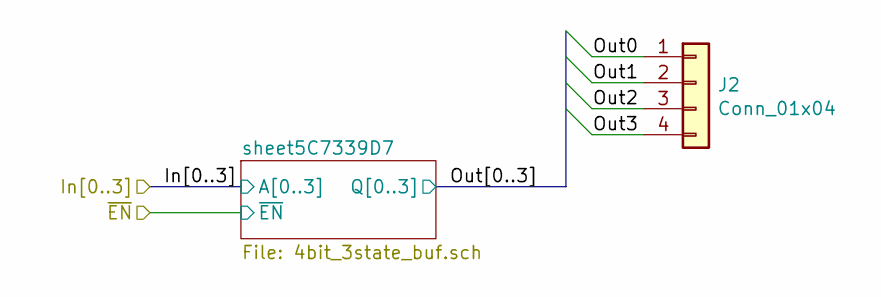
[picture p27: schematic Debug_header.sch]

Parts:
J2: Conn_01x04; PinHeader_1x04_P2.54mm_Vertical

Connections:
/Sheet5C72E551/Out0: J2.1; also elsewhere on the board
/Sheet5C72E551/Out1: J2.2; also elsewhere on the board
/Sheet5C72E551/Out2: J2.3; also elsewhere on the board
/Sheet5C72E551/Out3: J2.4; also elsewhere on the board

Parts of its further copies:
J3, J4: Conn_01x04; PinHeader_1x04_P2.54mm_Vertical

Connections of its further copies:
/Sheet5C77FFEF/sheet5C78000E/Out0: J4.1; also elsewhere on the board
/Sheet5C77FFEF/sheet5C78000E/Out1: J4.2; also elsewhere on the board
/Sheet5C77FFEF/sheet5C78000E/Out2: J4.3; also elsewhere on the board
/Sheet5C77FFEF/sheet5C78000E/Out3: J4.4; also elsewhere on the board
/sheet5C74C5BC/Out0: J3.1; also elsewhere on the board
/sheet5C74C5BC/Out1: J3.2; also elsewhere on the board
/sheet5C74C5BC/Out2: J3.3; also elsewhere on the board
/sheet5C74C5BC/Out3: J3.4; also elsewhere on the board

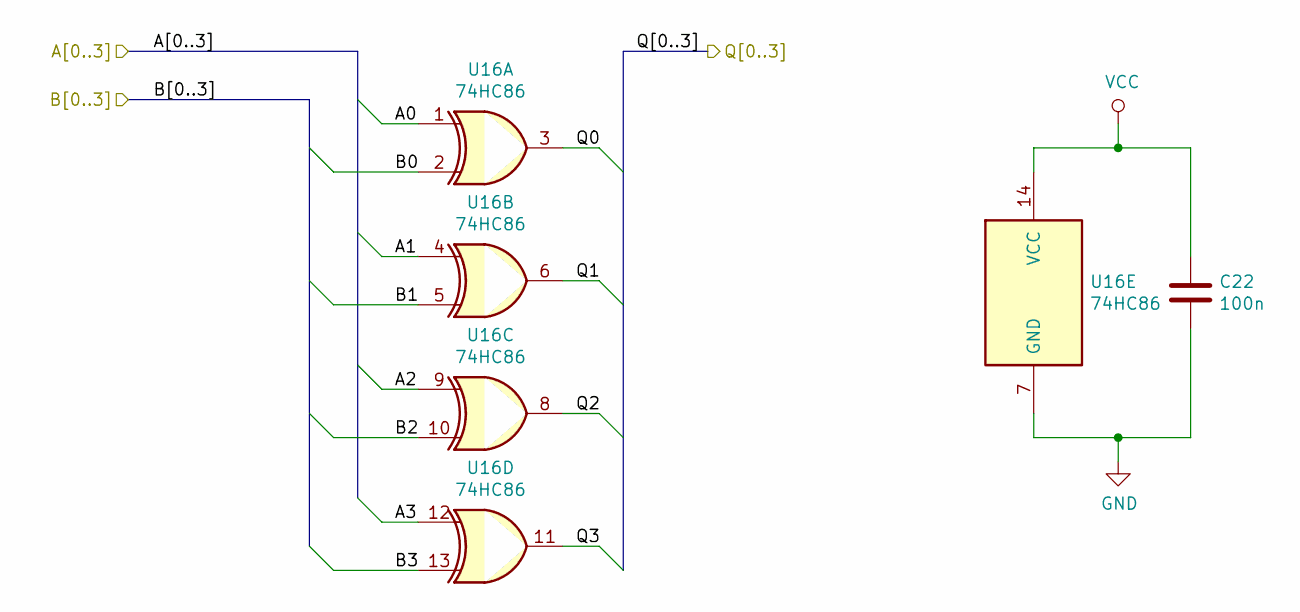
[picture p28: schematic Quad_XOR.sch, TD4 core module]

Parts:
C22: 100n; C_0805_2012Metric
U16: 74HC86; SOIC-14_3.9x8.7mm_P1.27mm

Connections:
/Ins0: U16.1; also elsewhere on the board
/Ins1: U16.4; also elsewhere on the board
/Ins2: U16.9; also elsewhere on the board
/Ins3: U16.12; also elsewhere on the board
/Instruction decoder/Sheet5C6679B6/A0: U16.3; also elsewhere on the board
/Instruction decoder/Sheet5C6679B6/A1: U16.6; also elsewhere on the board
/Instruction decoder/Sheet5C6679B6/A2: U16.8; also elsewhere on the board
/Instruction decoder/Sheet5C6679B6/A3: U16.11; also elsewhere on the board

Parts of its further copies:
C25, C27, C29, C32: 100n; C_0805_2012Metric
U19, U21, U23, U26: 74HC86; SOIC-14_3.9x8.7mm_P1.27mm

Connections of its further copies:
/Ins0: U19.1, U21.1, U23.1, U26.1; also elsewhere on the board
/Ins1: U19.4, U21.4, U23.4, U26.4; also elsewhere on the board
/Ins2: U19.9, U21.9, U23.9, U26.9; also elsewhere on the board
/Ins3: U19.12, U21.12, U23.12, U26.12; also elsewhere on the board
/Instruction decoder/sheet5C66DBEC/A0: U19.3; also elsewhere on the board
/Instruction decoder/sheet5C66DBEC/A1: U19.6; also elsewhere on the board
/Instruction decoder/sheet5C66DBEC/A2: U19.8; also elsewhere on the board
/Instruction decoder/sheet5C66DBEC/A3: U19.11; also elsewhere on the board
/Instruction decoder/sheet5C66DC01/A0: U21.3; also elsewhere on the board
/Instruction decoder/sheet5C66DC01/A1: U21.6; also elsewhere on the board
/Instruction decoder/sheet5C66DC01/A2: U21.8; also elsewhere on the board
/Instruction decoder/sheet5C66DC01/A3: U21.11; also elsewhere on the board
/Instruction decoder/sheet5C66DC1F/A0: U23.3; also elsewhere on the board
/Instruction decoder/sheet5C66DC1F/A1: U23.6; also elsewhere on the board
/Instruction decoder/sheet5C66DC1F/A2: U23.8; also elsewhere on the board
/Instruction decoder/sheet5C66DC1F/A3: U23.11; also elsewhere on the board
/Instruction decoder/sheet5C675202/A0: U26.3; also elsewhere on the board
/Instruction decoder/sheet5C675202/A1: U26.6; also elsewhere on the board
/Instruction decoder/sheet5C675202/A2: U26.8; also elsewhere on the board
/Instruction decoder/sheet5C675202/A3: U26.11; also elsewhere on the board

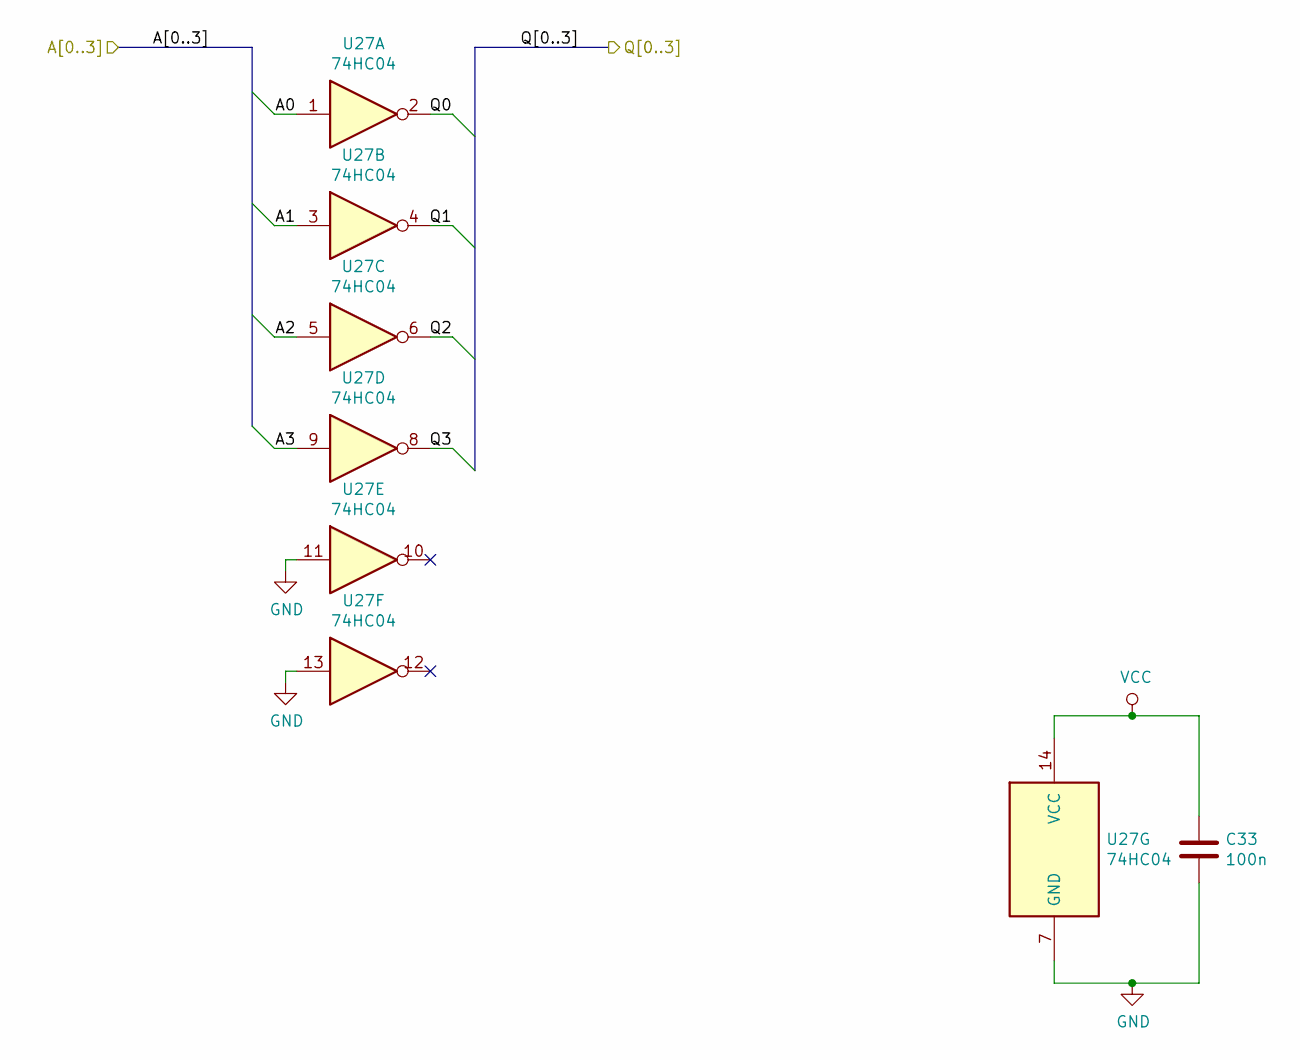
[picture p29: schematic 4-bitwise_NOT.sch, TD4 core module]

Parts:
C23: 100n; C_0805_2012Metric
U17: 74HC04; SOIC-14_3.9x8.7mm_P1.27mm

Connections:
/Instruction decoder/Sheet5C6679B6/A0: U17.1; also elsewhere on the board
/Instruction decoder/Sheet5C6679B6/A1: U17.3; also elsewhere on the board
/Instruction decoder/Sheet5C6679B6/A2: U17.5; also elsewhere on the board
/Instruction decoder/Sheet5C6679B6/A3: U17.9; also elsewhere on the board
/Instruction decoder/Sheet5C668719/A0: U17.2; also elsewhere on the board
/Instruction decoder/Sheet5C668719/A1: U17.4; also elsewhere on the board
/Instruction decoder/Sheet5C668719/A2: U17.6; also elsewhere on the board
/Instruction decoder/Sheet5C668719/A3: U17.8; also elsewhere on the board

Parts of its further copies:
C26, C28, C30, C33: 100n; C_0805_2012Metric
U20, U22, U24, U27: 74HC04; SOIC-14_3.9x8.7mm_P1.27mm

Connections of its further copies:
/Instruction decoder/Sheet5C668719/B0: U20.2; also elsewhere on the board
/Instruction decoder/Sheet5C668719/B1: U20.4; also elsewhere on the board
/Instruction decoder/Sheet5C668719/B2: U20.6; also elsewhere on the board
/Instruction decoder/Sheet5C668719/B3: U20.8; also elsewhere on the board
/Instruction decoder/sheet5C66DBEC/A0: U20.1; also elsewhere on the board
/Instruction decoder/sheet5C66DBEC/A1: U20.3; also elsewhere on the board
/Instruction decoder/sheet5C66DBEC/A2: U20.5; also elsewhere on the board
/Instruction decoder/sheet5C66DBEC/A3: U20.9; also elsewhere on the board
/Instruction decoder/sheet5C66DC01/A0: U22.1; also elsewhere on the board
/Instruction decoder/sheet5C66DC01/A1: U22.3; also elsewhere on the board
/Instruction decoder/sheet5C66DC01/A2: U22.5; also elsewhere on the board
/Instruction decoder/sheet5C66DC01/A3: U22.9; also elsewhere on the board
/Instruction decoder/sheet5C66DC1F/A0: U24.1; also elsewhere on the board
/Instruction decoder/sheet5C66DC1F/A1: U24.3; also elsewhere on the board
/Instruction decoder/sheet5C66DC1F/A2: U24.5; also elsewhere on the board
/Instruction decoder/sheet5C66DC1F/A3: U24.9; also elsewhere on the board
/Instruction decoder/sheet5C66DD7A/A0: U22.2; also elsewhere on the board
/Instruction decoder/sheet5C66DD7A/A1: U22.4; also elsewhere on the board
/Instruction decoder/sheet5C66DD7A/A2: U22.6; also elsewhere on the board
/Instruction decoder/sheet5C66DD7A/A3: U22.8; also elsewhere on the board
/Instruction decoder/sheet5C66DD7A/B0: U24.2; also elsewhere on the board
/Instruction decoder/sheet5C66DD7A/B1: U24.4; also elsewhere on the board
/Instruction decoder/sheet5C66DD7A/B2: U24.6; also elsewhere on the board
/Instruction decoder/sheet5C66DD7A/B3: U24.8; also elsewhere on the board
/Instruction decoder/sheet5C67666E/A0: U27.2; also elsewhere on the board
/Instruction decoder/sheet5C67666E/A1: U27.4; also elsewhere on the board
/Instruction decoder/sheet5C67666E/A2: U27.6; also elsewhere on the board
/Instruction decoder/sheet5C67666E/A3: U27.8; also elsewhere on the board
/Instruction decoder/sheet5C675202/A0: U27.1; also elsewhere on the board
/Instruction decoder/sheet5C675202/A1: U27.3; also elsewhere on the board
/Instruction decoder/sheet5C675202/A2: U27.5; also elsewhere on the board
/Instruction decoder/sheet5C675202/A3: U27.9; also elsewhere on the board
