fedosgad/TD4/core/TD4_core/TD4_core.kicad_pcb

## KiCad design core/TD4_core/TD4_core.kicad_pcb (continued)

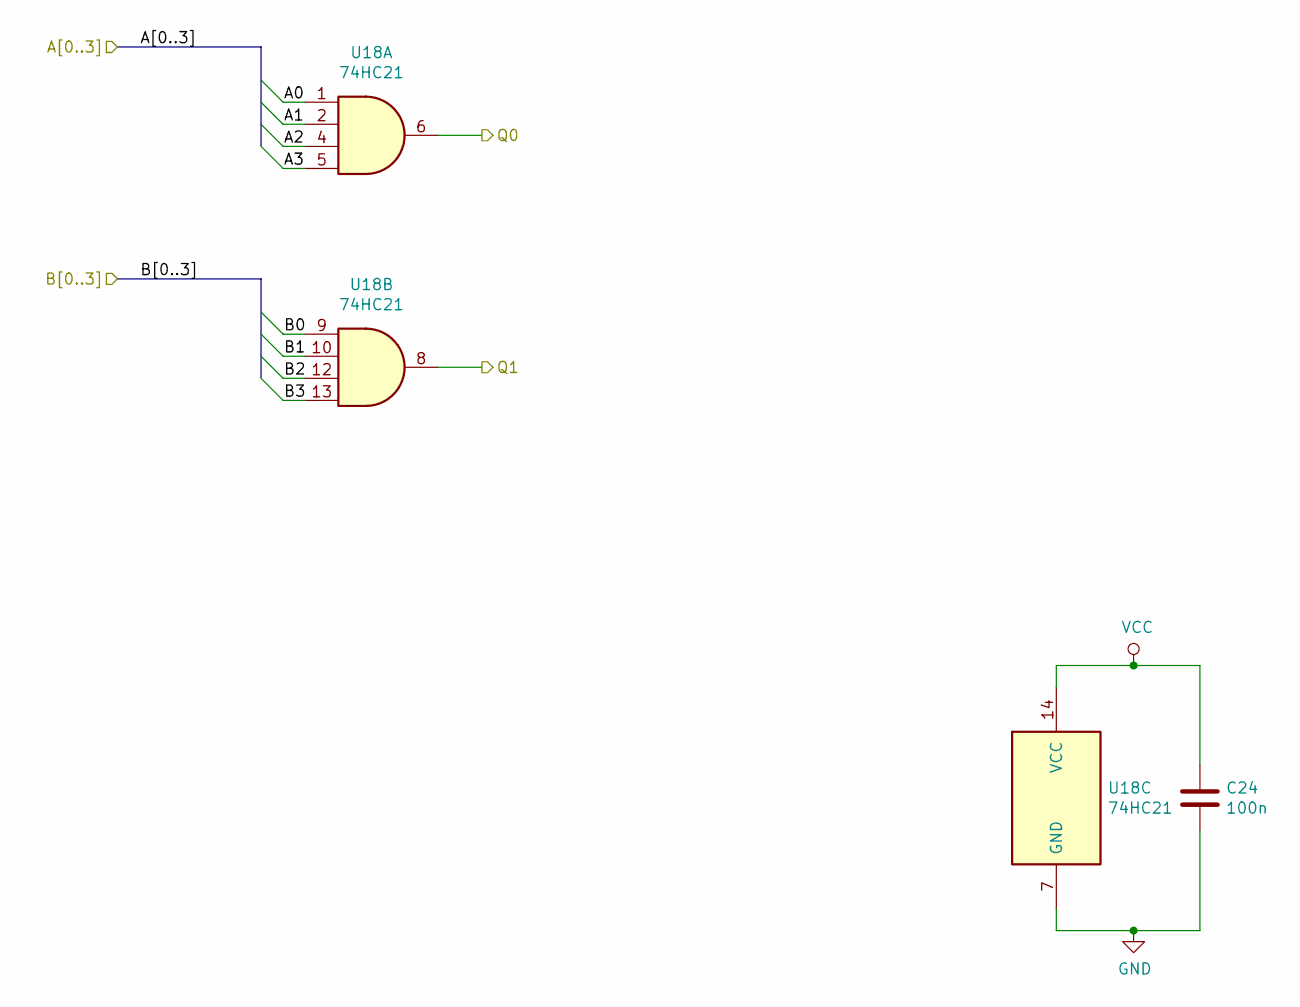
[picture p30: schematic 2xQuad_AND.sch, TD4 core module]

Parts:
C24: 100n; C_0805_2012Metric
U18: 74HC21; SOIC-14_3.9x8.7mm_P1.27mm

Connections:
/4-bit latch/CLK_EN: U18.6; also elsewhere on the board
/Instruction decoder/Sheet5C668719/A0: U18.1; also elsewhere on the board
/Instruction decoder/Sheet5C668719/A1: U18.2; also elsewhere on the board
/Instruction decoder/Sheet5C668719/A2: U18.4; also elsewhere on the board
/Instruction decoder/Sheet5C668719/A3: U18.5; also elsewhere on the board
/Instruction decoder/Sheet5C668719/B0: U18.9; also elsewhere on the board
/Instruction decoder/Sheet5C668719/B1: U18.10; also elsewhere on the board
/Instruction decoder/Sheet5C668719/B2: U18.12; also elsewhere on the board
/Instruction decoder/Sheet5C668719/B3: U18.13; also elsewhere on the board
/sheet5C68527E/CLK_EN: U18.8; also elsewhere on the board

Parts of its further copies:
C31, C34: 100n; C_0805_2012Metric
U25, U28: 74HC21; SOIC-14_3.9x8.7mm_P1.27mm

Connections of its further copies:
/Instruction decoder/3state_e: U25.6; also elsewhere on the board
/Instruction decoder/sheet5C66DD7A/A0: U25.1; also elsewhere on the board
/Instruction decoder/sheet5C66DD7A/A1: U25.2; also elsewhere on the board
/Instruction decoder/sheet5C66DD7A/A2: U25.4; also elsewhere on the board
/Instruction decoder/sheet5C66DD7A/A3: U25.5; also elsewhere on the board
/Instruction decoder/sheet5C66DD7A/B0: U25.9; also elsewhere on the board
/Instruction decoder/sheet5C66DD7A/B1: U25.10; also elsewhere on the board
/Instruction decoder/sheet5C66DD7A/B2: U25.12; also elsewhere on the board
/Instruction decoder/sheet5C66DD7A/B3: U25.13; also elsewhere on the board
/Instruction decoder/sheet5C66DD7A/Q1: U25.8; also elsewhere on the board
/Instruction decoder/sheet5C67666E/A0: U28.1; also elsewhere on the board
/Instruction decoder/sheet5C67666E/A1: U28.2; also elsewhere on the board
/Instruction decoder/sheet5C67666E/A2: U28.4; also elsewhere on the board
/Instruction decoder/sheet5C67666E/A3: U28.5; also elsewhere on the board
/Instruction decoder/sheet5C67666E/Q0: U28.6; also elsewhere on the board
/Instruction decoder/sheet5C67666E/Q1: U28.8

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
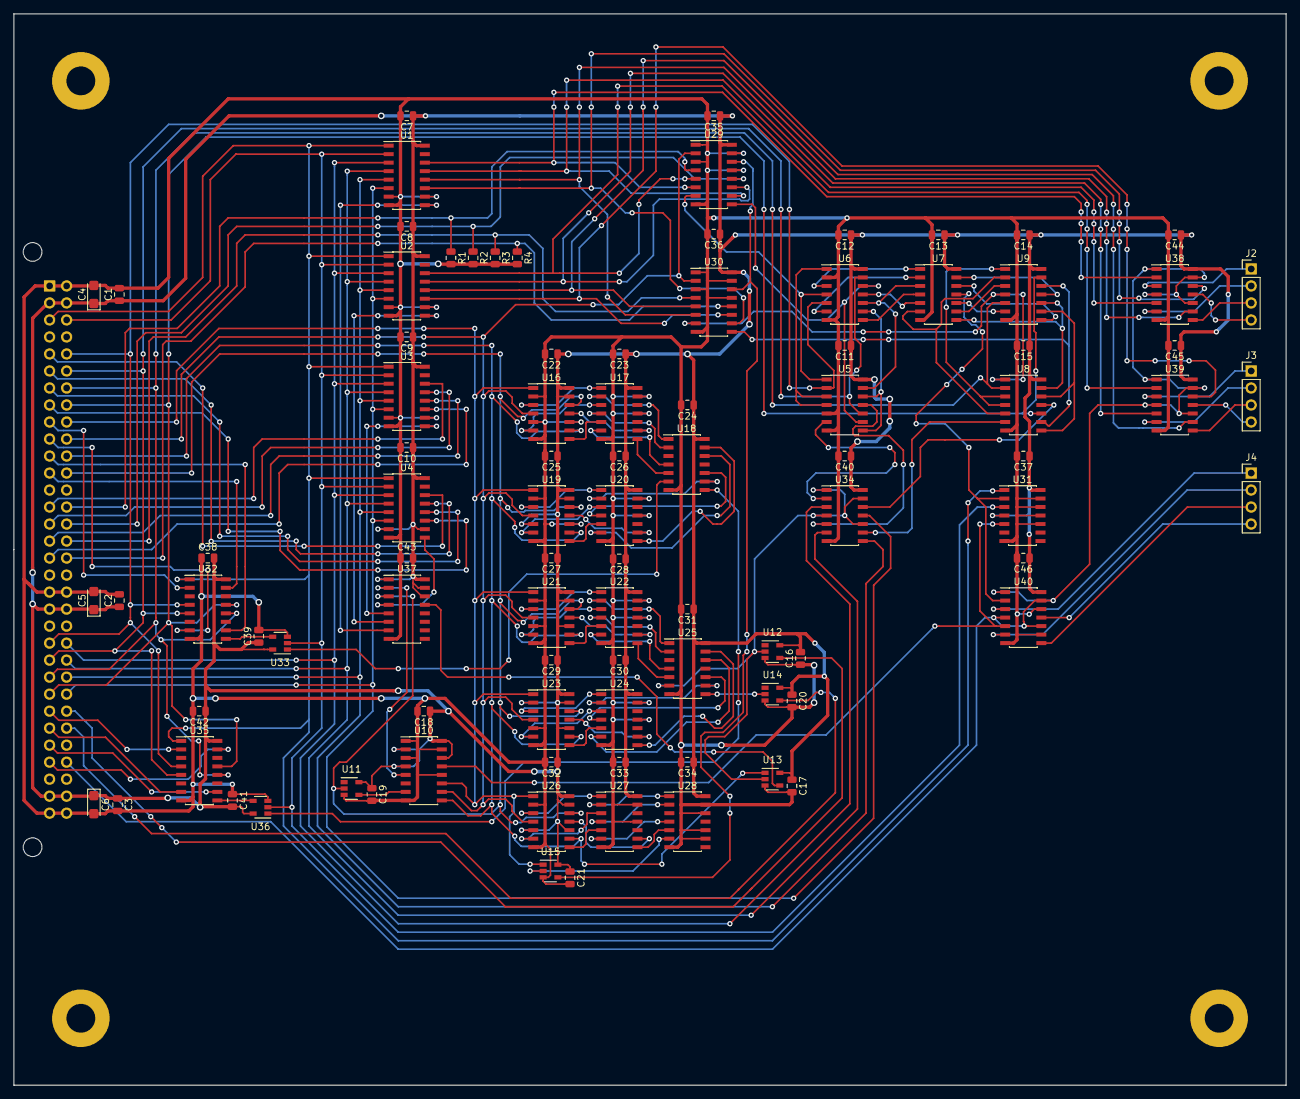
[picture p31: board TD4_core.kicad_pcb from above]

Board: 2 copper layers, 190.0 x 160.0 mm, 94 parts (1 on the bottom side), 139 nets.
