fedosgad/TD4/ROM/TD4_ROM/TD4_ROM.sch

## KiCad design ROM/TD4_ROM/TD4_ROM.sch (2019-02-18)

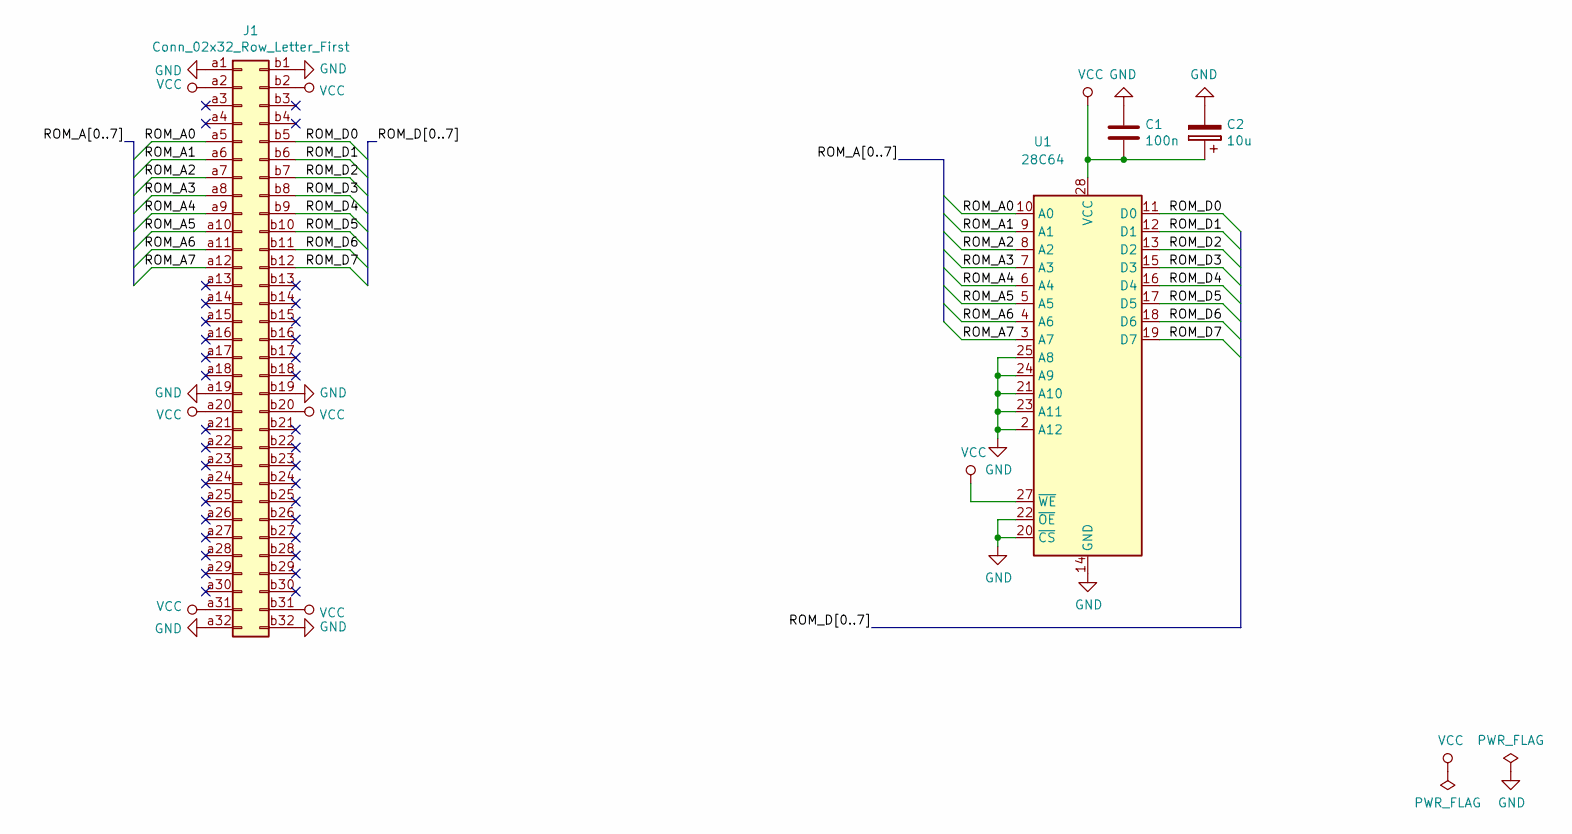
[picture p32: schematic TD4_ROM.sch]

Parts:
C1: 100n; C_0805_2012Metric
C2: 10u; CP_EIA-3216-18_Kemet-A
J1: Conn_02x32_Row_Letter_First; DIN41612_B_2x32_Horizontal
U1: 28C64; DIP-28_W15.24mm_Socket_LongPads

Connections:
GND: C1.1, C2.2, J1.a1, J1.a19, J1.a32, J1.b1, J1.b19, J1.b32, U1.2 (A12), U1.14 (GND), U1.20 (~CS), U1.21 (A10), U1.22 (~OE), U1.23 (A11), U1.24 (A9), U1.25 (A8)
ROM_A0: J1.a5, U1.10 (A0)
ROM_A1: J1.a6, U1.9 (A1)
ROM_A2: J1.a7, U1.8 (A2)
ROM_A3: J1.a8, U1.7 (A3)
ROM_A4: J1.a9, U1.6 (A4)
ROM_A5: J1.a10, U1.5 (A5)
ROM_A6: J1.a11, U1.4 (A6)
ROM_A7: J1.a12, U1.3 (A7)
ROM_D0: J1.b5, U1.11 (D0)
ROM_D1: J1.b6, U1.12 (D1)
ROM_D2: J1.b7, U1.13 (D2)
ROM_D3: J1.b8, U1.15 (D3)
ROM_D4: J1.b9, U1.16 (D4)
ROM_D5: J1.b10, U1.17 (D5)
ROM_D6: J1.b11, U1.18 (D6)
ROM_D7: J1.b12, U1.19 (D7)
VCC: C1.2, C2.1, J1.a2, J1.a20, J1.a31, J1.b2, J1.b20, J1.b31, U1.27 (~WE), U1.28 (VCC)
