fedosgad/TD4/verilog/TD4_vanilla.sv

module TD4_vanilla
	(
	input logic [3:0] Instr, Im, In,
	input logic n_reset, clk,
	output logic [3:0] Out, Adr
	);
	
	logic [3:0] sum, A, B, src;
	logic [1:0] src_sel;
	logic sel_A, sel_B, sel_Out, sel_PC, flag_in, flag_out;
	
	//registers
	gen_reg reg_A(clk, n_reset, sel_A, sum, A);
	gen_reg reg_B(clk, n_reset, sel_B, sum, B);
	gen_reg reg_Out(clk, n_reset, sel_Out, sum, Out);
	inc_reg reg_PC(clk, n_reset, sel_PC, sum, Adr);
	
	//source selection
	mux_4to1(A, B, In, '0, src_sel, src);
	
	//adder and carry flag
	adder(src, Im, sum, flag_in);
		//always enabled 1-bit register
	gen_reg #(1) flag(clk, n_reset, 1'b0, flag_in, flag_out);
	
	//decoder
	vanilla_decoder(Instr, flag_out, src_sel, sel_A, sel_B, sel_Out, sel_PC);

endmodule
