fedosgad/TD4/(commit log)

2019-02-06 Work already done
    [Adder.sch, Carry.sch, Decoder.sch, Multiplexer_4x_4-1.sch, TD4_core.kicad_pcb, TD4_core.sch, register_file.sch]
2019-02-07 Started with RAM
    [Memory_block.sch, TD4_RAM.kicad_pcb, TD4_RAM.sch]
2019-02-07 Address decoder done
    [Adr_comp.sch, Bank_sel.sch, Memory_block.sch, Quad_XNOR.sch, TD4_RAM.sch]
2019-02-08 RAM done (sort of)
    [Adr_comp.sch, Bank_sel.sch, Memory_block.sch, Quad_XNOR.sch, TD4_RAM.sch]
2019-02-08 ROM done
    [TD4_ROM.kicad_pcb, TD4_ROM.sch]
2019-02-08 Started refactoring
    [Adder.sch, Adr_comp.sch, Bank_sel.sch, Carry.sch, Decoder.sch, Memory_block.sch, Multiplexer_4x_4-1.sch, Quad_XNOR.sch]
2019-02-08 RAM refactoring goes on
    [2xQuad_AND.sch, 4-bitwise_NOT.sch, Adder.sch, Adr_comp.sch, And16.sch, Bank_sel.sch, Carry.sch, Memory_block.sch]
2019-02-08 RAM done (damn buses\!)
    [16-bitwise_XOR.sch, 2xQuad_AND.sch, 4-bitwise_NOT.sch, Adr_comp.sch, And16.sch, Bank_sel.sch, Bank_witches.sch, Memory_block.sch]
2019-02-08 ROM refactoring done
    [TD4_ROM.sch]
2019-02-08 Main core schematic done; only decoder left
    [4bit_2to1_mux.sch, 4bit_3state_buf.sch, 4bit_latch.sch, Adder.sch, Carry.sch, Decoder.sch, Multiplexer_4x_4-1.sch, TD4_core.sch]
2019-02-12 Core assembled; decoder left
    [4bit_3state_buf.sch, 4bit_latch.sch, Adder.sch, Carry.sch, Multiplexer_4x_4-1.sch, TD4_core.sch, register_file.sch]
2019-02-14 Decoder done (finally!)
    [2xQuad_AND.sch, 4-bitwise_NOT.sch, 4bit_3state_buf.sch, 4bit_latch.sch, Adder.sch, Bank_switches.sch, Carry.sch, Decoder.sch]
2019-02-17 Core schematic done. Backplane connector added, including separate .sch file to append.
    [2xQuad_AND.sch, 4-bitwise_NOT.sch, 4bit_3state_buf.sch, 4bit_latch.sch, Adder.sch, Backplane_connector.sch, Carry.sch, Decoder.sch]
2019-02-18 Added debug headers to core
    [2xQuad_AND.sch, 4-bitwise_NOT.sch, 4bit_3state_buf.sch, 4bit_latch.sch, Adder.sch, Carry.sch, Debug_header.sch, Debug_header_pins.sch]
2019-02-18 Added backplane connectors to all PCBs
    [16-bitwise_XOR.sch, 2xQuad_AND.sch, 4-bitwise_NOT.sch, And16.sch, Bank_switches.sch, Memory_block.sch, Numbers.sch, Quad_XOR.sch]
2019-02-18 Started with backplane
    [TD4_backplane.kicad_pcb, TD4_backplane.sch]
2019-02-18 Fixed minor core PCB errors
    [2xQuad_AND.sch, 4-bitwise_NOT.sch, 4bit_3state_buf.sch, 4bit_latch.sch, Adder.sch, Carry.sch, Debug_header.sch, Decoder.sch]
2019-02-19 Added IN bus pull-ups in core
    [Debug_header.sch, TD4_core.sch]
2019-02-20 Started routing core PCB
    [4bit_3state_buf.sch, Adder.sch, TD4_core.sch]
2019-02-20 Adder and decoder done
    [TD4_core.kicad_pcb]
2019-02-20 Minor core blocks routed
    [TD4_core.kicad_pcb]
2019-02-20 Routed most of data path
    [TD4_core.kicad_pcb]
2019-02-20 Started tieing it all together
    [TD4_core.kicad_pcb]
2019-02-21 Core routed
    [TD4_core.kicad_pcb]
2019-02-21 DRC violations fixed; edge cuts added
    [TD4_core.kicad_pcb]
2019-02-21 Replaced debug headers with vertical ones
    [2xQuad_AND.sch, 4bit_3state_buf.sch, 4bit_latch.sch, Debug_header.sch, Quad_XOR.sch, TD4_core.kicad_pcb]
2019-02-21 Minor changes to PCB
    [TD4_core.kicad_pcb]
2019-02-26 Main RAM blocks routed
    [16-bitwise_XOR.sch, 2xQuad_AND.sch, 4-bitwise_NOT.sch, And16.sch, Bank_switches.sch, Memory_block.sch, Numbers.sch, Quad_XOR.sch]
2019-02-27 RAM routing done
    [And16.sch, TD4_RAM.kicad_pcb]
2019-03-18 ROM routing done
    [Backplane_connector.sch, Decoder.sch, Multiplexer_4x_4-1.sch, Reg_selector.sch]
2019-03-20 Backplane routed
    [TD4_backplane.sch]
2019-03-23 Clock/reset PCB routed
    [clock_reset.kicad_pcb, clock_reset.sch]
2019-03-26 Added 6th slot to the backplane
    [TD4_backplane.kicad_pcb, TD4_backplane.sch]
2019-03-29 Made front panel circuit
    [4_LED_buffered.sch, front_panel.kicad_pcb, front_panel.sch]
